kleinnconrad/prototyping.rc.speedrun/readme.md

# 1:10 onroad RC car for speeds over 100 km/h

This project covers the system architecture and configuration of an 1:10 scale on-road touring car with the design goal of a consistently repeatable top speed of over 100 km/h without risking the car to be damaged or destroyed. The focus is on maximizing drive power while ensuring reliability and cost efficiency.

The technical challenge primarily results from the chosen scale and the limited tire diameter of 64 millimeters. While vehicles from 1:8+ scale have strong physical advantages due to higher mass inertia, larger rolling circumferences, and a longer wheelbase, the 1:10 scale requires significantly higher rotor speeds. This leads to high mechanical stresses in the drivetrain. The low vehicle weight also requires precise aerodynamic and suspension tuning to ensure driving stability at high speeds.

The artefacts of this repository are:
* Architecture decision records (ADRs) in the `/architecture` directory
* System specification in the `specs/full_spec.yaml` file
* Vehicle setup configurations in the `/setup_sheets` directory
* CAD designs of the speedrun chassis (chassis plate, bulkheads, top brace, shock towers and their assembly) and 3D print files in the `/cad` directory: STEP, STL and DXF files, parameter files and drawings, described in the [CAD readme](cad/readme.md)

<table>
  <tbody>
    <tr>
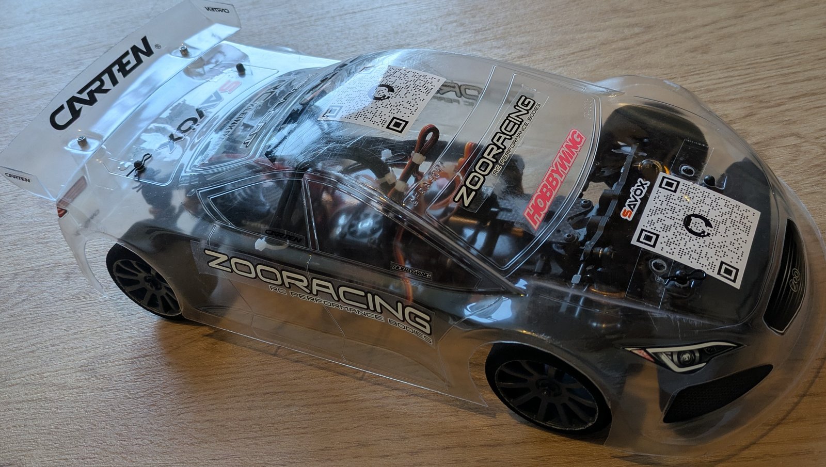
[picture p1: photos/rc_car.jpg]
RC car with clear body
      <td colspan="2"></td>
    </tr>
  </tbody>
  <tbody>
    <tr>
      <td width="37%">RC car chassis without body, front view</td>
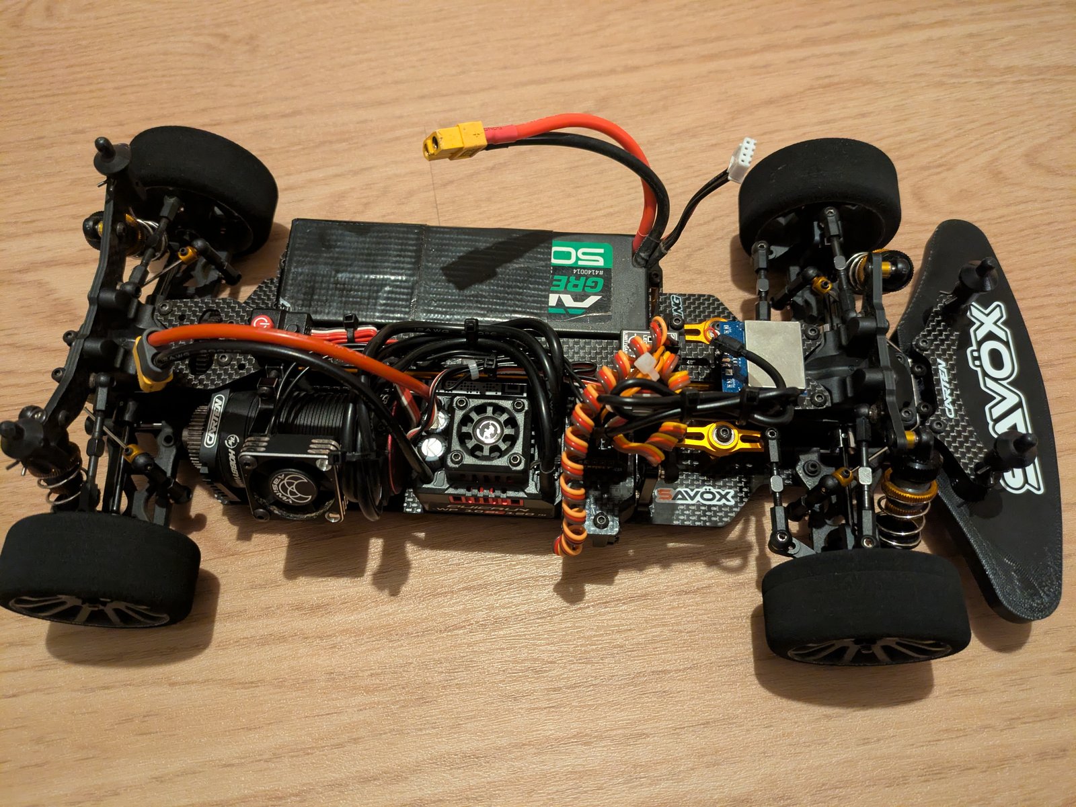
[picture p2: photos/rc_car_chassis_top_view_battery.jpg]
RC car chassis without body, top view
      <td width="63%"></td>
    </tr>
  </tbody>
</table>

## Table of contents
* [Latest setup drawing](#latest-setup-drawing)
* [Speedrun chassis design](#speedrun-chassis-design)
* [Repository structure](#repository-structure)
* [Artefacts (ADR, specs, setup sheets)](#artefacts-adr-specs-setup-sheets)
* [Calculation models for drivetrain design](#calculation-models-for-drivetrain-design)
* [Learnings & modifications](#learnings--modifications)
* [Repository automation](#repository-automation)
* [Follow-up project: Telemetry system](#follow-up-project-telemetry-system)
* [Copyright](#copyright)

## Latest setup drawing
The technical drawing shows the configuration of the latest setup sheet in a side view, a plan view and views of the front and rear axle. It also contains all setup parameters, values derived from them and the changes between the setup sheet versions. Values in orange are taken from the setup sheet, the chassis dimensions from the Carten T410R specification. Component positions are schematic.

The drawing is generated by `scripts/generate_setup_drawing.py` and is updated automatically when a new setup sheet is pushed to the main branch. The setup dashboard on GitHub Pages shows the same drawing in a dark variant.

Technical drawing of the latest Carten T410R setup

## Speedrun chassis design
The speedrun chassis is designed in this project for speeds over 100 km/h. It consists of a wide aluminium chassis plate that matches the body, new bulkheads (gear boxes) for CNC manufacturing from 7075, a new top brace and new front and rear shock towers. The parts share their interfaces with the stock parts of the Carten T410R: bearings, gears, suspension and screws are not changed.

**Motivation for the speedrun parts:**
* Aluminium: the parts are designed so that they can be made from aluminium. The aluminium parts increase the stability of the car.
* CNC machining: the chassis plate (6082) is CNC machined because of the precision required for its countersunk holes (6.2 mm, on the underside). The bulkheads (7075) are three-dimensional parts with bearing seats, gear cavities, tapped holes and several levels. They cannot be laser cut and are CNC milled (3 setups on a 3-axis machine).
* Laser cutting: the top brace (2 mm) and the shock towers (3 mm) are flat plates with plain holes, so that they can be laser cut from aluminium or another material of choice (for example carbon). The outline and the holes are taken from the DXF files. The edge and hole chamfers and the relief on the back face of the shock towers (clearance to the root radius of the wall of the upper bulkhead) are a second machining step.
* Simple design: a further goal is a simplified design of the bulkheads, the shock towers and the top brace with flat faces, straight edges and radii.
* Chassis plate: apart from the material, the speedrun chassis plate is designed to match the ZooRacing Hellcat body (190 mm). It also gives more space for further developments: a battery with 4S or 6S instead of 3S, a dual motor setup and the custom [telemetry system](#follow-up-project-telemetry-system).
* Stock parts: the other parts of the car are not modelled. For these parts, the stock parts of the manufacturer are used, since this is the technically and economically reasonable solution. Only the stock parts that are needed for the completeness of the build are modelled (`cad/stock_parts`): the pivot blocks of the wishbones, the centre driveshaft with its cup joints, the rear pinion shaft with the spur gear and the bearing, the motor mount with its cap, the diff outdrives and the wishbones with their hinge pins. They are not part of the speedrun design and are modelled for the completeness of the build.

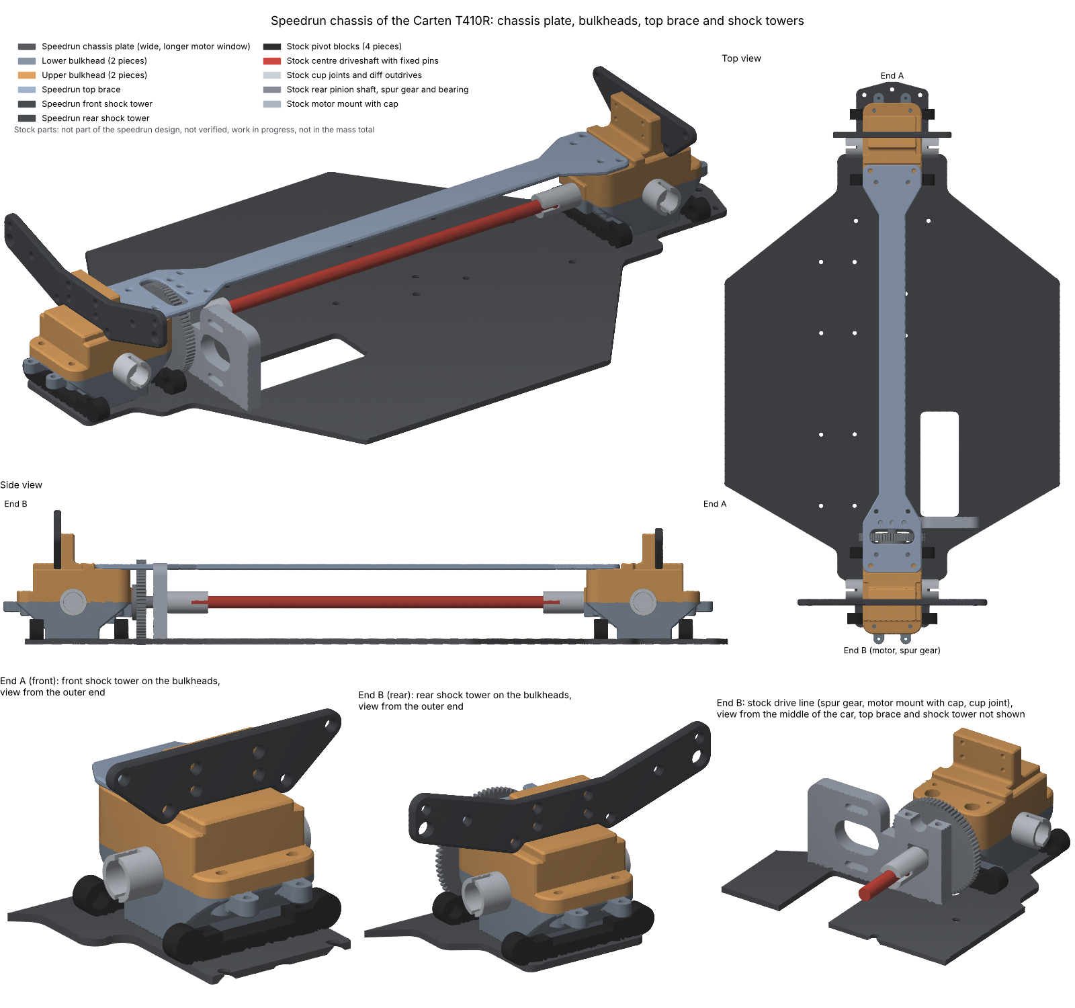
[picture p3: photos/cad_speedrun_chassis_assembly.png]
Speedrun chassis: chassis plate, bulkheads, top brace and shock towers


| Part | Quantity | Status | Mass |
|:---|---:|:---|---:|
| Speedrun chassis plate (wide) with longer motor window | 1 | $\color{green}\checkmark$ Verified | 217 g (aluminium 6082) |
| Lower bulkhead | 2 | $\color{green}\checkmark$ Verified | 2 x 34 g (7075) |
| Upper bulkhead | 2 | $\color{green}\checkmark$ Verified | 2 x 53 g (7075) |
| Speedrun top brace | 1 | $\color{green}\checkmark$ Verified | 14 g (carbon) |
| Speedrun front shock tower | 1 | $\color{green}\checkmark$ Verified | 4.4 g (carbon) |
| Speedrun rear shock tower | 1 | $\color{green}\checkmark$ Verified | 7.6 g (carbon) |
| **Total** | | | **417 g** |

Stock parts of the Carten T410R, modelled for the completeness of the build (not part of the speedrun design, not in the mass total):

| Stock part | Quantity | Status | Directory |
|:---|---:|:---|:---|
| Pivot blocks of the wishbones (long and short block) | 4 | $\color{red}\times$ Completely unqualified | `cad/stock_parts/pivot_block` |
| Centre driveshaft with fixed metal pins | 1 | $\color{gold}\blacktriangle$ Measures qualified, no 3D print verification | `cad/stock_parts/driveshaft` |
| Cup joints of the centre driveshaft (NBA255) | 2 | $\color{red}\times$ Completely unqualified | `cad/stock_parts/driveshaft` |
| Rear pinion shaft with pinion 17T, spur gear 72T, bearings and retaining pin (NBA205, NBA207, NBA252, NBA298, NBA255) | 1 | $\color{gold}\blacktriangle$ Measures qualified, no 3D print verification | `cad/stock_parts/rear_drive` |
| Front pinion shaft with pinion 17T, bearings and retaining pin (NBA205, NBA207, NBA298, NBA255) | 1 | $\color{gold}\blacktriangle$ Measures qualified, no 3D print verification | `cad/stock_parts/front_drive` |
| Motor mount with cap (NBA201) | 1 | $\color{gold}\blacktriangle$ Measures qualified, no 3D print verification | `cad/stock_parts/motor_mount` |
| Differential (End B) with ring gear 42T, inner gears and bearings NBA299 | 1 | $\color{gold}\blacktriangle$ Measures qualified, no 3D print verification | `cad/stock_parts/diff` |
| Spool (End A) with ring gear 42T and bearings NBA299 | 1 | $\color{gold}\blacktriangle$ Measures qualified, no 3D print verification | `cad/stock_parts/diff` |
| Diff outdrives | 4 | $\color{red}\times$ Completely unqualified | `cad/stock_parts/diff_outdrive` |
| Front wishbones (NHA402) | 2 | $\color{gold}\blacktriangle$ Measures qualified, no 3D print verification | `cad/stock_parts/wishbone` |
| Rear wishbones (NHA402) | 2 | $\color{gold}\blacktriangle$ Measures qualified, no 3D print verification | `cad/stock_parts/wishbone` |
| Inner hinge pins of the wishbones (NHA423 3x42) | 4 | $\color{red}\times$ Completely unqualified | `cad/stock_parts/wishbone` |

* Status: $\color{green}\checkmark$ verified (test print or on the car), $\color{gold}\blacktriangle$ measures qualified, no 3D print verification, $\color{red}\times$ completely unqualified. All parts of the speedrun design are verified. Of the stock parts, the motor mount, the centre driveshaft, the rear drive line and the wishbones are qualified by measurements (caliper and photos of the owner); the other stock parts are not qualified. The bulkheads have radii and edge chamfers on the outer side for CNC milling; the inside of the parts is the verified geometry (see [edges of the outer shape](cad/readme.md#design-of-the-lower-bulkhead)). The stock shock tower plates do not fit the speedrun upper bulkhead; the [speedrun shock towers](cad/readme.md#speedrun-shock-towers) are designed for it. All holes of the towers are at the positions of the stock towers; the shock tower wall of the upper bulkhead is narrowed so that the rod ends of the camber links have space beside it. The status of each part, the open points and all files are described in the [CAD readme](cad/readme.md#speedrun-chassis).
* The legend lists the colours of the speedrun parts and of the stock parts. The inset at the right of the 3D view shows the differential at End B in section with the pinion (the design of the differential: [CAD readme](cad/readme.md#differentials)). The bottom row shows close-ups of End A and End B from the outer end and of the stock drive line at End B (spur gear, motor mount with cap, cup joint) from the middle of the car, without the top brace and the shock tower.
* The assembly is available as a STEP file (`cad/assembly/speedrun_chassis_T410R.step`).

## Repository structure
* **`/architecture`**: Documentation of basic system designs
* **`/cad`**: CAD data and 3D print files
  * **`/assembly`**: Assembly of the speedrun chassis (STEP)
  * **`/bulkhead`**: Lower and upper bulkhead (STEP, STL, test print files, parameter files, measurement sheets)
  * **`/shock_tower`**: Front and rear shock tower for the speedrun upper bulkhead (STEP, STL, DXF, PDF templates, geometry data, parameter file)
  * **`/stock_parts`**: Models of stock parts of the Carten T410R, not part of the speedrun design, modelled for the completeness of the build
    * **`/pivot_block`**: Pivot blocks of the wishbones (STEP, STL, parameter file)
    * **`/driveshaft`**: Centre driveshaft with the fixed metal pins and the cup joints (STEP, STL, parameter file)
    * **`/rear_drive`**: Rear pinion shaft, pinion, spur gear 72T, bearing and retaining pin (STEP, STL)
    * **`/front_drive`**: Front pinion shaft (STEP, STL)
    * **`/motor_mount`**: Motor mount for 540 motors and its cap (STEP, STL)
    * **`/diff`**: Differential (case, ring gear 42T, inner gears, shims, bearing) and spool (STEP, STL)
    * **`/diff_outdrive`**: Diff outdrive (STEP, STL)
    * **`/wishbone`**: Front and rear wishbones and the inner hinge pin (STEP, STL, parameter file)
  * **`/chassis`**: Chassis plate, wide speedrun chassis plate, top brace and speedrun top brace with one subdirectory per part (STEP, STL, DXF, OpenSCAD, 1:1 templates, test print files)
* **`/docs`**: Static web dashboard for visualizing the latest setup configurations
* **`/photos`**: Central directory for all image files
* **`/project`**: General project information
  * **`/costs`**: Cost tracking
  * **`/follow_up_projects`**: Documentation of related follow-up projects
* **`/scripts`**: Automation scripts
  * **`/cad`**: CAD scripts (geometry data, STEP, STL and DXF generation, bulkheads, assembly, checks, drawings, print templates)
  * **`/calc`**: Calculation scripts
  * **`/plots`**: Plot scripts
* **`/setup_sheets`**: Vehicle setup configurations
* **`/specs`**: Specifications of the vehicle components
  * **`/electronics`**: Selection and specification of electronic components such as motors, electronic speed controllers, and batteries
  * **`/mechanics`**: Chassis design and specification of physical components
* **`/testing`**: Test results and performance measurement data
  * **`/error_list`**: Error logs and their resolutions
  * **`/tests`**: Logs and data of test drives

## Artefacts (ADR, specs, setup sheets)
The documentation of architecture decisions (ADRs), the specifications of all mechanical and electronic components, and the vehicle setup configurations are consistently maintained as structured YAML files (`.yml` or `.yaml`). The formal hierarchical structure of these artefacts is standardized as follows:

```mermaid
classDiagram
    class adr {
        +id: String
        +title: String
        +status: String
        +date: Date
        +context: Text
        +decision: String
        +rationale: Text
        +consequences: List
    }
    class adr_alternative {
        +option_id: Integer
        +name: String
        +type: String
        +evaluation: Text
    }
    adr *-- adr_alternative : considered_alternatives
    
    class spec {
        +properties: Object
        +integration_notes: Object
    }
    class spec_meta {
        +brand: String
        +model: String
        +type: String
    }
    spec *-- spec_meta : meta

    class setup {
    }
    class setup_meta {
        +date: Date
        +description: String
        +version: String
        +top_speed_kmh: Float
    }
    class setup_properties {
        +suspension_and_geometry: Object
        +drivetrain: Object
        +electronics_and_control: Object
    }
    setup *-- setup_meta : meta
    setup *-- setup_properties : properties
```

## Calculation models for drivetrain design
To avoid thermal or mechanical overload of the electronic components, custom-developed calculation models are used:
* **Gearing calculator (`scripts/calc/gearing_calc.py`)**: Simulates the mechanical wheel load for the motor based on tire diameter and target speed, depending on available motor pinions. Setups are categorized into load zones for the defined drive system.
* **Limit calculator (`scripts/calc/max_speed.py`)**: Calculates the achievable top speed considering specific motor data, battery voltage, and defined thermal tolerance limits based on physical hardware specifications.

## Learnings & modifications
This section documents the findings from previous tests & speedruns in 1:10 scale as well as the resulting modifications to the vehicle. Each area can be expanded.

| Area | Learnings | Modifications |
|:---|---:|---:|
| Driving operation & environment | 4 | 0 |
| Suspension & geometry | 2 | 5 |
| Drivetrain | 3 | 3 |
| Electronics & control | 5 | 0 |
| Chassis & assembly | 5 | 2 |
| **Total** | **19** | **10** |

<details>
<summary><b>Driving operation & environment</b></summary>

| Type | Topic | Finding |
|:---|:---|:---|
|  | Track selection | A suitable track is crucial for success. Clean asphalt is absolutely necessary. The track should preferably not be bordered by walls or curbs. A minimum width of 8 meters is required. |
|  | Weather | The weather is also important. Ensure there is no wind and conditions are dry. |
|  | Safety | If the conditions are not right and you don't have a good feeling, no speedrun should be undertaken. |
|  | Driving practice | You must learn to drive. It is necessary to familiarize yourself with the vehicle and the acceleration curve. It is important to steer the vehicle smoothly when it is far away. |

</details>

<details>
<summary><b>Suspension & geometry</b></summary>

| Type | Topic | Finding |
|:---|:---|:---|
|  | Dampers & springs | Very viscous shock oil was used and spring preload maximized. Stiff suspension is absolutely necessary to prevent loss of control due to diving. |
|  | Suspension geometry | Rear toe-in of 2.5 degrees and 0 degrees camber. Front 0 degrees toe-in and 0 degrees camber. No experiments should be made here. |
|  | Sway bars | The sway bars were removed. They are unnecessary for speedruns and pose a potential source of error. |
|  | Droop screws | The droop screws were removed. Since the track is not manually cleaned, further lowering is not constructive. The screws are unnecessary for the regular 1:10 speedrun. |
|  | Weight distribution | Care must be taken to ensure an even left/right weight distribution. Furthermore, the front must not be too light. |
|  | Caster (front) | The caster on the front axle must be set correctly. Caster is important for stability when driving in a straight line. |
|  | Caster (front) | The front caster was increased from the stock setting to approximately 10 degrees by shimming the front pivot block accordingly. |

</details>

<details>
<summary><b>Drivetrain</b></summary>

| Type | Topic | Finding |
|:---|:---|:---|
|  | Motorization | Sufficient motorization is less of a problem than often assumed. You shouldn't invest too much here. |
|  | Motor & gearing | Use of a 3660 motor with a tall gear ratio instead of the usual 3650 motor. The motorization must be adapted to the available track. |
|  | Differential (front) | A front spool was installed. During straight-line running at maximum speed, diff-out must be absolutely avoided; speed compensation is not desired. |
|  | Differential (rear) | Making the rear differential stiffer is not necessary. The front spool is sufficient. |
|  | Thermal management | Problems with ESC and motor temperature have not occurred yet. The problem is apparently overrated. |
|  | Motor cooling | The motor cooling was removed. The motor does not heat up significantly during speedruns and drives the final drive ratio of 3.91 without problems. A fan is mounted for visual reasons only and is not required for cooling. |

</details>

<details>
<summary><b>Electronics & control</b></summary>

| Type | Topic | Finding |
|:---|:---|:---|
|  | Control components | **Do not skimp on the remote control and servo**. Lack of precision makes steering corrections a game of chance. You must invest in a remote control with hall sensors and a decent digital servo. |
|  | Assistance systems | **Using a gyro really makes a difference** and is highly recommended. |
|  | Steering mechanics | The steering mechanism must move without resistance when disconnected from the servo. Mechanical resistance prevents the servo from returning precisely to the neutral position during slow steering inputs. In this state, the servo stops visibly but continues to draw current, indicated by audible noise, as it attempts to reach the neutral position. |
|  | `Steering Exponential Curve` (cubic polynomial) | The steering exponential curve requires precise configuration. A setting of approximately -30 is recommended. |
|  | `Throttle Exponential Curve` (cubic polynomial) | The throttle exponential curve requires precise configuration. A setting of approximately -40 is recommended. |

</details>

<details>
<summary><b>Chassis & assembly</b></summary>

| Type | Topic | Finding |
|:---|:---|:---|
|  | Material selection | Not all plastic parts should be replaced with aluminum. You must consider which parts are allowed to be destroyed in a crash. If easily replaceable plastic parts are replaced with aluminum, the impact energy finds more unfavorable paths. |
|  | Threadlocker | Loctite on metal connections is absolutely mandatory. |
|  | Body | The body should not be painted. A clear body allows a necessary view of the technology at all times. |
|  | Aerodynamics | A wedge shape of the vehicle is necessary for efficient aerodynamics. To achieve this, the front body posts must be shortened as much as possible. |
|  | C-hub assembly | The mounting screws of the C-hubs were loosened to eliminate mechanical resistance. Excessive tightening prevents the steering from moving freely, resulting in the previously described issue of an inaccurate servo neutral return. |
|  | Servo saver | The servo saver was removed and an aluminum servo horn was mounted directly. This increases the risk of damage to the servo in the event of a crash. The servo saver was identified as a source of failure (steering oscillation) during speedruns. |
|  | Tires | Belted tires avoid ballooning but do not provide sufficient stability and grip for speedruns. The use of foam rubber tires increases stability and grip. |

</details>

[badge-learning]: https://img.shields.io/badge/learning-0e8a16?style=flat-square
[badge-modification]: https://img.shields.io/badge/modification-b60205?style=flat-square

## Repository automation
Maintaining the specifications, architecture decisions and setup sheets formatted as YAML files triggers automated processes:
* **Aggregation of specifications**: Individual hardware specifications are merged into the central specification file `specs/full_spec.yaml`.
* **Decision log**: Architecture decisions are automatically compiled into an overview sorted by ID (`architecture/README.md`).
* **Setup dashboard**: The setup dashboard on GitHub Pages shows the dark variant of the setup drawing. The latest setup sheet is also published there as data file (`docs/latest_setup.json`).
* **Setup drawing**: The latest setup sheet is converted to the technical drawing `photos/latest_setup_drawing.svg`, which is shown in this readme, and to a dark variant `docs/latest_setup_drawing.svg` for the setup dashboard.

The bill of materials (`project/costs`) is maintained manually.

## Follow-up project: Telemetry system
This project is followed by an independent project concerned with the development of a telemetry data system based on an ESP32 microcontroller. The goal is the sensory recording and transmission of driving dynamics parameters of the RC vehicle.



## Copyright
* Copyright (c) 2026 Conrad Kleinn. All rights reserved.
* The designs, CAD files, source code, documentation, specifications and test results in this repository are not licensed for use by others. Using, copying, modifying or distributing them requires the written permission of the author.
* Third-party files in the `cad` directory are subject to the licenses of their authors (see the readme in that directory).
