kleinnconrad/prototyping.rc.speedrun/cad/readme.md

# CAD and 3D print files

## Table of contents
* [Overview](#overview)
* [Speedrun chassis](#speedrun-chassis)
  * [Parts of the speedrun chassis](#parts-of-the-speedrun-chassis)
  * [Assembly file](#assembly-file)
* [Chassis plate and top brace](#chassis-plate-and-top-brace)
  * [Parts, files and coordinate system](#parts-files-and-coordinate-system)
  * [Measurement basis and test print](#measurement-basis-and-test-print)
  * [Open points](#open-points)
* [Speedrun chassis plate (wide)](#speedrun-chassis-plate-wide)
  * [Print template](#print-template)
  * [Longer motor window for a 3660 motor](#longer-motor-window-for-a-3660-motor)
* [Speedrun top brace](#speedrun-top-brace)
  * [Design and fit of the speedrun top brace](#design-and-fit-of-the-speedrun-top-brace)
  * [Files and open points of the speedrun top brace](#files-and-open-points-of-the-speedrun-top-brace)
* [Lower bulkhead](#lower-bulkhead)
  * [Interfaces and files of the lower bulkhead](#interfaces-and-files-of-the-lower-bulkhead)
  * [Measurement basis and test print of the lower bulkhead](#measurement-basis-and-test-print-of-the-lower-bulkhead)
  * [Design of the lower bulkhead](#design-of-the-lower-bulkhead)
  * [Open points of the lower bulkhead](#open-points-of-the-lower-bulkhead)
* [Upper bulkhead (new design)](#upper-bulkhead-new-design)
  * [Interfaces and design of the upper bulkhead](#interfaces-and-design-of-the-upper-bulkhead)
  * [Files and measurement sheet of the upper bulkhead](#files-and-measurement-sheet-of-the-upper-bulkhead)
  * [Open points of the upper bulkhead](#open-points-of-the-upper-bulkhead)
* [Speedrun shock towers](#speedrun-shock-towers)
  * [Design and fit of the speedrun shock towers](#design-and-fit-of-the-speedrun-shock-towers)
  * [Files and open points of the speedrun shock towers](#files-and-open-points-of-the-speedrun-shock-towers)
* [Stock parts (not part of the speedrun design)](#stock-parts-not-part-of-the-speedrun-design)
  * [Pivot blocks](#pivot-blocks)
  * [Centre driveshaft and drive line](#centre-driveshaft-and-drive-line)
  * [Differentials](#differentials)
  * [Wishbones](#wishbones)
* [Scripts](#scripts)
  * [Regenerating the files](#regenerating-the-files)
  * [DXF generation](#dxf-generation)
* [3D printed parts](#3d-printed-parts)
* [Sources](#sources)

## Overview
This directory contains CAD data and 3D print files for the RC car **Carten T410R**:
* **`/chassis`**: CAD data of the chassis plate and the top brace, with one subdirectory per part:
  * **`/chassis_plate`**: Chassis plate (STEP, STL, DXF, OpenSCAD, PDF templates, geometry data, hole table)
  * **`/top_brace`**: Top brace (STEP, STL, DXF, OpenSCAD, PDF template, geometry data, hole table)
  * **`/test_print`**: STL files of the chassis plate and the top brace for a test print on a home 3D printer
  * **`/chassis_plate_speedrun_wide`**: Wide variant of the chassis plate for speedruns (STEP, STL, PDF template, geometry data)
  * **`/chassis_plate_speedrun_wide_motor10`**: Wide variant with a longer motor window for a 3660 motor (STEP, STL, DXF, PDF template, geometry data)
  * **`/top_brace_speedrun`**: New design of the top brace that matches the bulkheads of this project (STEP, STL, DXF, PDF templates, geometry data, hole table, test print STL files)
* **`/bulkhead`**: CAD data of the bulkheads (gear boxes): lower bulkhead, upper bulkhead (new design) and the assembly of both parts (STEP, STL, test print STL, parameter files, measurement sheets).
* **`/shock_tower`**: New design of the front and the rear shock tower that match the speedrun upper bulkhead (STEP, STL, DXF, PDF templates, geometry data, parameter file, hole table).
* **`/stock_parts`**: Models of stock parts of the Carten T410R. They are not part of the speedrun design and are modelled for the completeness of the build.
  * **`/pivot_block`**: Pivot blocks of the wishbones (STEP, STL, parameter file).
  * **`/driveshaft`**: Centre driveshaft with the fixed metal pins and the cup joints (STEP, STL, parameter file of all drive line parts).
  * **`/rear_drive`**: Rear pinion shaft with flange, pinion 17T, spur gear 72T, bearing 5x10x4 and retaining pin (STEP, STL).
  * **`/front_drive`**: Front pinion shaft (STEP, STL).
  * **`/motor_mount`**: Motor mount for 540 motors and its cap (STEP, STL).
  * **`/diff`**: Differential case, ring gear 42T and bearing NBA299 (STEP, STL).
  * **`/diff_outdrive`**: Diff outdrive (STEP, STL).
  * **`/wishbone`**: Front and rear wishbones and the inner hinge pin (STEP, STL, parameter file).
* **`/assembly`**: Assembly of the speedrun chassis: chassis plate, bulkheads, top brace and shock towers, completed with the stock parts: pivot blocks, centre driveshaft and drive line, motor mount, diff outdrives, wishbones with hinge pins (STEP).
* **STL files in this directory**: 3D printed parts for the car and a maintenance stand

Own files are not licensed for use by others, all rights are reserved (see the root readme). Third-party files are subject to the licenses of their authors (see [sources](#sources)). The preview images of all parts are stored in the `/photos` directory of the repository.

## Speedrun chassis
The speedrun chassis combines the parts that are designed in this project for speeds over 100 km/h. The parts share their interfaces: the bulkheads are mounted on the hole patterns of the chassis plate, the top brace on the contact faces of both upper bulkheads, the shock towers on the shock tower walls of the upper bulkheads (front tower at End A, rear tower at End B).

Speedrun chassis: chassis plate, bulkheads, top brace and shock towers

### Parts of the speedrun chassis
| Part | Quantity | Directory | Status | Material | Mass |
|:---|---:|:---|:---|:---|---:|
| [Speedrun chassis plate (wide) with longer motor window](#longer-motor-window-for-a-3660-motor) | 1 | `/chassis/chassis_plate_speedrun_wide_motor10` | $\color{green}\checkmark$ Verified | Aluminium 6082 or carbon | 217 g (6082), 128 g (carbon) |
| [Lower bulkhead](#lower-bulkhead) | 2 | `/bulkhead` | $\color{green}\checkmark$ Verified | 7075 | 2 x 34 g |
| [Upper bulkhead](#upper-bulkhead-new-design) | 2 | `/bulkhead` | $\color{green}\checkmark$ Verified | 7075 | 2 x 53 g |
| [Speedrun top brace](#speedrun-top-brace) | 1 | `/chassis/top_brace_speedrun` | $\color{green}\checkmark$ Verified | Carbon or 7075 | 14 g (carbon), 25 g (7075) |
| [Speedrun front shock tower](#speedrun-shock-towers) | 1 | `/shock_tower` | $\color{green}\checkmark$ Verified | Carbon or 7075 | 4.4 g (carbon), 7.7 g (7075) |
| [Speedrun rear shock tower](#speedrun-shock-towers) | 1 | `/shock_tower` | $\color{green}\checkmark$ Verified | Carbon or 7075 | 7.6 g (carbon), 13.4 g (7075) |
| **Total** | | | | Chassis plate 6082, bulkheads 7075, top brace and shock towers carbon | **417 g** |

Stock parts of the Carten T410R, modelled for the completeness of the build (not part of the speedrun design, not in the mass total):

| Stock part | Quantity | Directory | Status |
|:---|---:|:---|:---|
| [Pivot blocks of the wishbones](#pivot-blocks) (long and short block) | 4 | `/stock_parts/pivot_block` | $\color{red}\times$ Completely unqualified |
| [Centre driveshaft with fixed metal pins](#centre-driveshaft-and-drive-line) | 1 | `/stock_parts/driveshaft` | $\color{gold}\blacktriangle$ Measures qualified, no 3D print verification |
| [Cup joints of the centre driveshaft (NBA255)](#centre-driveshaft-and-drive-line) | 2 | `/stock_parts/driveshaft` | $\color{red}\times$ Completely unqualified |
| [Rear pinion shaft with pinion 17T, spur gear 72T, bearings and retaining pin (NBA205, NBA207, NBA252, NBA298, NBA255)](#centre-driveshaft-and-drive-line) | 1 | `/stock_parts/rear_drive` | $\color{gold}\blacktriangle$ Measures qualified, no 3D print verification |
| [Front pinion shaft with pinion 17T, bearings and retaining pin (NBA205, NBA207, NBA298, NBA255)](#centre-driveshaft-and-drive-line) | 1 | `/stock_parts/front_drive` | $\color{gold}\blacktriangle$ Measures qualified, no 3D print verification |
| [Motor mount with cap (NBA201)](#centre-driveshaft-and-drive-line) | 1 | `/stock_parts/motor_mount` | $\color{gold}\blacktriangle$ Measures qualified, no 3D print verification |
| [Differential (End B) with ring gear 42T, inner gears and bearings NBA299](#differentials) | 1 | `/stock_parts/diff` | $\color{gold}\blacktriangle$ Measures qualified, no 3D print verification |
| [Spool (End A) with ring gear 42T and bearings NBA299](#differentials) | 1 | `/stock_parts/diff` | $\color{gold}\blacktriangle$ Measures qualified, no 3D print verification |
| [Diff outdrives](#centre-driveshaft-and-drive-line) | 4 | `/stock_parts/diff_outdrive` | $\color{red}\times$ Completely unqualified |
| [Front wishbones (NHA402)](#wishbones) | 2 | `/stock_parts/wishbone` | $\color{gold}\blacktriangle$ Measures qualified, no 3D print verification |
| [Rear wishbones (NHA402)](#wishbones) | 2 | `/stock_parts/wishbone` | $\color{gold}\blacktriangle$ Measures qualified, no 3D print verification |
| [Inner hinge pins of the wishbones (NHA423 3x42)](#wishbones) | 4 | `/stock_parts/wishbone` | $\color{red}\times$ Completely unqualified |

Status: $\color{green}\checkmark$ verified (test print or on the car), $\color{gold}\blacktriangle$ measures qualified, no 3D print verification, $\color{red}\times$ completely unqualified.

* The masses are calculated from the volumes of the solid models (6082: 2.70 g/cm³, 7075: 2.81 g/cm³, carbon: 1.6 g/cm³). Screws, bearings and the other parts of the car are not included.
* The bulkheads are the same parts at both ends. At End A, they are rotated by 180 degrees, so that both pinions point to the middle of the car.
* The end of the top brace with the obround is at End B (motor window, spur gear). End A is assumed to be the front (see [open points of the lower bulkhead](#open-points-of-the-lower-bulkhead)).

### Assembly file
* `assembly/speedrun_chassis_T410R.step`: assembly of the 8 parts of the speedrun chassis and 50 stock parts (pivot blocks, wishbones with hinge pins, centre driveshaft with cup joints, rear and front drive line with pinions, bearings and retaining pins, spur gear, motor mount with cap, the differential with its inner parts and the spool with the ring gears and bearings, 4 diff outdrives) in the coordinate system of the chassis plate (STEP AP214, one solid per part; the 3 shims behind each side gear are one solid).
* The stock parts are not part of the speedrun design and are not in the mass total (see [stock parts](#stock-parts-not-part-of-the-speedrun-design)).
* The interference check of all pairs of parts gives 0 mm³, except 0.82 mm³ between the lower bulkhead at End B and the long pivot block (see [pivot blocks](#pivot-blocks)) and 2.16 mm³ between the lower bulkhead at End A and each front wishbone (inner lugs 0.14 mm into the side face, see [wishbones](#wishbones)).
* The assembly file and the image are generated with the script `generate_speedrun_assembly.py` (see [scripts](#scripts)) from the files of the parts.
* The image shows an overall view with an inset of the differential at End B in section (with the pinion), a side view, a top view and three close-ups:
  * both ends with the bulkheads, the shock tower and the end of the top brace, seen from the outer end;
  * the stock drive line at End B (spur gear, motor mount with cap, cup joint), seen from the middle of the car, without the top brace and the shock tower.

## Chassis plate and top brace
* **Author:** [@kleinnconrad](https://github.com/kleinnconrad)
* **Description:** CAD models of the chassis plate and the top brace of the Carten T410R. The geometry is derived from photos of the original parts and scaled to caliper measurements (see [measurement basis](#measurement-basis-and-test-print)).
* **Status:** $\color{green}\checkmark$ Verified with a test print. The printed chassis plate and top brace fit the car, the hole positions and the overall lengths are correct (see [test print](#measurement-basis-and-test-print)).

Top view of the chassis plate and the top brace with hole labels

### Parts, files and coordinate system
| Part | Size (width × length × thickness) | Holes | Cutouts | Volume |
|:---|:---|:---|:---|---:|
| Chassis plate | 100.0 × 325.6 × 2.0 mm | 36 through holes Ø3.2 mm (H01 to H36), countersunk Ø6.2 mm × 90° on the bottom face | Window approx. 23.5 × 53.3 mm, slot approx. 22.3 × 6.7 mm | 49.4 cm³ |
| Top brace | 38.0 × 243.3 × 2.0 mm | 15 through holes Ø3.2 mm (B01 to B15), not countersunk | Hexagon, short slot approx. 3.2 × 17.5 mm, long slot approx. 3.2 × 88.2 mm, obround approx. 27.0 × 9.3 mm | 7.8 cm³ |

* The width of the main section of the chassis plate is 99.98 mm. The bar of the top brace is 15.09 mm wide.
* The hole diameter of 3.2 mm is the clearance hole for M3 screws.
* Sizes and volumes are taken from the STL files. The cutout sizes are approximate values from the geometry data.

**Files**

The files of the chassis plate are stored in the directory `/chassis/chassis_plate`, the files of the top brace in `/chassis/top_brace` and the test print files in `/chassis/test_print`. The STEP, STL, DXF, OpenSCAD and PDF files and the hole tables are generated from the geometry data (`*_geometry.json`). The DXF files can be regenerated with a script (see [DXF generation](#dxf-generation)). The PDF templates and the drawing `photos/cad_chassis_drawing.png` are generated with the script `generate_chassis_templates.py` (see [scripts](#scripts)).

| File | Format | Use |
|:---|:---|:---|
| `chassis_plate_T410R.step`, `top_brace_T410R.step` | STEP (AP214) | Solid models for CAD programs |
| `chassis_plate_T410R.stl`, `top_brace_T410R.stl` | STL (binary) | Complete parts as triangle meshes |
| `testprint_chassis_plate_halfA.stl`, `testprint_chassis_plate_halfB.stl` | STL (binary) | Chassis plate in two halves for the test print |
| `testprint_top_brace_halfA.stl`, `testprint_top_brace_halfB.stl` | STL (binary) | Top brace in two halves for the test print |
| `chassis_plate_T410R.dxf`, `top_brace_T410R.dxf` | DXF | 2D drawings for CNC manufacturing with the layers `OUTLINE`, `CUTOUT`, `HOLE_THROUGH` and `CSK_BOTTOM_INFO` (countersinks, chassis plate only) |
| `chassis_plate_T410R.scad`, `top_brace_T410R.scad` | OpenSCAD | Parametric models. The parameters `thickness`, `hole_d`, `csk_d` and `csk_angle` are defined at the top of the file. |
| `chassis_plate_T410R_1to1_A3.pdf` | PDF (A3, 1 page) | 1:1 template of the chassis plate |
| `chassis_plate_T410R_1to1_A4x2.pdf` | PDF (A4, 2 pages) | 1:1 template of the chassis plate on two A4 sheets (portrait) with a 20 mm overlap zone |
| `top_brace_T410R_1to1_A4.pdf` | PDF (A4, 1 page) | 1:1 template of the top brace |
| `chassis_plate_T410R_1to1_A3_print97.pdf`, `chassis_plate_T410R_1to1_A4x2_print97.pdf`, `top_brace_T410R_1to1_A4_print97.pdf` | PDF | The same templates pre-scaled to 103.09 % for a PDF viewer that prints at 97 % |
| `chassis_plate_hole_table.csv`, `top_brace_hole_table.csv` | CSV | Hole coordinates (x, y), through hole diameter and countersink diameter |
| `chassis_plate_geometry.json`, `top_brace_geometry.json` | JSON | Geometry data: outline, cutouts, holes, thickness and countersink parameters |

The PDF templates without suffix must be printed at 100 % scale. The templates with the suffix `_print97` are pre-scaled to 103.09 % (100/97) and must be printed at 97 %: printed at 97 %, the drawing is 1:1. The 100 mm bars on each page are used to check the scale. For a PDF viewer with another fixed print scale, the script `generate_chassis_templates.py` generates matching templates (options `--print-scale` and `--suffix`).

**Coordinate system**

* Units are millimeters. All coordinates refer to the top view.
* x = 0 is the center line of the part.
* y = 0 is the end edge: on the chassis plate the end with the 2 × 2 hole pattern (holes H01 to H04), on the top brace the end with the hexagon cutout. The OpenSCAD files refer to this edge as the rear end edge.
* z = 0 is the bottom face. The countersinks of the chassis plate are located on the bottom face.

### Measurement basis and test print
The outlines were taken from photos of the original parts and scaled to caliper measurements:
* **Chassis plate:** x scaled by 1.00522 (width of the main section 99.98 mm), y scaled by 1.00609 (distance between the holes H11 and H23 145.82 mm)
* **Top brace:** uniformly scaled by 1.006 (bar width 15.09 mm)
* **Holes:** through holes Ø3.2 mm (measured on the original part: 3.18 mm)
* **Shape:** The window and the slot of the chassis plate are part of the model. Two marks on the surface of the original parts are not holes and are therefore not modelled.

**Test print**

The test print checks the hole positions and the overall length with a home 3D printer before the parts are manufactured. Both parts are split into two halves that are connected with dovetails. The files are stored in the directory `/chassis/test_print`.

**Result:** The test print of the chassis plate and the top brace fits the car. The holes at both ends of both parts align with the mounting points. This confirms the hole positions and the overall lengths of 325.6 mm (chassis plate) and 243.3 mm (top brace).

Test print halves of the chassis plate and the top brace

| File | Size (width × length × thickness) | Split |
|:---|:---|:---|
| `testprint_chassis_plate_halfA.stl` | 100.0 × 168.7 × 2.0 mm | Split at half length (y = 162.8 mm), three dovetails, 0.2 mm joint gap |
| `testprint_chassis_plate_halfB.stl` | 100.0 × 162.7 × 2.0 mm | See half A |
| `testprint_top_brace_halfA.stl` | 34.9 × 97.4 × 2.0 mm | Split at y = 92.5 mm between the short and the long slot, so that the long slot is not cut. One dovetail, 0.2 mm joint gap. |
| `testprint_top_brace_halfB.stl` | 38.0 × 150.7 × 2.0 mm | See half A |

* The halves of the chassis plate are oriented with the top side on the print bed, so that the countersinks face upwards.
* The largest half requires a print area of 100.0 × 168.7 mm.

Recommended procedure:
* Print with 100 % infill.
* Disable the XY hole compensation of the slicer for a true check of the hole positions.
* Printed holes with Ø3.2 mm are usually undersized. Ream them with a 3.2 mm drill before screws are inserted.
* Glue the halves together on a flat surface, preferably on the 1:1 template.
* Check the fit on the car: if the holes at both ends of the parts align with the mounting points, the overall length is correct.

### Open points
There are no open points for the chassis plate and the top brace. The following points were clarified:
* **Overall length:** With the caliper scaling, the chassis plate is 325.6 mm and the top brace 243.3 mm long, while measurements with a ruler resulted in 324 mm and 242 mm. The test print confirms the lengths from the caliper scaling, so the ruler readings were too short.
* **Thickness of the chassis plate:** The chassis specification listed 2.25 mm for the bottom plate. A measurement of the chassis plate of the car with a precise caliper resulted in 2.03 mm, so the value of the specification was wrong. It is corrected in `specs/mechanics/carten_t410r/spec_cartent410r.yaml`. The model uses 2.0 mm. For manufacturing, the thickness is determined by the carbon sheet that is used. The thickness of the model can be changed with the parameter `thickness` in the OpenSCAD file.

## Speedrun chassis plate (wide)
* **Author:** [@kleinnconrad](https://github.com/kleinnconrad)
* **Description:** Variant of the chassis plate for speedruns with a widened middle section. The hole pattern, the countersinks, the window, the slot and both narrow ends are identical to the chassis plate.
* **Files:** `chassis_plate_T410R_speedrun_wide.step` (STEP AP214, one solid), `chassis_plate_T410R_speedrun_wide.stl` (binary STL), `chassis_plate_T410R_speedrun_wide_1to1_A4x2_print97.pdf` (1:1 template, see [print template](#print-template)) and `chassis_plate_speedrun_wide_geometry.json` (geometry data) in the directory `/chassis/chassis_plate_speedrun_wide`. This variant has no DXF, OpenSCAD or test print files. The STEP and STL files are the source data of this variant. The geometry data is derived from the STEP file (see [scripts](#scripts)).

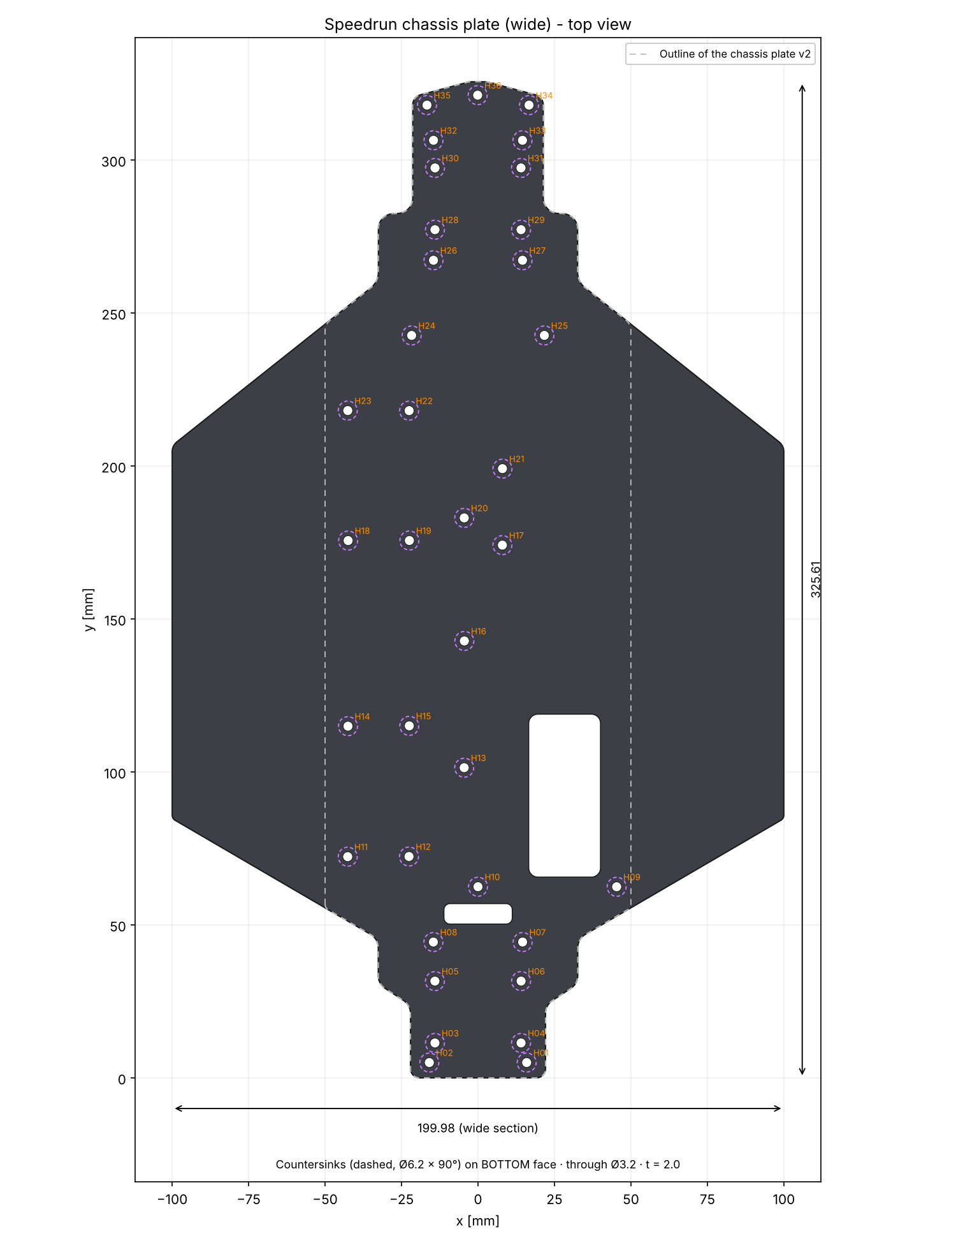
[picture p4: photos/cad_chassis_speedrun_wide_drawing.png]
Top view of the speedrun chassis plate (wide) with hole labels and the outline of the chassis plate


| Property | Chassis plate | Speedrun chassis plate (wide) |
|:---|:---|:---|
| Size (width × length × thickness) | 99.98 × 325.6 × 2.0 mm | 199.98 × 325.6 × 2.0 mm |
| Holes | 36 through holes Ø3.2 mm, countersunk Ø6.2 mm × 90° on the bottom face | Identical |
| Cutouts | Window and slot | Identical |
| Volume | 49.4 cm³ | 80.7 cm³ |

The outline differs from the chassis plate only between y = 55.3 mm and y = 246.5 mm (coordinate system as for the chassis plate, see [coordinate system](#parts-files-and-coordinate-system)):

| Section | Position (y) | Width |
|:---|:---|:---|
| End with the 2 × 2 hole pattern | 0 to 55.3 mm | Identical to the chassis plate |
| Transition, 30.3° to the cross direction | 55.3 to 85.5 mm | Increases from 100 to 200 mm |
| Wide section | 85.5 to 205.0 mm | 199.98 mm |
| Transition, 38.4° to the cross direction | 205.0 to 246.5 mm | Decreases from 200 to 100 mm |
| Opposite end | 246.5 to 325.6 mm | Identical to the chassis plate |

* The values are taken from the STL file.
* The wide section is 10 mm wider than the width over the tires (190 mm, `spec_cartent410r.yaml`) and the body width (190 mm, `spec_body.yaml`). It protrudes by 5 mm per side. The speedrun chassis plate with the longer motor window is verified (see [longer motor window for a 3660 motor](#longer-motor-window-for-a-3660-motor)).
* The thickness of 2.0 mm is the same as for the chassis plate. The chassis plate of the car measures 2.03 mm (see [open points](#open-points)).
* The hole pattern and both narrow ends are identical to the chassis plate and are therefore confirmed by its [test print](#measurement-basis-and-test-print). The widened section is not part of the test print.

### Print template
Both speedrun chassis plates have a 1:1 template on two A4 pages in landscape format. The templates are used to check the hole positions against the actual part.

| File | Directory | Window (solid line) | Green dashed line |
|:---|:---|:---|:---|
| `chassis_plate_T410R_speedrun_wide_1to1_A4x2_print97.pdf` | `/chassis/chassis_plate_speedrun_wide` | Window 23.47 × 53.27 mm | Longer motor window (see [longer motor window for a 3660 motor](#longer-motor-window-for-a-3660-motor)) |
| `chassis_plate_T410R_speedrun_wide_motor10_1to1_A4x2_print97.pdf` | `/chassis/chassis_plate_speedrun_wide_motor10` | Longer motor window 23.47 × 63.27 mm | End of the previous window |

* **Scale:** The drawing is pre-scaled to 103.09 % (100/97) for a PDF viewer that prints at 97 %. Printed at 97 %, the drawing is 1:1. Printed at 100 % ("actual size"), it is 3.1 % too large. This differs from the templates of the chassis plate, which are printed at 100 %.
* **Scale check:** Each page has a 100 mm bar in x and a 100 mm bar in y. Both bars must measure 100 mm before the template is used. After joining the pages, the distance between the centres of the holes H11 and H23 is 145.82 mm.
* **Joining:** Page 2 is laid over page 1 so that the two blue dashed lines of the 20 mm overlap zone coincide. The holes H16 to H20 are shown on both pages.
* **Orientation:** The template shows the top view (side without countersinks). The part is placed with the countersinks facing down.
* **Content:** Outline, window and slot (black), through holes Ø3.2 mm with centre cross (red), countersinks Ø6.2 mm on the bottom face (dashed), outline of the chassis plate (grey, dashed) and the other motor window (green, dashed, see table).
* The positions on both PDF files were checked on raster images with 600 dpi. All 36 holes deviate by less than 0.06 mm from the geometry data. The window ends of the template with the longer motor window deviate by less than 0.05 mm.
* The templates are generated with `scripts/cad/generate_print_template.py` (option `--plate wide` or `--plate motor10`). For a PDF viewer with another print scale, the option `--print-scale` generates a matching template (see [scripts](#scripts)).

### Longer motor window for a 3660 motor
* **Author:** [@kleinnconrad](https://github.com/kleinnconrad)
* **Description:** Variant of the speedrun chassis plate (wide) with a motor window that is 10 mm longer. The window is lengthened to fit a 3660 motor. The motor of the car (Hobbywing 3660SL G2) has a diameter of 36 mm and a length of 60 mm (`specs/electronics/brushless_combo/spec_brushless_combo.yaml`) and is 10 mm longer than a 3650 motor.
* **Status:** $\color{green}\checkmark$ Verified. The hole pattern is also confirmed by the [test print](#measurement-basis-and-test-print) of the chassis plate.

Top view of the wide chassis plate with the longer motor window and hole labels

| Property | Speedrun chassis plate (wide) | Longer motor window |
|:---|:---|:---|
| Motor window (width × length) | 23.47 × 53.27 mm | 23.47 × 63.27 mm |
| Position of the window (x) | 16.59 to 40.06 mm | Identical |
| Position of the window (y) | 65.63 to 118.90 mm | 65.63 to 128.90 mm |
| Corner radius of the window | 3.0 mm | Identical |
| Volume | 80.7 cm³ | 80.2 cm³ |

* The window is extended only toward the end with the holes H34 to H36 (+y). The end edge at y = 65.63 mm is not moved.
* The outline, the slot, the 36 holes with the countersinks and the thickness are identical to the speedrun chassis plate (wide).
* The extension reduces the distance between the window and the countersink of hole H16 (Ø6.2 mm, bottom face) from 30.0 mm to 23.3 mm. The distances to the countersinks of the holes H07, H09, H10 and H13, which are closer to the window than H16, do not change.
* The [print template](#print-template) of the speedrun chassis plate (wide) shows the longer window as a green dashed line. The print template of this variant shows the longer window as a solid line and the end of the previous window as a green dashed line.

| File | Format | Use |
|:---|:---|:---|
| `chassis_plate_T410R_speedrun_wide_motor10.step` | STEP (AP214) | Solid model for CAD programs (one solid) |
| `chassis_plate_T410R_speedrun_wide_motor10.stl` | STL (binary) | Complete part as triangle mesh |
| `chassis_plate_T410R_speedrun_wide_motor10.dxf` | DXF | 2D drawing for CNC manufacturing with the same layers as `chassis_plate_T410R.dxf` |
| `chassis_plate_speedrun_wide_motor10_geometry.json` | JSON | Geometry data: outline, cutouts, holes, thickness and countersink parameters |
| `chassis_plate_T410R_speedrun_wide_motor10_1to1_A4x2_print97.pdf` | PDF (A4, 2 pages) | 1:1 template for a PDF viewer that prints at 97 % (see [print template](#print-template)) |

* All files are stored in the directory `/chassis/chassis_plate_speedrun_wide_motor10`. The preview image above (`photos/cad_chassis_speedrun_wide_motor10_preview.png`) shows the previous window as a red dashed line. The STEP, STL and DXF files are generated from the geometry data. All files and the preview image can be regenerated with scripts (see [scripts](#scripts)).
* The geometry data is the geometry data of the speedrun chassis plate (wide) (`chassis_plate_speedrun_wide_geometry.json`) with the longer window. That file combines the outline of `chassis_plate_T410R_speedrun_wide.step` with the holes, cutouts and countersink parameters of `chassis_plate_geometry.json` and reproduces `chassis_plate_T410R_speedrun_wide.step` exactly.

## Speedrun top brace
* **Author:** [@kleinnconrad](https://github.com/kleinnconrad)
* **Description:** New design of the top brace for the bulkheads of this project, in the same style as the bulkheads: straight lines and radii only. The original top brace (see [chassis plate and top brace](#chassis-plate-and-top-brace)) is kept unchanged.
* **Status:** $\color{green}\checkmark$ Verified. The holes are taken from the original top brace, which is confirmed by its test print. The fit to the new bulkheads is also checked in the CAD model (see [fit to the bulkheads](#design-and-fit-of-the-speedrun-top-brace)). After the verification, the obsolete window at the end with B01 to B04 was closed. The holes, the outline and the fit to the bulkheads are not changed by this.

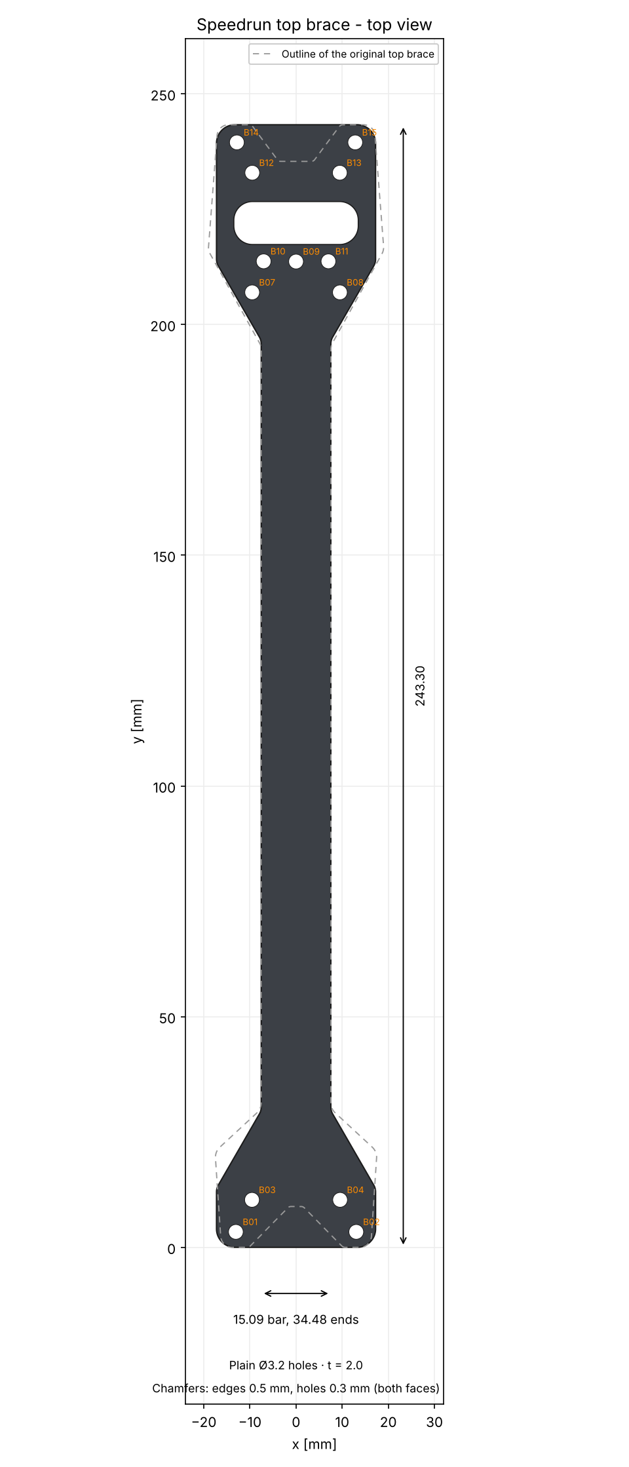
[picture p5: photos/cad_top_brace_speedrun_drawing.png]
Top view of the speedrun top brace with the outline of the original top brace


The assembly with the chassis plate and the bulkheads is shown in the section [speedrun chassis](#speedrun-chassis).

### Design and fit of the speedrun top brace
| Feature | Original top brace | Speedrun top brace |
|:---|:---|:---|
| Holes | 15 holes Ø3.2 mm (B01 to B15) | 13 holes, positions unchanged. B05 and B06 in the middle part are closed. |
| Ends | 32.7 to 38.0 mm wide, with a notch in the middle of each end | 34.48 mm wide (same as the bulkheads, flush with their sides), flat end edges, corner radius 4 mm |
| Middle part | Bar 15.09 mm wide with a short slot (3.2 x 17.5 mm) and a long slot (3.2 x 88.2 mm) | Solid bar 15.09 mm wide |
| Transitions | Approx. 42 degrees (end with B01 to B04) and 29 degrees (end with B07 to B15) to the y axis | 30 degrees on both ends, fillets 3 mm |
| Cutout at the end with B01 to B04 | Hexagon | None: the cutout is obsolete and closed |
| Cutout at the end with B07 to B15 | Obround 27.0 x 9.3 mm | Unchanged |
| Edges | Sharp edges | Edge chamfers 0.5 mm on both faces (outline and obround), chamfers 0.3 mm on the holes, as the bulkheads and the shock towers |
| Size | 38.0 x 243.3 x 2.0 mm | 34.48 x 243.3 x 2.0 mm |
| Volume | 7.84 cm³ | 8.78 cm³ |
| Mass | 12.5 g in carbon (1.6 g/cm³) | 14.0 g in carbon, 24.7 g in 7075 (2.81 g/cm³) |

* The notches at the ends of the original top brace most likely clear the raised rib on top of the stock upper bulkhead. The upper bulkhead of this project has a flat contact face there. The speedrun top brace therefore fits only the bulkheads of this project. With the stock bulkheads, the original top brace is used.
* The new outline lies within the outline of the original top brace, except at the ends: the closed notches and the wider ends (222 mm² in total) lie on the contact faces of the bulkheads. Outside the contact faces, the new outline does not exceed the original outline (0 mm², checked by the script).
* The obround is kept unchanged, because it lies in the area of the spur gear.
* The closed holes and slots make the middle part stiffer. The manual (step 25) shows a part NHA410 with a screw M3x6 in the middle part of the top brace. It has no mounting hole on the speedrun top brace.

**Fit to the bulkheads**

The script `generate_top_brace_speedrun.py` places the top brace on the upper bulkheads at both ends of the chassis plate (centres of H03 to H06 and H28 to H31) and checks the fit:

| Check | Result |
|:---|:---|
| Top brace screws B01, B02, B14, B15 to the tapped holes of the upper bulkheads, along the car | 0.00 mm, after the correction of the upper bulkhead (see below) |
| Top brace screws across | B01/B02: +-0.25 mm, B14/B15: +-0.03 mm (see [open points](#files-and-open-points-of-the-speedrun-top-brace)) |
| Access holes B03/B04 and B12/B13 above the screws M3x10 of the bulkheads | Offset 0.5 mm or less, the hex key reaches the screws |
| Ends of the top brace on the contact faces of the upper bulkheads | 15.2 mm (end with B01 to B04) and 15.7 mm (end with B07 to B15) over the full width, 0.5 mm clearance to the step of the gear block |
| Interference with both upper bulkheads | 0 mm³ |

* Correction of the upper bulkhead: the distance of the top brace screws B01 and B14 (236.13 mm) and the distance of the bulkhead centres on the chassis plate (265.83 mm) require the top brace screws 14.85 mm from the bulkhead centre. The upper bulkhead had 14.36 mm (estimate from photos). The upper bulkhead now has 14.85 mm. Both the top brace and the chassis plate are confirmed by their test print.
* The end with B07 to B15 (obround) is placed at End B of the chassis plate (motor window, spur gear), the end with B01 to B04 at End A.

### Files and open points of the speedrun top brace
All files are stored in the directory `/chassis/top_brace_speedrun`. They are generated with the script `generate_top_brace_speedrun.py` (see [scripts](#scripts)).

| File | Format | Use |
|:---|:---|:---|
| `top_brace_T410R_speedrun.step` | STEP (AP214) | Solid model with the edge chamfers and the hole chamfers (one solid) |
| `top_brace_T410R_speedrun.stl` | STL (binary) | Triangle mesh of the solid model |
| `top_brace_T410R_speedrun.dxf` | DXF | 2D drawing for CNC manufacturing with the layers `OUTLINE`, `CUTOUT` and `HOLE_THROUGH` (without the chamfers; edge chamfers 0.5 mm and hole chamfers 0.3 mm on both faces are given in the order or taken from the STEP file) |
| `top_brace_T410R_speedrun_1to1_A4.pdf` | PDF (A4, 1 page) | 1:1 template, print at 100 % |
| `top_brace_T410R_speedrun_1to1_A4_print97.pdf` | PDF (A4, 1 page) | 1:1 template pre-scaled to 103.09 %, print at 97 % |
| `testprint_top_brace_speedrun_halfA.stl`, `testprint_top_brace_speedrun_halfB.stl` | STL (binary) | Test print in two halves (34.5 x 126.7 mm and 34.5 x 121.7 mm), split at y = 121.65 mm with one dovetail, 0.1 mm gap per side |
| `top_brace_speedrun_geometry.json` | JSON | Geometry data: outline, cutouts, holes, thickness |
| `top_brace_speedrun_hole_table.csv` | CSV | Hole coordinates (x, y) and diameter |

* The coordinate system is the same as for the original top brace: x = 0 centre line, y = 0 end edge with B01 to B04.
* The design values (bar width, corner radii, angle of the transitions, chamfers) are defined at the top of the script.

**Open points of the speedrun top brace**

* **Spacing B01 to B02:** 26.10 mm in the geometry data of the original top brace, 25.65 mm between B14 and B15 and 25.6 mm between the top brace screws of the stock upper bulkhead (U7). Both bulkheads are the same part, so both ends of the top brace should have the same spacing. With a hole of 3.2 mm, a screw M3 has approx. 0.1 mm radial clearance, so an offset of 0.25 mm per side can block the screws. The verification of the speedrun top brace shows that the screws fit. A measurement of the spacing B01 to B02 on the carbon top brace can still confirm the value of the geometry data.
* Function of the part NHA410 (manual step 25) in the middle part of the original top brace.

## Lower bulkhead
* **Author:** [@kleinnconrad](https://github.com/kleinnconrad)
* **Description:** CAD model of the lower half of the gear box (bulkhead) of the Carten T410R. The stock part is the plastic part NBA249 ("Gear box"), which is used at the front and at the rear. The model is the basis for a CNC part made of 7075-T6. The interfaces to the chassis plate, the bearings, the gears, the upper bulkhead and the sway bar follow the stock part. The shape is designed to match the [upper bulkhead](#upper-bulkhead-new-design) (see [design of the lower bulkhead](#design-of-the-lower-bulkhead)).
* **Status:** $\color{green}\checkmark$ Verified (test prints: see [test print of the lower bulkhead](#measurement-basis-and-test-print-of-the-lower-bulkhead)). The interfaces are based on caliper measurements of the stock part. Some positions are taken from photos (accuracy approx. +-0.5 mm) or derived from the caliper values (see [measurement basis of the lower bulkhead](#measurement-basis-and-test-print-of-the-lower-bulkhead)).

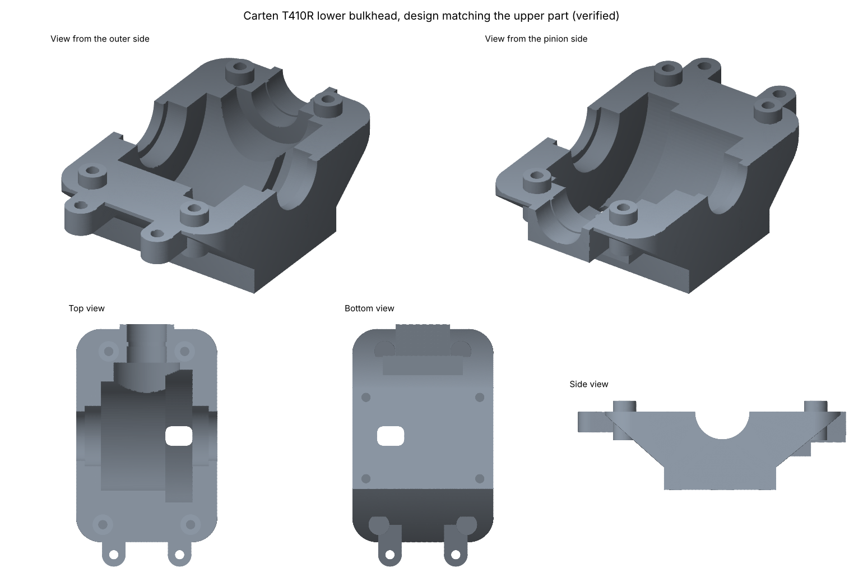
[picture p6: photos/cad_bulkhead_lower_preview.png]
Views of the lower bulkhead


### Interfaces and files of the lower bulkhead
| Interface | Stock parts | Model |
|:---|:---|:---|
| Chassis plate | 4 countersunk screws M3x8 from below through the 2 mm chassis plate | 4 M3 holes (tap drill 2.5 mm, 8 mm deep), spacing 28.0 x 20.0 mm |
| Upper bulkhead | 2 button head screws M3x10 on the pinion side, 2 button head screws M3x8 on the outer side | 4 bosses 4.86 mm, 2.42 mm above the parting face, M3 holes (tap drill 2.5 mm, 7 mm deep). Spacing across 18.7 mm (pinion side) and 21.6 mm (outer side), spacing along 42.6 mm |
| Diff | 2 bearings 10x15x4 (NBA299) | Per side: outer lip 1.89 mm thick (opening 12.28 mm) and seat 15 x 4 mm, open toward the gear cavity. Inner faces of the lips 30.7 mm apart |
| Pinion shaft | 2 bearings 5x10x4 (NBA298) | Seat 10 mm, 9.25 mm long: 2 seats of 4 mm (outer seat 4.35 mm) with a rib of 0.9 mm between the bearings, 0.3 mm high (opening 9.4 mm). The rib is the only axial stop: no shoulder at the inner end, open at the housing end face |
| Ring gear (42T, 31.93 mm) and diff case | Gear diff NBA230 | Cavity with a radius of 13.5 mm for the diff case (test print), deepening with a radius of 16.4 mm for the ring gear on the ring gear side, with a through opening in the floor (test print) |
| Pinion gear (17T, 14.1 mm) | Pinion NBA207 | Pocket with a radius of 8.25 mm (test print) in a rectangular block, wall 1.5 mm |
| Sway bar | 2 M3 screws | 2 tabs, 4.35 mm thick, with M3 holes (tap drill 2.5 mm), spacing 16.2 mm |

* The diff axis and the pinion axis lie in the parting face, 17.2 mm above the bottom face. The upper bulkhead holds the bearings from above.
* The ring gear and the pinion have a module of 0.75 (calculated from the outer diameters 31.93 mm and 14.1 mm). The pitch circle of the pinion is 15.75 mm from the diff axis.
* The chassis plate holes are H03 to H06 for the rear bulkhead (End B) and H28 to H31 for the front bulkhead (End A). The bulkhead is rotated by 180 degrees between the ends, so that the pinion points to the centre shaft at both ends.
* The source of the screw sizes is the manual (steps 9, 11 and 12) and the owner of the car. The source of the bearing sizes is the manual (steps 1 and 5).

**Files of the lower bulkhead**

All files are stored in the directory `/bulkhead`. The STEP and STL files and the measurement sheet are generated from the parameter file (see [scripts](#scripts)).

| File | Format | Use |
|:---|:---|:---|
| `bulkhead_lower_T410R.step` | STEP (AP214) | Solid model with nominal dimensions for CNC manufacturing (one solid) |
| `bulkhead_lower_T410R.stl` | STL (binary) | Triangle mesh of the solid model |
| `testprint_bulkhead_lower.stl` | STL (binary) | Test print variant (see [test print of the lower bulkhead](#measurement-basis-and-test-print-of-the-lower-bulkhead)) |
| `bulkhead_lower_parameters.json` | JSON | All dimensions of the model, each with its source and a note |
| `bulkhead_lower_measurement_sheet.pdf` | PDF (A4, 4 pages) | Caliper measurement sheet with the caliper values and the open values (see [caliper measurement sheet](#measurement-basis-and-test-print-of-the-lower-bulkhead)) |

| Property | Value |
|:---|:---|
| Size (x by y by z) | 34.48 x 59.4 x 19.62 mm (with the sway bar tabs and the pinion housing) |
| Volume | 12.2 cm³ |
| Mass | 34 g in 7075 (2.81 g/cm³), 15 g in PLA (1.24 g/cm³) |

**Coordinate system of the lower bulkhead**

* Units are millimeters.
* The origin is the centre of the 4 bottom holes on the bottom face.
* x runs along the diff axis (across the car). y runs along the pinion axis, +y points to the pinion and the centre shaft. z = 0 is the bottom face, which sits on the chassis plate, +z points up.
* The diff axis is at y = 0.5 mm (photo).
* In the coordinate system of the chassis plate, the origin of the rear bulkhead is at x = 0, y = 21.53 mm (centre of H03 to H06) and the origin of the front bulkhead at x = 0, y = 287.36 mm (centre of H28 to H31).

### Measurement basis and test print of the lower bulkhead
Each parameter in `bulkhead_lower_parameters.json` has a source code:

| Source code | Meaning | Parameters |
|:---|:---|:---|
| `caliper` | Caliper measurement of the stock part (number of the measurement sheet in the note) | Hole spacings, heights, widths, lips, seat lengths, boss and tab sizes |
| `derived` | Calculated from caliper values and part sizes | Positions along y, deepening, floor thickness, pocket radii |
| `manual` | T410R instruction manual (not stored in this repository, see [sources](#sources)) | Bearing sizes |
| `user` | Information from the owner of the car | Screw sizes, function of the sway bar holes, deepening for the ring gear, diff bearing seat limited only by the outer lip |
| `photo` | Estimate from photos with rulers at the height of the part | Position of the diff axis, length of the contact block, ring gear position and side |
| `design` | Free design choice | Tap drill diameters, hole depths, openings that were not measured |

* The caliper values 7, 8 and 9 (top boss holes) agree with the top view photo within 0.3 mm. The ratio of the bottom hole spacings (28.0 / 20.0) agrees with the bottom view photo within 0.3 %.
* The stock part measures 15.6 mm (diff) and 10.5 mm (pinion) across the half bores at the parting face. The model uses the bearing diameters 15.0 mm and 10.0 mm for the bearing fit.
* The positions along y are calculated from the caliper values 16, 17 and 19 with the seat edge (15.6 mm) as the reference. With this reference, the inner pinion bearing is 18.15 mm from the diff axis. The photo with the diff installed shows approx. 18.3 mm.
* The photo with the diff installed shows the ring gear between 5.0 and 9.4 mm from the diff centre. The back face of the ring gear is approx. 1.9 mm from the inner face of the bearing.
* The lip thickness is 1.89 mm (no. 13, measured twice as no. 15). With the inner faces of the lips 30.7 mm apart (no. 14), the width over the outer faces is 34.48 mm. The caliper value no. 10 is 34.2 mm. The model keeps no. 13 and no. 14, because they set the position of the bearings.

**Caliper measurement sheet**

The measurement sheet `bulkhead_lower_measurement_sheet.pdf` documents the caliper values and lists the open dimensions:
* **Pages 1 to 3:** top view, bottom view, two sections, side view and end view with numbered dimensions.
* **Page 4:** table of 41 dimensions with the measuring method, the value of the model and the caliper value. Rows without a caliper value are open.
* **Priority A:** interfaces (holes, bearing seats, bosses, tabs, clearance for the gears). **Priority B:** shape.
* Hole spacings are measured with the inside jaws from far edge to far edge minus the hole diameter. Heights are measured with the depth rod with the part on a flat surface.
* The new values 38 to 41 cover the rib between the pinion bearings, the position of the diff axis relative to the bottom holes (39 and 40) and the height of the sway bar tabs.
* No. 15 now describes the length of the diff bearing seat (4.0 mm from the lip inward). The seat has no inner shoulder.

**Test print of the lower bulkhead**

* `testprint_bulkhead_lower.stl` differs from the solid model in two points: the bearing seats are 0.2 mm larger in diameter (15.2 mm and 10.2 mm), and all M3 holes have a diameter of 2.7 mm for self-tapping screws. The test print file contains the radii and edge chamfers of the solid model.
* Print orientation: bottom face on the print bed. The boss columns below the chamfers and the sway bar tabs need supports.
* The floor below the ring gear deepening has an opening of 6.85 x 5 mm. Around the opening, the floor is 0.8 mm thick and increases toward the ends of the deepening.
* Checks: the 4 bottom holes on the chassis plate, the diff and the pinion shaft with their bearings in the seats, the mesh of the gears, the fit of the stock upper bulkhead and the clearance to the suspension arms and pivot blocks.

Result of the first test print (diff with ring gear and pinion shaft installed):

| Observation | Change |
|:---|:---|
| The diff case touches the wall of the cavity on the outer side (opposite the pinion). | Radius of the diff case cavity 12.5 mm -> 13.5 mm, in the lower and the upper part. |
| The ring gear does not rotate freely in its deepening. The stock part has an extra deepening of approx. 5 mm length with approx. 0.7 mm more space below the ring gear. | Through opening in the floor below the deepening, 6.85 x 5 mm (x by y, centred below the diff axis), corner radius 1.5 mm. The chassis plate closes it. The lowest tooth of the ring gear is 1.23 mm above the chassis plate (before: 0.43 mm above the floor). The radius of the deepening (16.4 mm) is not increased: a larger radius would break through the side faces of the narrow lower section. |
| The pinion needs more space to rotate. | Radius of the pinion pocket 7.75 mm -> 8.25 mm (clearance to the 14.1 mm pinion 1.2 mm), in the lower and the upper part. Below the pocket of the lower part, the wall is 1.5 mm (before: 0.35 mm at the pinion seat). |

Result of the second test print:

| Observation | Change |
|:---|:---|
| The rib between the two pinion bearings is too high and too thick. The stock part has a rib of only a fraction of a millimetre, just enough to keep the bearings apart. | Rib height 0.75 mm -> 0.3 mm (opening 8.5 mm -> 9.4 mm), rib width 1.25 mm -> 0.9 mm, in the lower and the upper part. The face toward the pinion is not moved, so the gear mesh does not change. |
| The part is functional. The shape is to match the upper part. | New shape of the lower part (see [design of the lower bulkhead](#design-of-the-lower-bulkhead)). The interfaces are not changed. |

### Design of the lower bulkhead
The lower part has the same design as the upper part: the footprint of the upper part (34.48 mm wide, corner radius 6 mm, outer end at y = -25.5 mm), with flat faces, radii and edge chamfers (see [edges of the outer shape](#design-of-the-lower-bulkhead)). The two parts end flush at the outer end and on the sides.

| Section | Shape | Function |
|:---|:---|:---|
| -12.4 to 12.4 mm (y) | Rectangular block, flat underside, vertical end faces 5.0 mm high | Contact face on the chassis plate with the 4 bottom holes |
| Outer side and pinion side | One straight chamfer per side, from the end faces of the block (5.0 mm) to 0.5 mm below the parting face at the ends | Space below the chamfers for the pivot blocks of the wishbones |
| Below the pinion pocket and the pinion seats | Stepped rectangular block: 19.5 mm wide below the pocket (to 1.5 mm beyond the end of the pocket), 13.2 mm wide below the seats and beyond the end of the footprint | Wall around the pinion pocket and the pinion seats |
| Below the screws to the upper part | 4 round bosses 4.86 mm, from 11.1 mm above the bottom face | Threads M3 for the screws M3x8 and M3x10 |
| Outer end | 2 tabs 4.35 mm thick with M3 holes, beyond the end of the footprint | Sway bar mounts |

* Space for the pivot blocks: the chamfers lie above the side profile of the previous shape (at the pivot block holes H07/H08, 13.6 mm instead of 11.2 mm above the bottom face). A comparison of the solids gives the material of the new shape outside the previous shape:
  * below the pinion: 82 mm³ in the corners beside the previous round shell (|x| up to 9.75 mm). The lowest point is unchanged at 7.45 mm above the bottom face.
  * corners of the footprint on the pinion side: 13 mm³ (corner radius 6 mm instead of 7 mm), more than 11 mm above the bottom face.
  * outer side: 2 mm³.
* The clearance to the pivot blocks is confirmed by the verification of the lower bulkhead.
* The interfaces (holes, bearing seats, cavities, floor opening, bosses, tabs) are not changed by the new shape.
* Correction after the first model of the new shape: the wide block below the pinion pocket ended at the end of the pocket. Below the pinion seat, the narrow block and the chamfer start only 10.15 mm above the bottom face, the pocket reaches down to 8.95 mm. The end face of the pocket therefore had a window of approx. 8.6 x 1.2 mm to the outside. The wide block now ends 1.5 mm behind the pocket.

**Design notes**

* The body is solid apart from the gear cavity. Pockets to reduce the mass are possible after the test print.
* Each diff bearing seat is limited only by the outer lip. The half bore of 15 mm runs 4.0 mm inward from the lip and then opens into the gear cavity. On the inner side, the diff holds the bearings. The diff with both bearings measures 30.0 mm, the lips are 30.7 mm apart: the diff has 0.7 mm axial play, as on the stock part.
* The gear cavity has two depths. Between the bearing seats, a cylinder with a radius of 13.5 mm holds the diff case (floor 3.7 mm thick). The test print with a radius of 12.5 mm showed that the diff case touches the wall on the outer side. On the ring gear side, a deepening with a radius of 16.4 mm from x = 4.5 mm to the inner end of the bearing seat (x = 11.35 mm) holds the ring gear (radial clearance 0.43 mm). Below the ring gear, the floor has a through opening of 6.85 x 5 mm (extra deepening of the stock part, approx. 5 mm long). The chassis plate closes the gear box from below. The wall between the deepening and the bottom holes is 1.4 mm thick.
* The ring gear is on the +x side. Seen from the pinion housing, the deepening is on the left. The bulkhead is the same part at the front and at the rear and is rotated by 180 degrees. Both pinions point to the centre shaft, so the ring gear is on the same side of the bulkhead at both ends.
* The STEP files contain no threads. All M3 threads are modelled as holes with the tap drill diameter of 2.5 mm (ISO metric thread M3 x 0.5). For CNC manufacturing, the threads are specified in the comment field of the order:

| Part | Holes | Thread | Drill depth | Thread depth | Screws |
|:---|:---|:---|---:|---:|:---|
| Lower bulkhead | 4 holes in the bottom face | M3 | 8.0 mm | 6.5 mm | M3x8 countersunk from below through the chassis plate |
| Lower bulkhead | 4 holes in the bosses below the upper part | M3 | 7.0 mm | 6.0 mm | M3x8 and M3x10 button head through the upper bulkhead |
| Lower bulkhead | 2 holes in the sway bar tabs | M3 | Through (4.35 mm) | Through | Sway bar holders |
| Upper bulkhead | 2 holes for the top brace | M3 | 7.0 mm | 6.0 mm | M3x8 through the top brace |
| Upper bulkhead | 4 holes in the shock tower wall | M3 | Through (6.0 mm) | Through | M3x8 button head through the shock tower |

* All other holes of the speedrun parts are clearance holes Ø3.2 mm without a thread: chassis plate (countersunk from below), top brace, shock towers, and the holes of the upper bulkhead for the screws into the lower bulkhead.
* Stock parts: the motor mount has M3 threads (tap drill 2.5 mm, 7.0 mm deep) for the screws from below through the holes H09 and H10 and for the 2 screws M3x18 of the cap; the flange of the rear pinion shaft has 4 M3 threads for the screws of the spur gear; the pivot blocks have M3 threads for the countersunk screws from below; the wishbones have M3 threads for the ball studs and M4 threads for the droop screws.

**Edges of the outer shape**

Both bulkheads are made for CNC milling from 7075 on a 3-axis machine. The inside of the parts is not changed (rule in `CLAUDE.md`): gear cavity, floor opening, bearing seats, lips, rib, pinion pocket, all holes, counterbores, the recesses and the bosses are the verified geometry of the test prints with the diff and the pinion. The parting faces are not changed either. Only the edges of the outer shape have radii and edge chamfers. The parameters are stored in `bulkhead_lower_parameters.json` (`inside_corner_r`, `outside_corner_r`, `edge_chamfer`, used for both parts) and `bulkhead_upper_parameters.json` (`wall_root_r`). The narrowed shock tower wall with the side steps of the upper part is also a change of the outer shape (see [design of the upper bulkhead](#interfaces-and-design-of-the-upper-bulkhead)).

| Edge treatment | Size | Where | Reason |
|:---|:---|:---|:---|
| Radius in the vertical inside corners | 1.0 mm | Lower part: sway bar bridges, block under the pinion, pinion bosses (10 corners). Upper part: block over the outer pinion bearing (2 corners), ends of the side steps behind the wall (2 corners) | An end mill cannot cut a sharp inside corner parallel to its axis and cannot enter a gap narrower than its diameter (end mill 2 mm) |
| Radius of the vertical outside edges | 1.0 mm | Corners of the levels and blocks seen from above | No extra machining time: the end mill follows the contour |
| Root radius of the shock tower wall | 2.0 mm | Upper part, both sides of the wall, around the corners of the wall | Strength of the wall at its root |
| Edge chamfer | 0.5 mm | The other hard outside edges (angle between the faces up to approx. 120 degrees) | Edge break with a lower cost than a radius |

**Radii in the inside corners:**
* At the pinion bosses of the lower part, the radius also closes the gap between the narrow block and the boss columns. This gap was 0.32 mm wide, so no end mill could enter it.
* The block over the outer pinion bearing projects 1.2 mm beyond the end of the footprint. This limits the radius. Between the radius and the end of the block, a flat of 0.2 mm remains.
* The script closes the horizontal section at the end of each inside edge with the radius (offset by +1.0 mm and back by -1.0 mm) and extends the added faces to the parting face. Above the inclined faces of the lower part, they lie inside the body. At the corners of the footprint, the lower end of the radius follows the inclined face.

**Edge chamfers:**
* Each edge chamfer is cut with a tool along the edge: a triangle with legs of 0.5 mm on both faces. The edges at the parting faces and the bosses are not changed.
* Edges that meet tangentially, for example a straight edge and the arc of a corner radius, are cut together. The edge chamfer runs through the junction without a step.
* Where a face beside the edge becomes narrower than 1.0 mm, the edge chamfer stops 0.1 mm before that point. This occurs where an edge runs into the recess of a vertical corner radius (deck, side steps and flange of the upper part at the corners of the gear blocks), into the corner radius of the shock tower wall (sides of the root radius) or into a narrowing face of the lower part (lower ends of the boss columns, inclined faces at the footprint corners). The end of such an edge chamfer is a small triangular face.
* Where an edge chamfer is not possible at all, the edge is left as it is: a face beside the middle of the edge is narrower than 1.0 mm (for example the end faces of 0.5 mm below the parting face of the lower part), or the cut leaves thin slivers.
* Upper part: 37 edges with full edge chamfers (269 mm), 12 edges with stopped edge chamfers (94 mm), 2 short arcs of 1.2 mm left as they are.
* Lower part: 18 edges with full edge chamfers (178 mm), 18 edges with stopped edge chamfers (154 mm), 12 short edges left as they are (25 mm: edges of the small inside radii and of the narrow block under the pinion).
* The generators list all edges that are left as they are.

**Shock tower wall:** the root radius changes the interface to the shock tower. In front of the contact face, the zone above 19.8 mm is kept free (block 17.8 mm plus the root radius). Beside the narrowed wall, the zones above the side steps are kept free for the camber link lobes of the towers and the rod ends of the camber links. The stock shock tower plate reaches down to approx. 17.8 mm and does not fit. The [speedrun shock towers](#speedrun-shock-towers) are designed for the upper bulkhead.

**Unchanged inside:** the generators build the outer shape with the edge treatment first and then cut all functional voids: gear cavity, floor opening, bearing seats, lip openings, pinion pocket, rib, holes, counterbores, recesses and the keep-out zones of the upper part (top brace, shock tower, rod ends beside the wall). A comparison with the model without edge treatment, which has the verified inside, gives:

| Check | Lower part | Upper part |
|:---|:---|:---|
| Smallest distance of the changed material to the cavities, bearing seats, holes and recesses | 0.60 mm | 0.60 mm |
| Added material in the keep-out zones (top brace, shock tower, rod ends) | – | 0 mm³ |
| Removed material (edge chamfers, outside radii) | 43.3 mm³ | 61.9 mm³ |
| Added material (inside radii, root radius) | 8.3 mm³ in 10 pieces | 49.4 mm³ in 6 pieces |
| Thin slits and walls | None (narrow faces: 6 at the inside radii, 8 at the ends of stopped edge chamfers) | None (narrow faces: 16 at the ends of stopped edge chamfers, 4 at the ends of the root radius beside the narrowed wall) |

* Space for the pivot blocks: each radius lies between two existing faces and does not reach lower than the material beside it. Below the inclined faces on the outer side, the radii lie between the sway bar bridges and the outer bosses, from 12.85 mm above the bottom face (lower face of the bridges) and up to x = 11.6 mm (the bosses reach 13.2 mm). On the pinion side, they lie between the narrow block and the pinion bosses, from 10.6 mm above the bottom face (lower face of the narrow block) and up to x = 8.1 mm (the bosses reach 11.8 mm). The edge chamfers and the outside radii only remove material.
* The interference of the lower and the upper part, and of all parts of the speedrun chassis, is 0 mm³. The top brace fits the upper bulkheads unchanged.

### Open points of the lower bulkhead
* **Chassis plate:** the bottom holes of the stock bulkhead are 28.0 x 20.0 mm apart. The chassis plate and the speedrun chassis plates have 28.17 x 20.22 mm (H03 to H06) and 28.13 x 20.19 mm (H28 to H31). Countersunk screws center themselves in the countersinks, so the difference of approx. 0.1 mm per hole is not compensated by clearance. The hole spacings of the carbon chassis plate are to be measured before the aluminium plate is ordered.
* Open caliper values of the measurement sheet (nos. 21, 26, 30 to 36, 38 to 41).
* The value 22 (5 mm) is interpreted as the height of the end faces of the contact block, and the value 25 (4.35 mm) as the thickness of the sway bar tabs with the top face in the parting face.
* Width over the outer faces of the diff bearing walls: 34.48 mm in the model, 34.2 mm measured (no. 10).
* The outer end face of the stock part has small holes. Their function is unknown, so they are not modelled.
* Upper bulkhead: see [upper bulkhead (new design)](#upper-bulkhead-new-design).
* Front and rear: End A of the chassis plate is assumed to be the front (bumper holes H34 to H36), End B the rear (motor window).
* Pivot block at End B, outer: the model of the long stock pivot block overlaps the outer chamfer of the lower bulkhead by 0.38 mm (see [open points of the pivot blocks](#pivot-blocks)).

## Upper bulkhead (new design)
* **Author:** [@kleinnconrad](https://github.com/kleinnconrad)
* **Description:** CAD model of a new upper half of the gear box (bulkhead) of the Carten T410R for CNC manufacturing from 7075-T6. The shape is a new design. The interfaces follow the stock part: the lower bulkhead, the diff and pinion bearings, the shock tower and the top brace.
* **Status:** $\color{green}\checkmark$ Verified with a test print. The interfaces to the lower part and the bearings are taken from the parameter file of the lower bulkhead. The shock tower hole pattern and its height, the spacing of the top brace screws and the height of the top brace face are caliper values (U1 to U4, U7, U9, U10). The position of the shock tower contact face is an estimate from photos (U5, U6), and the position of the top brace screws along y is derived from the top brace and the chassis plate (U8). The test print confirms the part (see [measurement sheet of the stock upper bulkhead](#files-and-measurement-sheet-of-the-upper-bulkhead)). The root radius of the shock tower wall was added after the test print: the stock shock tower plate does not fit, the [speedrun shock towers](#speedrun-shock-towers) are designed for the upper bulkhead. Also after the test print, the shock tower wall was narrowed to 28.0 mm with side steps beside it (request of the owner): the camber link holes of the towers are at the stock position, and the rod ends of the camber links sit beside the wall. The inside of the part and the 4 tapped holes of the shock tower are not changed.

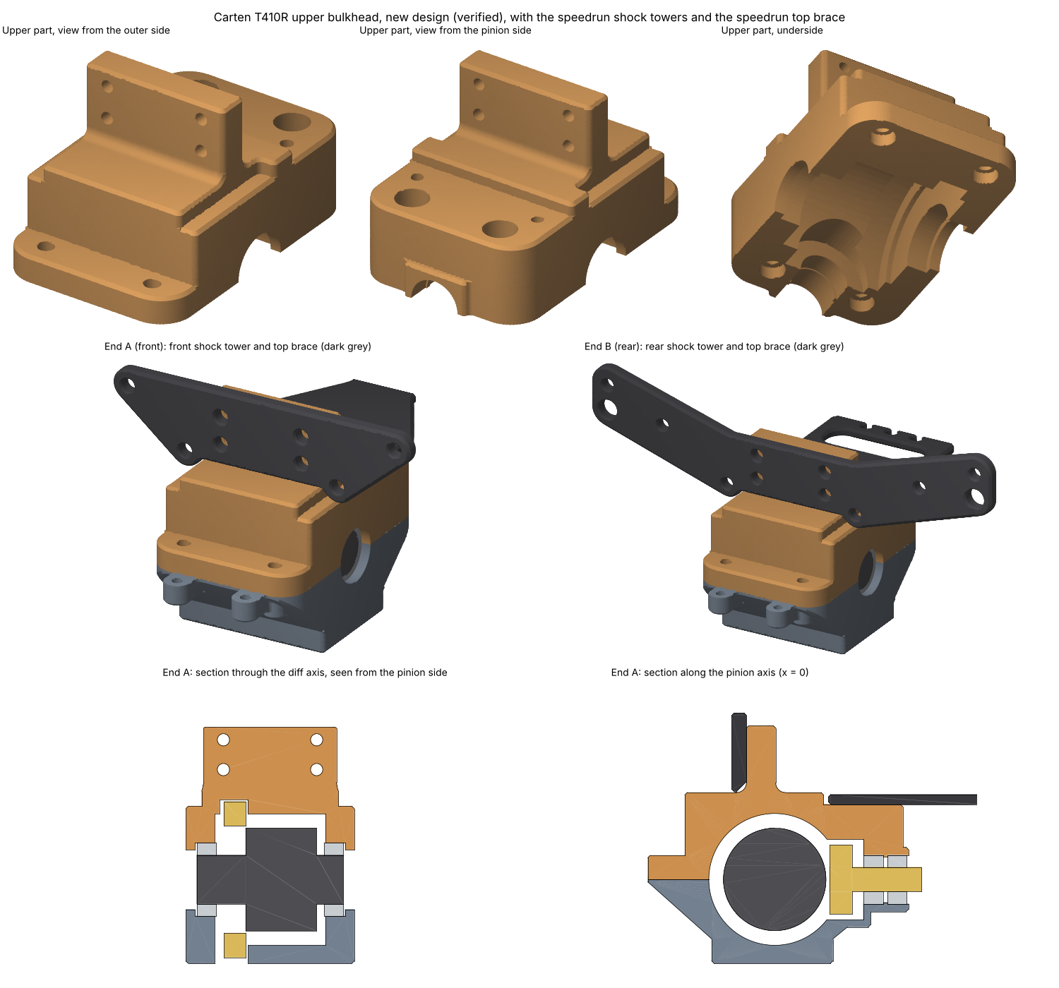
[picture p7: photos/cad_bulkhead_upper_preview.png]
Views and sections of the upper bulkhead


The preview shows the upper part, the assemblies at End A (front) and End B (rear) with the lower part, the [speedrun shock towers](#speedrun-shock-towers) and the end of the [speedrun top brace](#speedrun-top-brace) (dark grey), and two sections of the assembly at End A. The bearings (light grey), the gears (yellow) and the diff case (dark grey) are simplified bodies that show the positions only.

### Interfaces and design of the upper bulkhead
| Interface | Stock parts | Model | Source |
|:---|:---|:---|:---|
| Lower bulkhead | Parting face, 4 bosses of the lower part (4.86 mm, 2.42 mm high) | Flat underside, 4 recesses 5.06 x 2.52 mm for the bosses (locating the two halves) | Lower part |
| Screws to the lower part | 2 button head screws M3x8 on the outer side, 2 button head screws M3x10 on the pinion side | Clearance holes 3.2 mm. Head seats 4.92 mm (outer side, on the flange) and 6.92 mm (pinion side, counterbore 6.5 mm) above the parting face: 5.5 mm thread engagement in the lower part | User, lower part |
| Diff bearings (10x15x4) | Clamped between the two halves | Upper half bores 15 x 4 mm, limited only by the outer lips (opening 12.28 mm, 1.89 mm thick) | Lower part |
| Pinion bearings (5x10x4) | Clamped between the two halves | Upper half bores 10 mm with the rib (0.9 mm wide, 0.3 mm high) between the bearings as the only axial stop, open toward the pinion pocket and at the housing end face | Lower part, user |
| Gears | Ring gear 42T (31.93 mm), pinion 17T (14.1 mm) | Same cavities as the lower part: diff case radius 13.5 mm, ring gear radius 16.4 mm on the ring gear side (from x = 4.5 mm to 10.4 mm, 1 mm beyond the back face of the ring gear), pinion pocket radius 8.25 mm | Lower part, photo |
| Shock tower | 3 mm carbon, 4 button head screws M3x8 (manual steps 19 and 20). Stock holes 2.9 mm, through the 5.8 mm ears | Flat contact face facing the outer side at y = -5.3 mm, 4 tapped holes M3 (through the 6 mm wall) at x = +-9.55 mm and 22.5 / 28.6 mm above the parting face. Root radius 2.0 mm on both sides of the wall. In front of the face, no material above 19.8 mm: the stock plate does not fit, the [speedrun shock towers](#speedrun-shock-towers) fit. Wall 28.0 mm wide (x = +-14.0 mm) with side steps 15.0 mm above the parting face beside it: space for the rod ends of the camber links (x = +-18.05 mm, 19.1 mm) | Caliper (holes), photo (contact face), owner (camber links) |
| Top brace (NHA432) | 2 button head screws M3x8 per bulkhead (manual step 25) into 2 raised bosses | Flat contact face 15.4 mm above the parting face, from y = 10.5 mm to the pinion end, 2 tapped holes M3 at x = +-12.8 mm, y = 14.85 mm | Caliper (height, spacing), top brace and chassis plate (y, see [fit to the bulkheads](#design-and-fit-of-the-speedrun-top-brace)) |
| Sway bar holders | M3x6 from above onto the tabs of the lower part (manual step 23) | The upper part ends at y = -25.5 mm, 3.2 mm before the sway bar holes | Photo |

* The pinion side screws (M3x10) sit below the top brace. The top brace has access holes above them (B03/B04 and B12/B13, spacing 19.1 mm, 6.94 mm and 6.58 mm from the top brace screws).
* The upper part is the same at the front and at the rear, like the lower part. The front and the rear shock tower use the same 4 holes.

**Design of the upper bulkhead**

The upper part is a prismatic block: the footprint of the lower part (34.48 mm wide, corner radius 6 mm) is extruded to 4 flat levels along y. The shock tower wall and the gear block are narrowed to 28.0 mm, with side steps beside them. All outer faces are flat. The edges have radii and edge chamfers, the root of the shock tower wall has a radius of 2.0 mm (see [edges of the outer shape](#design-of-the-lower-bulkhead)). The only other curved faces are the bores and the cavities, which follow the lower part.

| Section (y) | Level above the parting face | Function |
|:---|:---|:---|
| -25.5 to -17.9 mm | 4.92 mm | Flange: seat of the heads of the outer screws |
| -17.9 to -5.3 mm | 17.8 mm | Block over the diff and the ring gear (2 mm in front of the ring gear cavity), 28.0 mm wide |
| -5.3 to 0.7 mm | 31.5 mm | Shock tower wall, 28.0 mm wide (x = +-14.0 mm), 6 mm thick, flat contact face, root radius 2.0 mm on both sides |
| 0.7 to 10.5 mm | 17.8 mm | Block over the diff and the ring gear, 28.0 mm wide up to 5.0 mm |
| 10.5 to 26.7 mm | 15.4 mm | Flat contact face of the top brace over the pinion, counterbores of the pinion side screws |
| 26.7 to 27.9 mm | Rectangular block, 13.2 mm wide, 6.6 mm high | Cover of the outer pinion bearing beyond the footprint (same section as the lower part) |

* Side steps: beside the wall and the gear block (|x| > 14.0 mm), from the front face of the gear block to y = 5.0 mm, the part is 15.0 mm high. This gives space for the rod ends of the camber links behind the shock towers (zone with a radius of 4.0 mm around the ball stud at x = +-18.05 mm, 19.1 mm, 9 mm long; estimate) and for the camber link lobes of the towers (lowest point 15.6 mm). The removed material is 3.05 mm away from the cavities, seats and holes; above the diff bearing seats, 7.5 mm of material remain.
* The tapped holes of the shock tower (x = +-9.55 mm) are 4.45 mm from the side faces of the narrowed wall (centre to face).
* The interference check of the assembly of the lower and the upper part gives 0 mm³.
* The ring gear cavity of the upper part ends at x = 10.4 mm (lower part: 11.35 mm). Up to 11.35 mm, the wall to the tapped hole of the top brace screw was only 0.2 mm. It is now 1.15 mm.
* Size 34.48 x 53.4 x 31.5 mm, volume 18.8 cm³, mass 53 g in 7075 (2.81 g/cm³), 23 g in PLA.
* The wall is 6 mm thick: the screws M3x8 through the 3 mm shock tower have 5 mm thread engagement. The material above the thread of the upper holes is 1.4 mm (wall top at the height of the stock ears, U10).
* The block over the ring gear is 17.8 mm high. In front of the wall, the zone above 19.8 mm (block plus root radius) is kept free for the shock tower. The cover over the ring gear cavity is 1.4 mm directly behind the wall and 2.5 mm at the contact face.
* The mass is higher than with shells that follow the gears. Straight pockets in the flat faces can reduce it, if required.
* Manufacturing: 3 setups on a 3-axis machine (underside with the bores and cavities, top with the levels and the vertical holes, outer side with the 4 shock tower holes). The STEP file contains no threads: the tapped holes are modelled with the tap drill diameter of 2.5 mm. Radii and edge chamfers: see [edges of the outer shape](#design-of-the-lower-bulkhead).

### Files and measurement sheet of the upper bulkhead
All files are stored in the directory `/bulkhead`. The files are generated from the parameter files of the upper and the lower part (see [scripts](#scripts)).

| File | Format | Use |
|:---|:---|:---|
| `bulkhead_upper_T410R.step` | STEP (AP214) | Solid model with nominal dimensions (one solid) |
| `bulkhead_upper_T410R.stl` | STL (binary) | Triangle mesh of the solid model |
| `testprint_bulkhead_upper.stl` | STL (binary) | Test print variant: bearing seats 0.2 mm larger, tapped holes 2.7 mm for self-tapping screws. Print with the parting face on the print bed. |
| `bulkhead_assembly_T410R.step` | STEP (AP214) | Assembly of the lower and the upper part |
| `bulkhead_upper_parameters.json` | JSON | Dimensions of the upper part, each with its source and a note. The shared dimensions are read from `bulkhead_lower_parameters.json`. |
| `bulkhead_upper_measurement_sheet.pdf` | PDF (A4, 2 pages) | Measurement sheet of the stock upper part (see below) |

**Measurement sheet of the stock upper bulkhead**

The measurement sheet `bulkhead_upper_measurement_sheet.pdf` shows the interfaces of the stock upper part on 3 photos (end view, side view, top view) with the numbers U1 to U14. Page 2 lists the values of the model and the caliper values (U1 to U4, U7, U9, U10 measured):
* **U1 to U6, U11, U13:** shock tower: hole pattern, height of the holes, position of the contact face, lowest edge of the shock tower plates.
* **U7 to U9:** top brace: hole spacing, position along y, height of the contact face.
* **U10, U12:** height of the ears, outer end of the stock part.
* **U14:** use of the 2 screws M3x18 with the block NBA201 at the rear end of the top brace (manual step 25).
* A scan of both shock towers on the flatbed scanner (U13) is the most accurate source for the hole pattern.
* The photos are stored as `photos/bulkhead_upper_stock_end_view.jpg`, `photos/bulkhead_upper_stock_side_view.jpg` and `photos/bulkhead_upper_stock_top_view.jpg`.

### Open points of the upper bulkhead
* Caliper values of the stock upper part that are not measured: U5, U6 (position of the shock tower contact face), U8 (position of the top brace screws along y), U11 (lowest edge of the shock towers), U12 to U14. The test print confirms the part, so these values are not required for manufacturing.
* Shock tower: the stock shock tower plate does not fit. The [speedrun shock towers](#speedrun-shock-towers) (front and rear) are designed for the upper bulkhead.
* Mass: 53 g in 7075. Straight pockets in the flat faces can reduce the mass.

## Speedrun shock towers
* **Author:** [@kleinnconrad](https://github.com/kleinnconrad)
* **Description:** New front and rear shock towers for the speedrun upper bulkhead. Flat carbon plates of 3 mm (as the stock shock towers) on the contact face of the shock tower wall, each fixed with 4 button head screws M3x8 in the tapped holes of the wall. The dampers are mounted on the front face (outer end), the rod ends of the camber links on the back face (wall side), as on the car. The rear tower also carries the body post mounts.
* **Status:** $\color{green}\checkmark$ Verified by the owner (front and rear shock tower). The damper, camber link (wheel mount) and body post positions are based on measurements of the stock shock towers by the owner. After the verification, the camber link holes were moved back to the stock position (the owner found them about 3 mm too far outward), and the shock tower wall of the upper bulkhead was narrowed for the rod ends (see [design of the speedrun shock towers](#design-and-fit-of-the-speedrun-shock-towers)). The space for the rod ends is an estimate from photos.

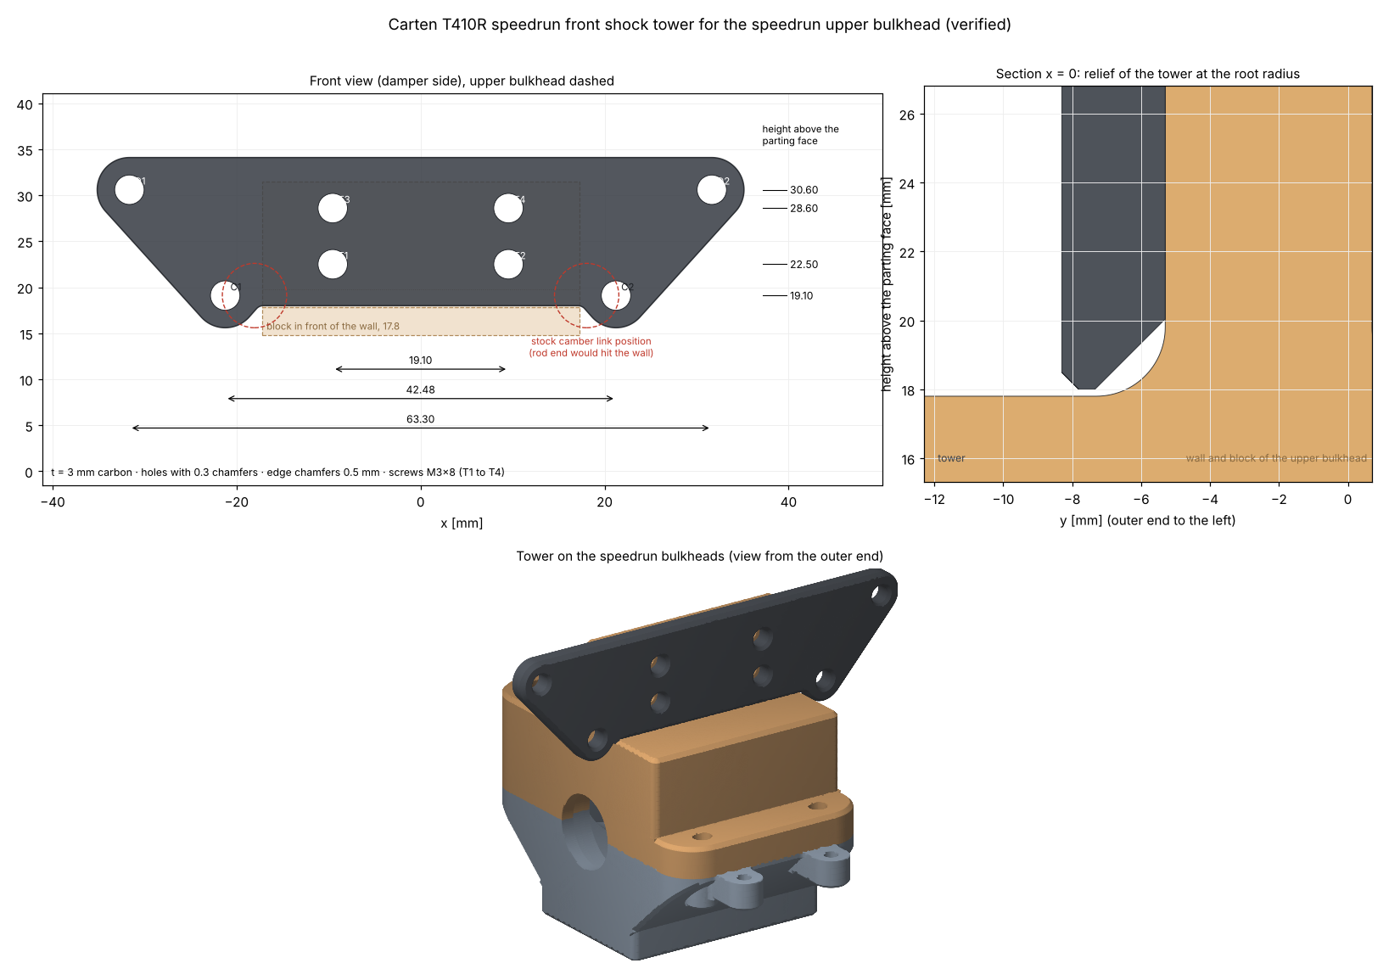
[picture p8: photos/cad_shock_tower_front_drawing.png]
Speedrun front shock tower on the speedrun bulkheads


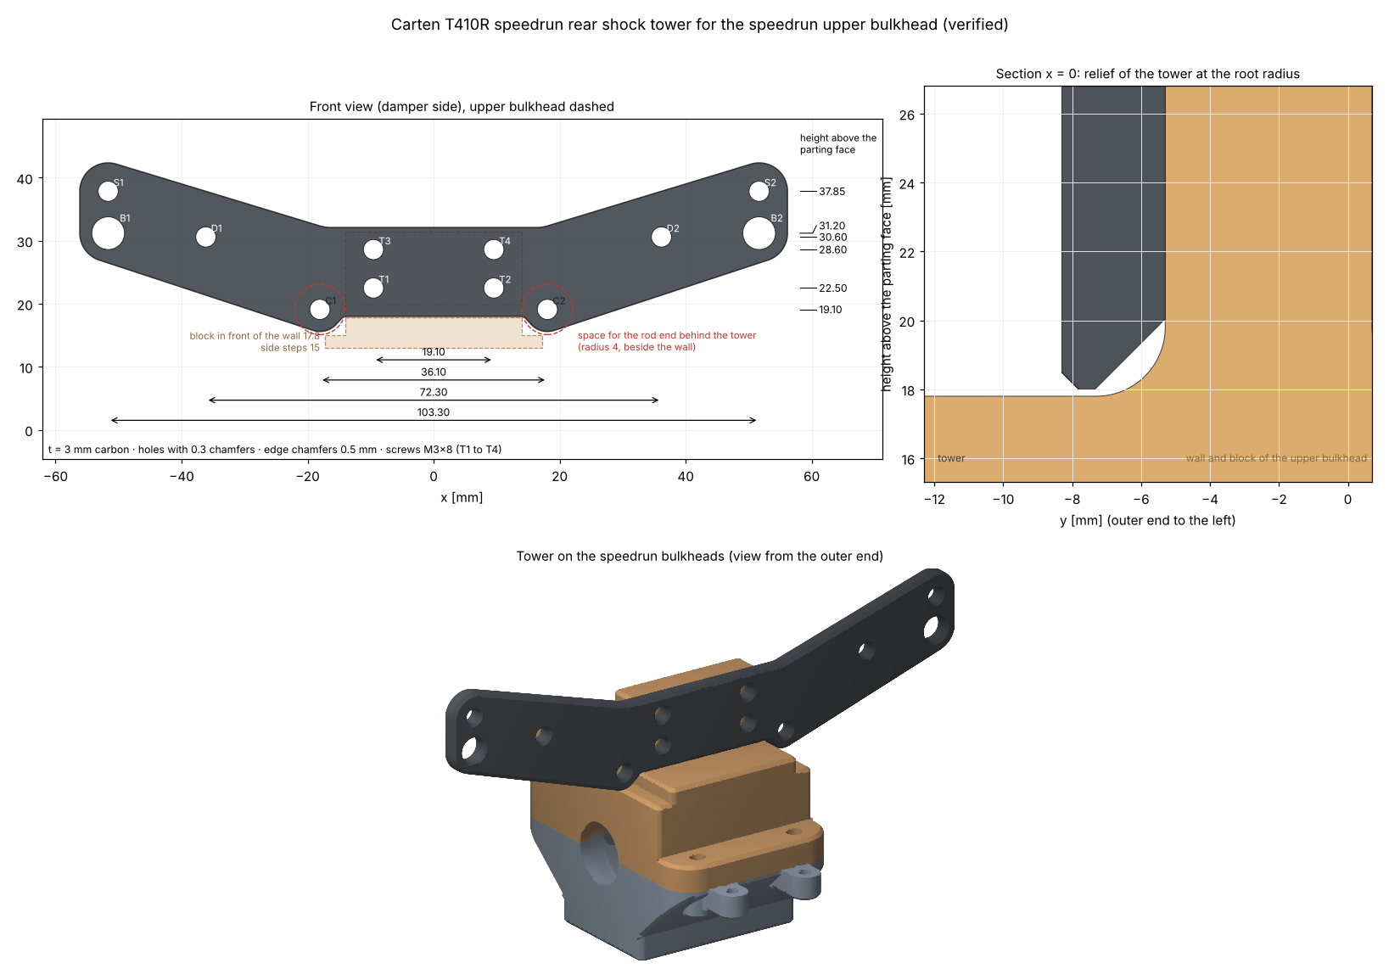
[picture p9: photos/cad_shock_tower_rear_drawing.png]
Speedrun rear shock tower on the speedrun bulkheads


### Design and fit of the speedrun shock towers
Positions in the plane of the tower: x across the car, height above the parting face of the bulkheads. The measurements of the owner refer to the edges of the holes of the stock towers; the model assumes holes of 3.2 mm in the stock towers (parameter `stock_hole_d`).

| Element | Front shock tower | Rear shock tower | Basis |
|:---|:---|:---|:---|
| Mounting holes T1 to T4 | x = ±9.55 mm, 22.5 mm and 28.6 mm, Ø3.2 mm | Same | Tapped holes of the upper bulkhead (U1 to U3) |
| Camber link holes C1, C2 (wheel mounts) | x = ±18.05 mm, 19.1 mm, Ø3.2 mm | Same | Stock towers: 8.5 mm outward and 5 mm down from the top of the lower mounting hole (owner) |
| Damper holes D1, D2 | x = ±31.65 mm, 30.6 mm, Ø3.2 mm | x = ±36.15 mm, 30.6 mm, Ø3.2 mm | Stock towers, from the outer end of the upper mounting hole to the centre of the damper hole: front 20.5 mm outward and 2 mm up, rear 25 mm outward and 2 mm up (owner) |
| Body post bores B1, B2 | – | x = ±51.65 mm, 31.2 mm, Ø5.2 mm | Stock rear tower: bottom of the bore 40.5 mm outward from the outer end of the upper mounting hole (owner) |
| Body post screw bores S1, S2 | – | x = ±51.65 mm, 37.85 mm, Ø3.2 mm | Stock rear tower: bottom of the bore 2.45 mm above the top of the 5.2 mm bore (owner) |
| Thickness | 3.0 mm carbon | 3.0 mm carbon | Owner. The upper bulkhead is designed for it: screws M3x8, 5 mm thread engagement |
| Outline | Straight top edge 34.1 mm high, round ends R3.5 around the damper holes, straight edges down to the camber link lobes | Straight top edge 32.1 mm high over the width of the bulkhead, corners R6, rising straight edges to round ends R4.5 around the body post bores, straight edges down to the camber link lobes; the damper holes lie in the wings | Design |
| Common outline | Round lobes R3.5 around the camber link holes beside the narrowed block, straight bottom edge 0.2 mm above the block in front of the wall, inside corners R1 | Same | Design |
| Size, mass | 70.3 x 18.5 x 3 mm, 4.4 g (carbon), 7.7 g (7075) | 112.3 x 26.8 x 3 mm, 7.6 g (carbon), 13.4 g (7075) | |

* Edges of both towers: chamfer 0.5 mm on both faces (as the edge chamfers of the bulkheads), chamfers of 0.3 mm on the holes. No sharp corners: all outside corners are radii.
* Relief on the back face: along the bottom edge, the edge chamfer increases to 45 degrees with legs of 2.05 mm and runs out to the edge chamfer over 1.5 mm beside the wall. It clears the root radius of the wall (2.0 mm) by 0.18 mm.
* Camber link holes: at the stock position (x = ±18.05 mm). The rod ends sit behind the tower beside the shock tower wall of the upper bulkhead. For this, the wall and the gear block of the upper bulkhead are narrowed to 28.0 mm (x = ±14.0 mm), with side steps 15.0 mm above the parting face beside them (see [design of the upper bulkhead](#interfaces-and-design-of-the-upper-bulkhead)). A zone with a radius of 4.0 mm around the ball stud (rod end with clearance, estimate) is 0.05 mm clear of the side faces of the wall: 18.05 - 4.0 - 0.05 = 14.0 mm.
* The bottom edge lies 0.2 mm above the block in front of the wall (17.8 mm). The camber link lobes reach down to 15.6 mm beside the narrowed block, 0.6 mm above the side steps. The edge distance below the lower mounting holes is 2.9 mm, around the other holes at least 1.9 mm.

**Fit to the upper bulkhead**

Results of the checks of `generate_shock_towers.py` (same for both towers):

| Check | Result |
|:---|:---|
| Mounting holes on the tapped holes of the upper bulkhead | Offset 0.00 mm |
| Interference with the upper and the lower bulkhead | 0 mm³ |
| Contact area on the wall | 247 mm² |
| Gap below the tower (block and root radius) | 0.20 mm |
| Zone of the rod ends behind the tower (radius 4.0 mm, 9 mm long) | Free, 0 mm³ overlap with the bulkheads |
| Edge distance of the holes | Mounting holes 2.9 mm, camber link holes 1.9 mm, damper holes 1.9 mm (front) and 5.3 mm (rear), body post bores 1.9 mm and 2.9 mm |
| Thin slits and walls | None |

* Both towers are part of the assembly of the speedrun chassis: the front tower at End A (assumed front), the rear tower at End B. The interference check gives 0 mm³ for both towers.

### Files and open points of the speedrun shock towers
All files are stored in the directory `/shock_tower`. They are generated with `generate_shock_towers.py` (see [scripts](#scripts)). The file names start with `shock_tower_front` or `shock_tower_rear`.

| File | Format | Use |
|:---|:---|:---|
| `shock_tower_front_T410R_speedrun.step`, `shock_tower_rear_T410R_speedrun.step` | STEP (AP214) | Solid models with the edge chamfers and the relief, for CNC manufacturing. Plate coordinates: x across the car, y height above the parting face, z = 0 back face |
| `shock_tower_front_T410R_speedrun.stl`, `shock_tower_rear_T410R_speedrun.stl` | STL (binary) | Triangle meshes, also for test prints |
| `shock_tower_front_T410R_speedrun.dxf`, `shock_tower_rear_T410R_speedrun.dxf` | DXF | 2D drawings with the layers `OUTLINE` and `HOLE_THROUGH` (outline without the chamfers) |
| `..._1to1_A4.pdf`, `..._1to1_A4_print97.pdf` | PDF (A4) | 1:1 templates of each tower (100 % and 97 %) to compare the holes with the stock towers and the bulkhead |
| `shock_tower_front_geometry.json`, `shock_tower_rear_geometry.json` | JSON | Geometry data: outline and holes (holes with another diameter than 3.2 mm carry their own diameter) |
| `shock_tower_front_parameters.json`, `shock_tower_rear_parameters.json` | JSON | All dimensions, each with its source and a note |
| `shock_tower_front_hole_table.csv`, `shock_tower_rear_hole_table.csv` | CSV | Hole tables with diameter and use |

* CNC order of the carbon plates: outline and holes from the DXF files. The edge chamfers and the relief on the back face are in the STEP files (relief: 45 degrees, 2.05 mm, along the bottom edge on the back face).

**Open points of the speedrun shock towers**

Both shock towers are verified by the owner. The following points are not required for manufacturing. They are relevant for later changes of the design.
* Rod ends of the camber links: size and position behind the towers are not measured (the zone with a radius of 4.0 mm is an estimate). It sets the width of the shock tower wall of the upper bulkhead (parameters `rod_end_clearance_r` of the towers and `wall_half_width` of the upper bulkhead).
* Holes of the stock towers: the conversion of the measurements assumes holes of 3.2 mm.

## Stock parts (not part of the speedrun design)
Models of stock parts of the Carten T410R, modelled for the completeness of the build: the assembly of the speedrun chassis contains them, so that the space around the speedrun parts can be checked. They are not part of the speedrun design and are not manufactured in this project. Status: $\color{green}\checkmark$ verified (test print or on the car), $\color{gold}\blacktriangle$ measures qualified, no 3D print verification, $\color{red}\times$ completely unqualified.

### Pivot blocks
* **Author:** [@kleinnconrad](https://github.com/kleinnconrad)
* **Description:** Models of the stock pivot blocks of the Carten T410R. The pivot blocks hold the hinge pins of the wishbones and are screwed to the chassis plate from below (countersunk screws M3).
* **Status:** $\color{red}\times$ Completely unqualified. Not part of the speedrun design (stock part). The dimensions are measurements of the owner, the distances of the mounting holes are taken from the hole pattern of the speedrun chassis plate, the lengths of the shoulders are estimates from photos.

Pivot blocks: sections and top views

**Dimensions of the pivot blocks**

| Dimension | Long block | Short block | Source |
|:---|:---|:---|:---|
| Quantity and position | 1: End B, outer (H01/H02) | 3: End B, inner (H07/H08), End A, inner (H26/H27), End A, outer (H32/H33) | Owner, chassis plate |
| Total length | 53.4 mm | 50.2 mm | Owner (long block), derived (short block: 41.4 + 2 x 4.4) |
| Distance of the hinge pin bores | 44.6 mm | 41.4 mm | Owner |
| Distance of the mounting holes | 31.82 mm | 29.12 mm | Chassis plate (short block: mean of 3 hole pairs; photo of the underside approx. 29.2 mm) |
| Width | 5.94 mm | 5.94 mm | Owner |
| Height at the lobes, at the shoulders, of the bar | 9.0 / 6.4 / 3.8 mm | Same | Owner |
| Length of the shoulders (from the end of the block) | 15.0 mm | 14.0 mm | Photo |
| Hinge pin bores | 6.0 mm, 4.7 mm deep (blind holes, wall of 1.24 mm at the bottom), open toward the bulkhead, axis 4.6 mm above the bottom face, lobes R4.4 | Same | Owner (depth, side of the opening), derived from the measurements of the owner (diameter, axis, lobes) |
| Mounting holes | 2.5 mm (tap drill M3), through | Same | Assumption |

* The radius of the lobes follows from the long block: (53.4 - 44.6) / 2 = 4.4 mm. The axis of the bores lies at 9.0 - 4.4 = 4.6 mm above the bottom face.
* Not modelled: the inserts in the bores and the small tabs on top of the shoulders.

**Position and fit on the speedrun chassis**

Results of the checks of `generate_pivot_blocks.py`:

| Position | Block | Holes of the chassis plate | Offset of the mounting holes | Lower bulkhead | Upper bulkhead |
|:---|:---|:---|:---|:---|:---|
| End B, outer | Long | H01/H02 | 0.00 mm | Overlap 0.82 mm³ (0.38 mm deep) | 9.18 mm clearance |
| End B, inner | Short | H07/H08 | 0.03 mm | 2.13 mm clearance | 8.67 mm clearance |
| End A, inner | Short | H26/H27 | 0.01 mm | 1.22 mm clearance | 8.67 mm clearance |
| End A, outer | Short | H32/H33 | 0.02 mm | 0.90 mm clearance | 8.67 mm clearance |

* Orientation: the blind bores open toward the bulkhead. The blocks at End B, inner and End A, outer are turned by 180 degrees compared with the other two.
* The long block at End B lies closer to the bulkhead (16.5 mm from the centre of the bulkhead) than the short block at End A, outer (19.1 mm). Its shoulders (6.4 mm) reach 0.38 mm into the outer chamfer of the lower bulkhead, which starts at 6.0 mm above the chassis plate at the side of the block that faces the bulkhead (|x| from 11.7 to 17.0 mm).
* The test prints of the lower bulkhead were made with the previous shape. The outer chamfers came with the new shape after the second test print, so this point is not checked on the car.

**Files of the pivot blocks**

All files are stored in the directory `/stock_parts/pivot_block`. They are generated with `generate_pivot_blocks.py` (see [scripts](#scripts)).

| File | Format | Use |
|:---|:---|:---|
| `pivot_block_long_T410R.step`, `pivot_block_short_T410R.step` | STEP (AP214) | Solid models in block coordinates: x along the block, y along the hinge pins, z = 0 bottom face |
| `pivot_block_long_T410R.stl`, `pivot_block_short_T410R.stl` | STL (binary) | Triangle meshes |
| `pivot_block_parameters.json` | JSON | All dimensions, each with its source and a note |

**Open points of the pivot blocks**

* Overlap at End B, outer: check on the car whether the long pivot block touches the outer chamfer of the lower bulkhead, or measure the height of the shoulders at the side of the block that faces the bulkhead. If they touch, the outer chamfer of the lower bulkhead can be raised at this place (outer shape; the inside of the bulkhead is not changed).
* Mounting holes: depth (through or blind) not measured.

### Centre driveshaft and drive line
* **Author:** [@kleinnconrad](https://github.com/kleinnconrad)
* **Description:** Model of the centre driveshaft of the Carten T410R (NHA413) between the cup joints of the two pinion shafts. The shaft has a ball end at each end with a metal pin (2.0 x 7.6 mm), which is fixed on the shaft. The cup joints are pushed onto the pinion shafts and secured with a retaining pin NBA255 2.0 x 7.6 mm through a cross hole; an O-ring in a groove of the cup joint holds the pin. The pins run in the slots of the cup joints, so the shaft turns with the cup joints. In the centred position, each pin has 0.5 mm to the closed end of its slot, so the shaft can move a little back and forth. At End A, the cup joint sits on the front pinion shaft beside the bulkhead. At End B (motor), the rear pinion shaft NBA205 runs from the pinion in the bulkhead through a flange with the spur gear and the bearing NBA298 in the motor mount NBA201 (manual steps 5, 10 and 12); the cup joint sits on its end beyond the motor mount. All these parts are modelled as CAD files (see [files](#centre-driveshaft-and-drive-line)).
* **Status:** $\color{gold}\blacktriangle$ Measures qualified, no 3D print verification: centre driveshaft, motor mount with cap rear and front drive line (pinion shafts, pinions, spur gear, bearings, retaining pins; some dimensions from photos of the owner). $\color{red}\times$ Completely unqualified: cup joints and diff outdrives. Not part of the speedrun design (stock parts). The cup joints, the thickness of the motor mount and the spur gear (72T 48DP) are given by the owner, the positions of the motor mount and the spur gear are derived from the chassis plate, the outline of the motor mount and its cap follow the manual (steps 10 and 25). The thicknesses of the spur gear and the flange and the gaps are typical values (see [open points of the centre driveshaft](#centre-driveshaft-and-drive-line)).

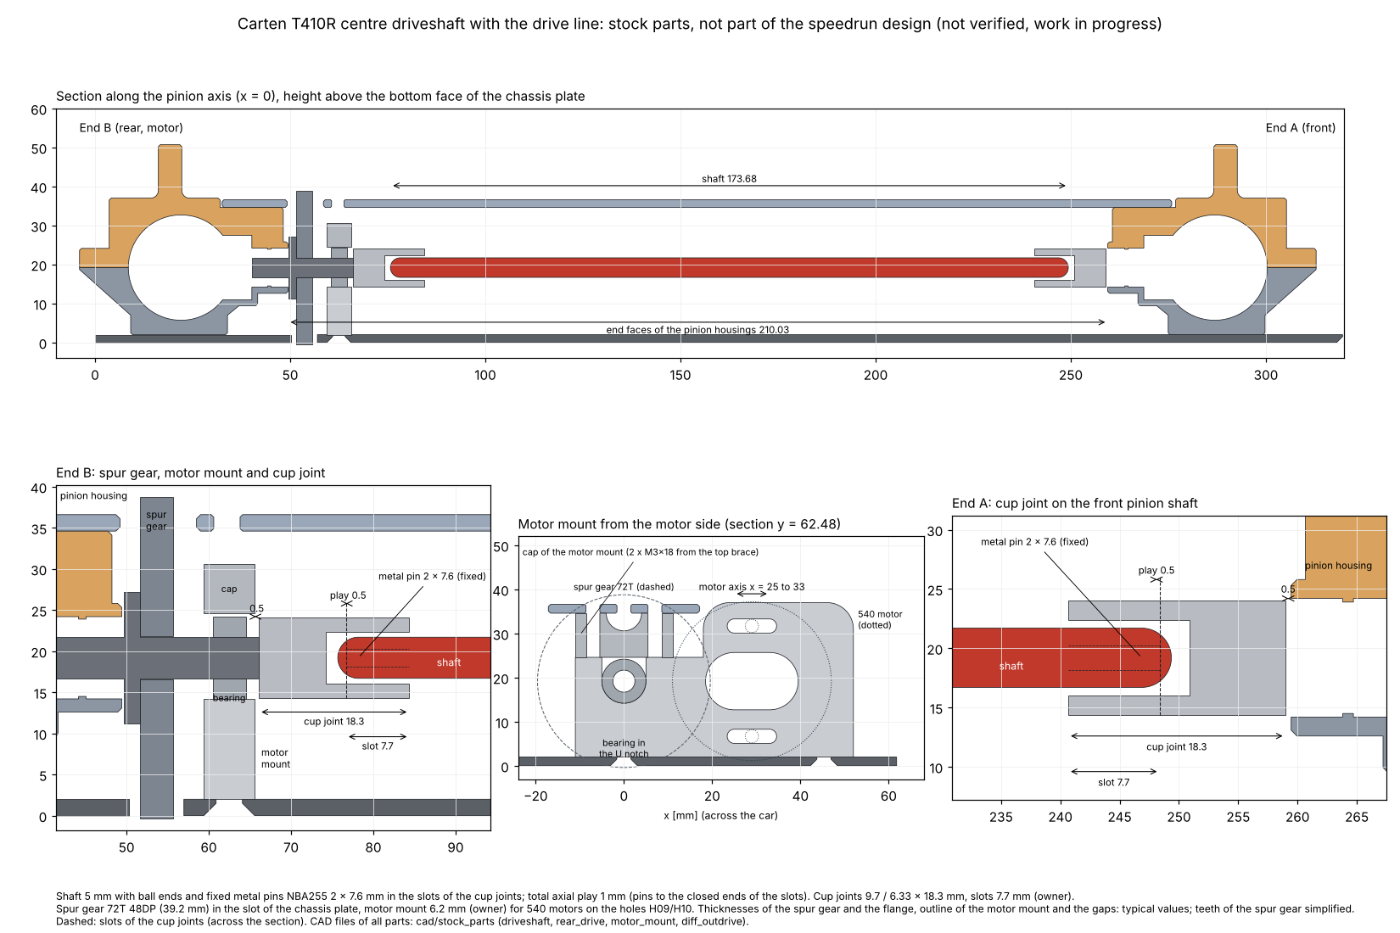
[picture p10: photos/cad_driveshaft_drawing.png]
Centre driveshaft with the drive line and the motor mount


**Dimensions of the centre driveshaft**

Positions y along the car on the chassis plate (End B at y = 0).

| Dimension | Value | Source |
|:---|:---|:---|
| Pinion axis | x = 0, 19.2 mm above the bottom face of the chassis plate (2.0 + 17.2) | Lower bulkhead (`axis_z`), chassis plate |
| End faces of the pinion housings | y = 49.43 mm (End B) and 259.46 mm (End A) | Lower bulkhead (pinion seat 18.65 + 9.25 = 27.9 mm), positions of the bulkheads |
| Cup joints NBA255 | 9.7 mm outer and 6.33 mm inner diameter, 18.3 mm long, 2 slots 7.7 mm long from the open end (2.1 mm wide); bore 10.2 mm deep. Back end: bore 5.0 mm for the pinion shaft (7.5 mm deep), groove 4.6 to 6.8 mm from the back face (7.4 mm diameter) for the O-ring 5.8 x 9.6 x 1.9 mm, cross hole 2.0 mm in the groove for the retaining pin | Owner (dimensions, mounting, photos with a ruler), manual step 5 (pin, O-ring), estimates (bore depths) |
| Cup joint End A | From y = 258.96 to 240.66 mm (0.5 mm from the end face of the pinion housing) | Typical value (gap) |
| Rear pinion shaft NBA205 | Sections from the pinion: press fit shape for the pinion (5.0 mm with two flats, 4.2 mm across the flats) with an axial M3 thread (tap drill 2.5 mm, 6.0 mm deep) for the pinion screw M3x6; 5.0 mm for the 2 bearings NBA298 of the bulkhead (y = 40.18 to 49.08 mm, rib 0.9 mm); flange 21.7 x 2.5 mm (mounting plate of the spur gear, y = 49.63 to 52.13 mm) with 4 M3 threads on a radius of 8.8 mm; spigot 9.3 mm through the spur gear, 2.2 mm beyond it; shoulder 6.7 mm against the inner ring of the bearing in the motor mount; 5.0 mm for this bearing; press fit shape for the cup joint with a cross hole 2.0 mm for the retaining pin NBA255 2.0 x 7.6 mm (separate part; end of the shaft at y = 72.98 mm, 7.0 mm in the cup joint) | Manual (step 5), owner (press fit shapes, screws, photos), bulkhead (seat), estimates (flats, lengths) |
| Spur gear | Standard 72T 48DP, 39.16 mm outer diameter, teeth with a simplified trapezoidal profile (not involute), 4.0 mm thick, y = 52.13 to 56.13 mm, in the slot of the chassis plate below the pinion axis (y = 50.28 to 56.97 mm); centre bore 9.4 mm on the spigot of the shaft; 4 holes 3.2 mm on a radius of 8.8 mm for the screws M3 into the flange; lightening holes 4 x 3.2 mm on a radius of 8.8 mm and 8 x 3.5 mm on a radius of 12.5 mm | Owner (72T 48DP, photos), chassis plate (position), typical value (thickness) |
| Motor mount NBA201 for 540 motors | Plate 6.0 mm thick, y = 59.48 to 65.48 mm, on the holes H09 and H10 (y = 62.48 mm); the motor window starts at y = 65.63 mm. Low part (x = -11 to 18 mm, 24.4 mm high) with a U-shaped notch 10.6 mm wide, open to the top, for the bearing NBA298 5 x 10 x 4 mm at the pinion axis; on the side toward End A a lip 1.0 mm wide (opening 8.0 mm) against which the bearing lies. Tall part (x = 18 to 52 mm, 37 mm high, top corners R6) beside the end of the top brace, with three long holes along x: motor shaft (13 mm wide, at the height of the pinion axis), motor screws M3 (3.2 mm wide, 12.5 mm above and below; 540 motors: screws 25 mm apart). Motor axis x = 25 to 33 mm: centre distance 27.0 to 31.0 mm for the 72T 48DP spur gear and motor pinions of 30 to 45 teeth, plus 2 mm | Owner (thickness, notch, lip, measurement sheet), chassis plate (position), derived (height of the low part: top brace minus cap), manual step 10 (shape), typical values (outline, opening of the lip) |
| Cap of the motor mount (second part of NBA201) | Block 22 x 6.0 x 10.2 mm on the low part of the motor mount, from 24.4 mm up to the top brace (34.6 mm), 0.2 mm above the bearing; semicircular notch R4 along y in its top face below the hole B09 of the top brace; 2 through holes 3.2 mm below the holes B10 and B11 of the top brace (x = +-7.02 mm, y = 62.15 mm). 2 screws M3x18 from the top brace through the cap into the motor mount fix the motor mount to the top brace; set screw M3x3 in the cap (manual step 25) | Owner (height), manual (steps 25, parts list), top brace (holes), typical values (width, notch) |
| Pinion NBA207 | 17 teeth, 14.1 mm outer diameter at the large end, 4.1 mm long, large end against the inner bearing of the bulkhead (y = 36.08 to 40.18 mm, in the pinion pocket of the bulkhead); simplified straight bevel gear: the teeth converge to the apex of the pitch cone (pitch cone angle 22 degrees); bore with the press fit shape of the shaft, countersink for the screw M3x6 | Owner (teeth, side photo with the bearing as scale: length, large end at the bearing), bulkhead (no. 29: outer diameter), gear ratio 42/17 (cone angle), estimate (tooth profile) |
| Front pinion shaft NBA205 (End A) | Same sections as the rear pinion shaft without flange, spur gear and motor mount: press fit shape for the pinion with the axial M3 thread, 5.0 mm through the 2 bearings of the bulkhead (y = 268.71 to 259.81 mm), press fit shape for the cup joint with the cross hole of the retaining pin; 19.15 mm long, end 7.0 mm in the cup joint (y = 251.96 mm). Pinion NBA207, bearings and retaining pin as at End B, turned by 180 degrees with the bulkhead | Manual (step 5), owner (photos), bulkhead (seat) |
| Differentials | See [differentials](#differentials) | |
| Bearings NBA298 in the bulkhead | 2 x 5 x 10 x 4 mm in the pinion seat, y = 40.18 to 44.18 mm and 45.08 to 49.08 mm (rib 0.9 mm between them) | Manual (step 5), bulkhead (seat) |
| Cup joint End B | From y = 65.98 to 84.28 mm (0.5 mm beyond the motor mount, on the end of the rear pinion shaft) | Typical value (gap) |
| Shaft | Rod 6.0 mm, ball ends 5.0 mm (radial clearance 0.665 mm in the cup joints), neck of 5.0 mm up to 4.0 mm from the centres of the balls | Owner (rod), ruler photo (ball ends) |
| Metal pins | 2.0 x 7.6 mm, fixed on the shaft at the centres of the ball ends, part of the model of the shaft | Owner (fixed pins), size as NBA255 |
| Pins in the centred position | y = 78.47 mm and 246.47 mm, 168.00 mm apart (ruler: 167.9 mm); 0.89 mm to the closed ends of the slots (y = 76.58 and 248.36 mm) | Derived |
| Length of the shaft | 173.00 mm over the ball ends | Owner (ruler) |
| Axial play | 1.78 mm in total, 0.89 mm at each pin to the closed end of its slot: follows from the measured length of the shaft and the positions of the cup joints | Derived |
| Diff outdrives | Hexagon shaft 5.6 mm across the flats (press fit of the side gear, through the hexagon bore of the ring gear or of the case hub and the lip opening of the bulkhead, 12.28 mm), cup 12.0 mm outer diameter, 10.0 mm long, 0.3 mm beyond the side faces of the bulkheads on the diff axes, bore 9.6 x 8.0 mm (wall 1.2 mm), 2 slots 2.1 x 7.0 mm for the holding pin of the dogbones | Owner (hexagon press fit), typical values (cup) |

**Checks of the centre driveshaft**

Results of `generate_driveshaft.py`:

| Check | Result |
|:---|:---|
| Shaft in the cup joints | 0 mm³ overlap; pins 0.05 mm per side in the slots, pin ends 1.05 mm inside the cup joints |
| Ends of the shaft | 1.89 mm to the bottoms of the bores |
| Shaft, cup joints, rear drive line, motor mount and diff outdrives with the bulkheads, the chassis plate and the top brace | 0 mm³ overlap; the spur gear runs through the slot of the chassis plate and below the obround of the top brace, the tall part of the motor mount lies 0.76 mm beside the end of the top brace, the cap of the motor mount touches the top brace |

* Not modelled: the motor, the screws of the pinions, the shims between the bearings, the O-rings NBA255 5.8 x 9.6 x 1.9 mm in the grooves of the cup joints (see `specs/mechanics/carten_t410r/drivetrain/spec_driveshaft_and_joints.yaml`).

**Open points of the centre driveshaft**

* Not measured: thickness of the spur gear (4.0 mm), dimensions of the rear pinion shaft from the photos (flange 21.7 x 2.5 mm, spigot 9.3 mm, shoulder 6.7 mm, flats 4.2 mm across) and of the pinion (length 4.1 mm from the side photo), the gaps between the motor mount or the pinion housing and the cup joints (0.5 mm), depths of the bores of the cup joints, opening of the lip of the bearing seat (8.0 mm), outline of the tall part of the motor mount (height, long holes) and of the cap (width, notch).
* Motor mount: the measured height of the low part (MM3: 23.2 mm) does not fit the stack: with the cap (10.2 mm) below the top brace (34.6 mm above the bottom face of the chassis plate), the low part is 22.4 mm high in the model. The depth of the U notch (MM2: 10.3 mm) fits within 0.2 mm. Open: MM3, MM5 (does the cap touch the bearing), MM8 (set screw M3x3 of the cap).
* Length of the shaft: checked with a ruler (173.0 mm over the ball ends); the model uses this length.
* Spur gear: the specifications (`spec_spur_gear.yaml`, `spec_gearing.yaml`) and the setup sheet list a 68T spur gear; the model uses the standard 72T 48DP spur gear of the owner.

**Files of the centre driveshaft and the drive line**

All files are stored in the directory `/stock_parts` and are generated with `generate_driveshaft.py` from `driveshaft/driveshaft_parameters.json` (see [scripts](#scripts)). Each file has STEP (AP214) and STL (binary) format and its own part coordinates.

| File | Part coordinates and use |
|:---|:---|
| `driveshaft/driveshaft_T410R` | Centre driveshaft with the fixed metal pins, along y from 0 to 173.00 mm, axis at x = 0, z = 0, pins along x |
| `driveshaft/cup_joint_T410R` | Cup joint (2 pieces): along y, back face at y = 0, open end at y = 18.3 mm, slots and cross hole of the retaining pin along x |
| `rear_drive/rear_pinion_shaft_T410R` | Rear pinion shaft with flange: along y, y = 0 end face of the pinion housing of the bulkhead, from y = -11.65 mm (inside the bulkhead) to 23.55 mm, with the cross hole of the retaining pin |
| `front_drive/front_pinion_shaft_T410R` | Front pinion shaft (End A), in the same coordinates as the rear pinion shaft: y = 0 end face of the pinion housing, y > 0 toward the cup joint; pinion, bearings and retaining pin as the files in `rear_drive` |
| `rear_drive/retaining_pin_2x7.6_NBA255` | Retaining pin of the cup joint (2.0 x 7.6 mm), in the coordinates of the rear pinion shaft |
| `rear_drive/pinion_17T_NBA207` | Pinion NBA207 17T, in the coordinates of the rear pinion shaft |
| `rear_drive/spur_gear_72T_T410R` | Spur gear 72T 48DP: along y from y = 0 (face on the flange) to 4.0 mm, axis at x = 0, z = 0 |
| `rear_drive/bearing_5x10x4` | Bearing NBA298 in the motor mount: along y from y = 0 to 4.0 mm |
| `motor_mount/motor_mount_T410R` | Motor mount: x = 0 pinion axis, y = 0 middle of the plate, z = 0 bottom face (on the chassis plate) |
| `motor_mount/motor_mount_cap_T410R` | Cap of the motor mount, in the coordinates of the motor mount |
| `diff_outdrive/diff_outdrive_T410R` | Diff outdrive (4 pieces): along +x, back face at x = 0, open end at x = 10.0 mm, slots along z |
| `driveshaft/driveshaft_parameters.json` | All dimensions of these parts, each with its source and a note (JSON) |

### Differentials
* **Description:** Models of the differential at End B (rear) with the ring gear 42T, the inner gears, the shims, the bearings NBA299 and the outdrives, and of the spool at End A (front, owner: a spool is installed) with the same ring gear, bearings and outdrives. Stock parts: not part of the speedrun design, modelled for the completeness of the build.
* **Status:** $\color{gold}\blacktriangle$ Measures qualified, no 3D print verification. Main dimensions and the design of the inner parts from the owner (measurements, photos, description), the position from the verified bulkhead.

Differential: complete with the pinion, section, open case, exploded view; spool

| Part | Model | Source |
|:---|:---|:---|
| Position | Diff axis 0.5 mm from the bulkhead centre toward the pinion, 17.2 mm above the bottom face of the bulkhead; ring gear on the +x side of the bulkhead; centre of the inner gears in the plane of the pinion axis (x = 0) | Bulkhead |
| Case (plastic) | 26.0 mm diameter over 10.5 mm from the teeth of the ring gear, then a taper to 14.0 mm at x = -10.3 mm, hub 12.0 mm and journal 10.0 mm for the bearing; inner space 19.0 mm diameter with flat walls at the spider gears (16.4 mm apart), bores and mounting slots for the cross pin, 4 tap holes M2 (1.6 mm, 5.0 mm deep) on a radius of 10.7 mm; hexagon bore 5.6 mm through the hub; 0.5 mm in the case cavity of the bulkhead (radius 13.5 mm), 1.05 mm below the pinion | Owner (26.0 x 10.5 mm, photos), bulkhead, estimates (taper, wall) |
| Ring gear 42T | 31.8 mm, 3.8 mm from the back face (plate side) to the tips of the teeth: teeth toward the case and the pinion (tips at x = 4.9 mm, toothed band from radius 13.2 to 15.9 mm), back face at x = 8.7 mm; central opening 15.9 mm for the side gear with the shoulder for its shims at x = 6.8 mm; hub 12.0 mm and journal 10.0 mm for the bearing; hexagon bore 5.6 mm through the hub for the shaft of the outdrive; 4 clearance holes 2.2 mm for the screws M2 into the case. Mesh with the pinion 17T: tooth gap of the ring gear at the pinion, no overlap (smallest clearance 0.02 mm) | Owner (42T, 31.8 mm, 3.8 mm, photos, hexagon bore, screws), bulkhead (recess, no. 27) |
| Side gears 14T (2 pieces) | Module 1.0, pitch cone angle 57.3 degrees, 15.1 mm outer diameter, back face 6.5 mm from the centre; hexagon bore 5.6 mm on the press fit of the outdrive; 3 shims 0.1 x 6.6 x 12.0 mm behind each side gear | Owner (14T, press fit, 3 shims), photo (diameter), estimates (shim sizes) |
| Spider gears 9T (2 pieces) | Module 1.0, pitch cone angle 32.7 degrees, 10.6 mm outer diameter, on the cross pin, back face 7.9 mm from the centre; 1 shim 0.3 x 4.1 x 9.2 mm behind each spider gear against the flat wall of the case | Owner (2 spider gears, 9T, 1 shim each, photos) |
| Cross pin | 4.0 x 23.3 mm, through the spider gears and the case wall | Photo of the owner |
| Bearings NBA299 | 10 x 15 x 4 mm on the journals of the ring gear and the case hub, x = +-11.0 to +-15.0 mm (30.0 mm over both bearings, 0.35 mm to each lip of the bulkhead) | Manual, bulkhead (no. 28) |
| Spool (End A) | Instead of the case and the inner gears: solid body 15.0 mm, flange 25.0 x 2.0 mm with 4 tap holes M2 for the ring gear, spigot 15.8 mm in the opening of the ring gear, hub 12.0 mm and journal 10.0 mm for the bearing, hexagon bores 5.6 mm for the shafts of both outdrives (up to x = +-2.85 mm). Same ring gear, bearings and outdrives as the differential; shape of the body assumed (inside the envelope of the differential) | Owner (spool), assumption (body) |
| Outdrives | Hexagon shaft 5.6 mm from the front face of the side gear (x = 2.9 mm) through the hub to the cup (see [centre driveshaft and drive line](#centre-driveshaft-and-drive-line)) | Owner (press fit) |

* Checks of `generate_driveshaft.py`: all parts of the differential and the outdrives are valid solids without overlap with each other (19 parts per differential), with the bulkheads, the chassis plate and the top brace. The gear teeth are simplified (straight flanks, tooth profile scaled toward the apex of the pitch cone); the inner gears are turned so that their teeth lie in the tooth gaps.
* Not modelled: ribs of the case, the 4 screws M2, the O-rings and the oil.
* Not measured: module of the inner gears (from the photo), shim thicknesses, wall thickness and inner space of the case, taper of the case.

**Files of the differentials**

All files are stored in the directory `/stock_parts/diff` and are generated with `generate_driveshaft.py` (see [scripts](#scripts)). Diff coordinates: x along the diff axis, x = 0 centre of the inner gears (plane of the pinion axis), ring gear side toward +x; each file has STEP (AP214) and STL (binary) format.

| File | Part coordinates and use |
|:---|:---|
| `diff_case_T410R` | Diff case, cross pin along z |
| `ring_gear_42T_T410R` | Ring gear 42T with hub, in the coordinates of the diff case |
| `side_gear_14T_T410R` | Side gear 14T: along z, apex of the pitch cone at z = 0, back face at z = 6.5 mm |
| `spider_gear_9T_T410R` | Spider gear 9T: along z, apex of the pitch cone at z = 0, back face at z = 7.9 mm |
| `cross_pin_T410R` | Cross pin, along z, centred at the origin |
| `shim_side_gear`, `shim_spider_gear` | Shims (side gear: along x from x = 0; spider gear: along z from z = 7.9 mm) |
| `spool_T410R` | Spool (End A), in the coordinates of the diff case |
| `bearing_10x15x4_NBA299` | Bearing NBA299 of the differential: along x from x = 0 to 4.0 mm |

### Wishbones
* **Description:** Models of the lower wishbones (suspension arms NHA402) of the Carten T410R with the inner hinge pins NHA423 3 x 42 mm. The manual (step 7 and parts list "Arms (F/R)") and the photos of the owner show two different arms: 2 front arms and 2 rear arms. Each arm is used on the left and on the right side of its axle (the same part, turned by 180 degrees).
* **Status:** $\color{gold}\blacktriangle$ Measures qualified, no 3D print verification (front and rear wishbone); inner hinge pins: $\color{red}\times$ Completely unqualified. The main dimensions are caliper measurements of the owner (measurement sheet). The positions of the shock plate and of the holes of the ball studs are estimates from the photos (see the measurement table below).

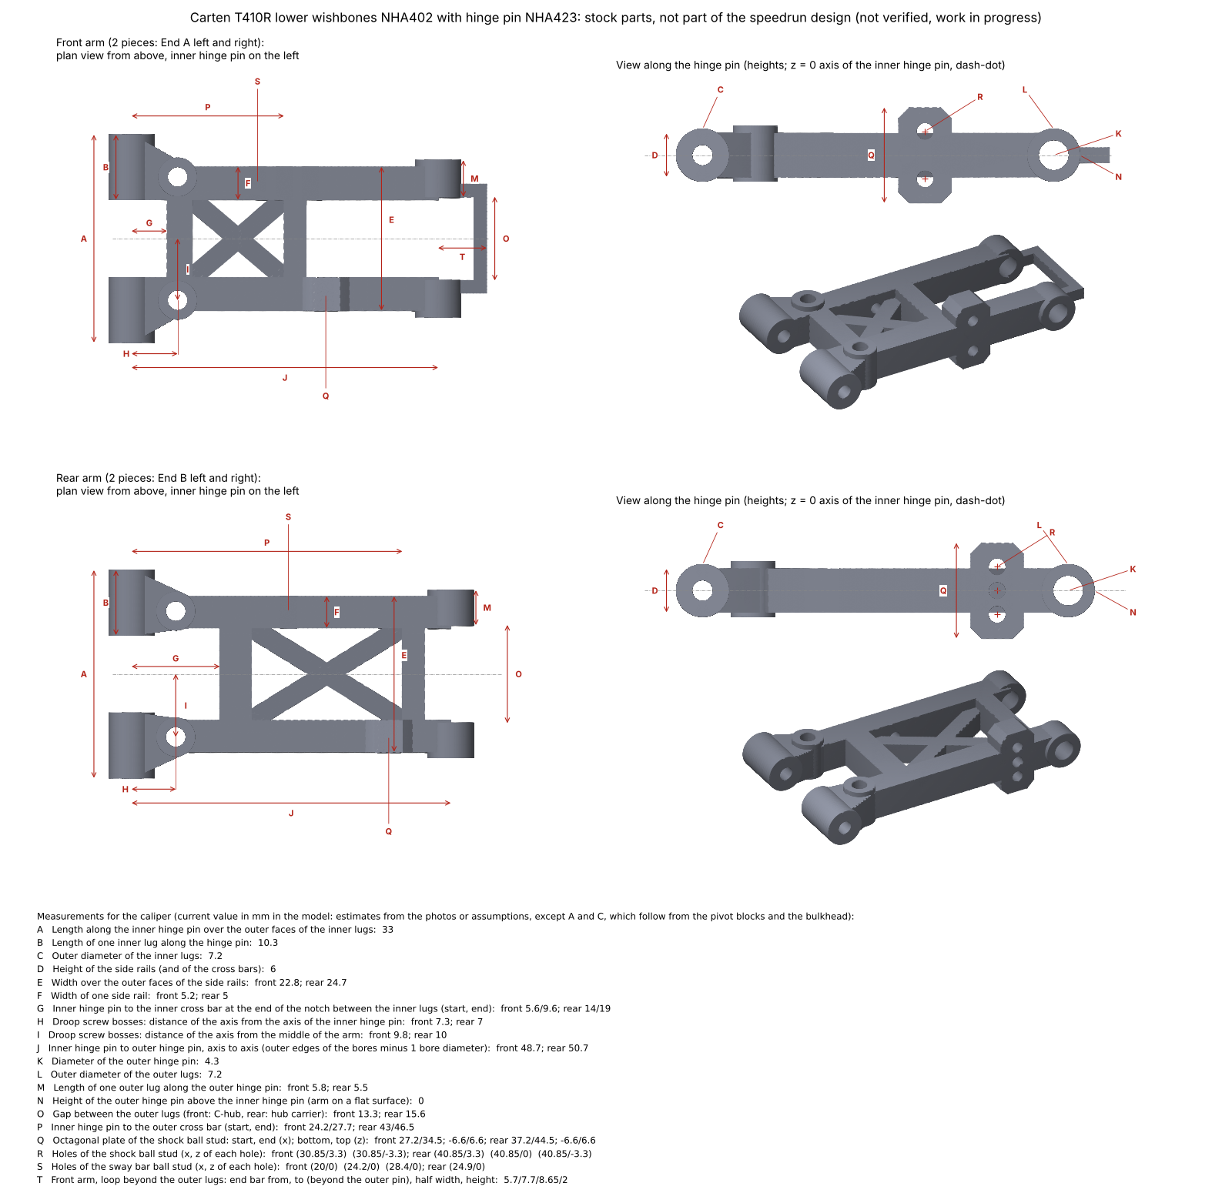
[picture p11: photos/cad_wishbones_drawing.png]
Wishbones: plan views, views along the hinge pin and the letters of the measurements


**Design of the wishbones**

* Frame without a floor: two long inner lugs on the inner hinge pin between the pivot blocks, with an open notch between them up to the inner cross bar; a shoulder from each inner lug to its side rail; two parallel side rails; an open window with X-shaped ribs between the inner cross bar and the outer cross bar; two outer lugs at the ends of the side rails for the outer hinge pin.
* Front arm: side rails 22.8 mm wide over the outer faces, open loop between the outer cross bar and the outer lugs (C-hub NHA403), a thin closed loop beyond the outer lugs.
* Rear arm: side rails 24.7 mm wide over the outer faces, 2 mm longer than the front arm, open U between the outer cross bar and the outer lugs (hub carrier NHA404).
* Above each shoulder a boss with a thread M4 for the droop screw NHA430 M4 x 10 mm (one of the two is used, depending on the side of the car).
* On side rail A an octagonal plate that reaches above and below the rail, with holes M3 for the ball stud of the shock (set screw M3 x 8 mm with ball NBA210): front 2 holes, rear 3 holes. On side rail B holes M3 for the ball stud of the sway bar drop link: front 3 holes, rear 1 hole. The holes go through, so that the ball stud can be set from the side that faces the shock tower.
* Not modelled: radii, draft angles, the pivot balls NBA211 at the ends of the hinge pins, the ball studs, the droop screws and the outer hinge pins.

**Position and checks of the wishbones**

* The inner hinge pins run through the axes of the bores of the pivot blocks, 4.6 mm above the top face of the chassis plate (6.6 mm above its bottom face). Each arm is centred between the faces of its two pivot blocks.
* End A (front arms): both pivot blocks are short blocks; the hinge pins are parallel to the axis of the car at x = ±20.7 mm.
* End B (rear arms): the outer pivot block is the long block (bores at x = ±22.3 mm), the inner block is a short block (±20.7 mm). The hinge pins are turned by 2.33 degrees to the axis of the car; the outer ends of the arms point toward the middle of the car (toe-in of the rear wheels, `spec_cartent410r.yaml`: 2.5 degrees with the rear toe blocks).
* The model is horizontal: inner and outer hinge pin at the same height. The ride height and the travel of the suspension are not modelled.

Results of `generate_wishbones.py`:

| Check | Result |
|:---|:---|
| Solids | Front arm 60.0 x 33.0 x 13.2 mm, rear arm 57.9 x 33.0 x 13.2 mm: one valid solid each |
| Arms and lower bulkhead | End A: 2.16 mm³ overlap per arm: the inner lugs (7.2 mm) reach 0.14 mm into the side face of the lower bulkhead (x = 17.24 mm, hinge pin at x = 20.7 mm); see open point below. End B: 0 mm³, 0.30 mm clearance |
| Inner lugs and pivot blocks | 0 mm³ overlap; 0.14 mm on each side at End A, 0.10 mm at End B (the arm is turned by 2.33 degrees to the faces of the blocks) |
| Arms and chassis plate | 0 mm³ overlap; the octagonal plates reach below the top face of the chassis plate, but lie beside its outline |
| Hinge pins in the bores of the pivot blocks | Play of the ends to the bottoms of the bores: 0.34 mm at End A, 0.45 mm at End B (pin 42 mm) |
| Assembly | See [assembly file](#assembly-file) |

**Measurements for the wishbones**

The letters are shown in the drawing and in the measurement sheet `stock_parts/stock_parts_measurement_sheet.pdf` (A4, 4 pages: drawings of both arms with dimension lines, a table with empty fields for the measured values, and the bearing seat of the motor mount). x: distance from the axis of the inner hinge pin toward the wheel; y: distance from the middle of the arm; z: height above the axis of the inner hinge pin. Current values in the model:

| Letter | Measurement | Front arm | Rear arm | Source |
|:---|:---|---:|---:|:---|
| A | Length along the inner hinge pin over the outer faces of the inner lugs | 33.0 | 33.0 | Caliper |
| B | Length of one inner lug along the hinge pin | 10.3 | 10.3 | Caliper |
| C | Outer diameter of the inner lugs | 7.2 | 7.2 | Caliper |
| D | Height of the side rails and of the cross bars | 6.0 | 6.0 | Caliper |
| E | Width over the outer faces of the side rails | 22.8 | 24.7 | Caliper |
| F | Width of one side rail | 5.2 | 5.0 | Caliper |
| G | Inner hinge pin to the inner cross bar at the end of the notch (start) | 5.6 | 14.0 | Caliper |
| H | Droop screw bosses: distance of the axis from the axis of the inner hinge pin | 7.3 | 7.0 | Caliper |
| I | Droop screw bosses: distance of the axis from the middle of the arm | 9.8 | 10.0 | Caliper |
| J | Inner hinge pin to outer hinge pin, axis to axis (outer edges minus 4.3 mm) | 48.7 | 50.7 | Caliper |
| K | Bore of the outer lugs | 4.3 | 4.3 | Caliper |
| L | Outer diameter of the outer lugs | 7.2 | 7.2 | Caliper |
| M | Length of one outer lug along the outer hinge pin | 5.8 | 5.5 | Caliper |
| N | Height of the outer hinge pin above the inner hinge pin | 0 | 0 | Assumption |
| O | Gap between the outer lugs | 13.3 | 15.6 | Caliper |
| P | Inner hinge pin to the outer cross bar (start) | 24.2 | 43.0 | Caliper |
| Q | Octagonal plate of the shock ball stud: height, width (position from the photos) | 13.2, 7.3 | 13.2, 7.3 | Caliper, photo |
| R | Holes of the shock ball stud (x, z) | (30.85, 3.3), (30.85, -3.3) | (40.85, 3.3), (40.85, 0), (40.85, -3.3) | Photo |
| S | Holes of the sway bar ball stud (x, z) | (20.0, 0), (24.2, 0), (28.4, 0) | (24.9, 0) | Photo |
| T | Outer pin axis to the outer edge of the loop beyond the outer lugs | 7.7 | - | Caliper |

* J: the caliper value over the outer edges of the two bores minus 4.3 mm (both bores taken as 4.3 mm). If the bore of the inner lugs is 3.0 mm (hinge pin 3 x 42 mm), J is 0.65 mm longer.
* Open point: with the measured inner lugs (7.2 mm), the front arms reach 0.14 mm into the side faces of the lower bulkhead at End A. To be checked on the car. If they touch, the side faces of the lower bulkhead can be narrowed at the inner lugs (outer shape; the inside of the bulkhead is not changed).
* The shock plate is assumed symmetric to the axis of the inner hinge pin (13.2 mm high).

**Files of the wishbones**

All files are stored in the directory `/stock_parts/wishbone`. They are generated with `generate_wishbones.py` from `wishbone_parameters.json` (see [scripts](#scripts)). Part coordinates: x from the axis of the inner hinge pin toward the wheel, y along the hinge pin (y = 0 middle of the arm), z = 0 axis of the inner hinge pin.

| File | Format | Content |
|:---|:---|:---|
| `wishbone_front_T410R.step`, `wishbone_rear_T410R.step` | STEP (AP214) | Solid models of the front arm and the rear arm |
| `wishbone_front_T410R.stl`, `wishbone_rear_T410R.stl` | STL (binary) | Triangle meshes |
| `hinge_pin_3x42_NHA423.step`, `hinge_pin_3x42_NHA423.stl` | STEP, STL | Inner hinge pin, along y, centred at y = 0 |
| `wishbone_parameters.json` | JSON | All dimensions, each with its source, the letter of the measurement and a note |

## Scripts
The directory `scripts/cad` contains the Python scripts that generate the files of the chassis plates and the bulkheads. The scripts are run from the root directory of the repository. Without arguments, the scripts of the chassis plates read and write the files of the speedrun chassis plates (except `generate_chassis_templates.py`, which writes the templates of the chassis plate and the top brace), and the scripts of the bulkhead read and write the files of the lower bulkhead and the upper bulkhead. The option `--help` lists the arguments of each script. The required packages are installed with `pip install cadquery ezdxf matplotlib reportlab`.

| Script | Input | Output | Package |
|:---|:---|:---|:---|
| `geometry_from_step.py` | STEP file of the speedrun chassis plate (wide), geometry data of the chassis plate | Geometry data of the speedrun chassis plate (wide). The option `--check` compares the rebuilt solid with the STEP file. | cadquery |
| `lengthen_motor_window.py` | Geometry data of the speedrun chassis plate (wide) | Geometry data with the motor window 10 mm longer toward End A (option `--length`) | None |
| `generate_solid.py` | Geometry data | STEP and STL file. Helper module: plates with edge chamfers and hole chamfers (speedrun top brace, speedrun shock towers) | cadquery |
| `generate_dxf.py` | Geometry data | DXF file (see [DXF generation](#dxf-generation)) | ezdxf |
| `check_motor_window.py` | STEP files and geometry data of both speedrun chassis plates | Check results: solid, volume, section through the window, holes, distances to the countersinks | cadquery |
| `generate_drawing.py` | Geometry data of the speedrun chassis plate (wide) and the chassis plate | Drawing `photos/cad_chassis_speedrun_wide_drawing.png` | matplotlib |
| `generate_window_preview.py` | Geometry data of both speedrun chassis plates | Preview image `photos/cad_chassis_speedrun_wide_motor10_preview.png` | matplotlib |
| `generate_print_template.py` | Geometry data of both speedrun chassis plates and the chassis plate | Print templates of both speedrun chassis plates (option `--plate wide` or `--plate motor10`). The option `--print-scale` sets the scale of the PDF viewer. | reportlab |
| `generate_chassis_templates.py` | Geometry data of the chassis plate and the top brace | Print templates `chassis_plate_T410R_1to1_A3.pdf`, `chassis_plate_T410R_1to1_A4x2.pdf`, `top_brace_T410R_1to1_A4.pdf` and the drawing `photos/cad_chassis_drawing.png`. The options `--print-scale` and `--suffix` generate pre-scaled templates (for example `_print97`). | matplotlib, reportlab |
| `generate_top_brace_speedrun.py` | Geometry data of the original top brace, parameter files of the bulkheads | All files of the speedrun top brace, drawing `photos/cad_top_brace_speedrun_drawing.png`, checks of the outline and of the fit to the bulkheads | cadquery, ezdxf, matplotlib, reportlab |
| `generate_shock_towers.py` | Parameter files of the bulkheads and of the shock towers (option `--tower front`, `rear` or `all`) | All files of the speedrun front and rear shock tower, drawings `photos/cad_shock_tower_front_drawing.png` and `photos/cad_shock_tower_rear_drawing.png`, checks of the fit to the bulkheads | cadquery, ezdxf, matplotlib, reportlab |
| `generate_pivot_blocks.py` | Parameter file of the pivot blocks, geometry data of the speedrun chassis plate, parameter files of the bulkheads | STEP and STL files of the stock pivot blocks (reference), drawing `photos/cad_pivot_blocks_drawing.png`, checks of the mounting holes and of the clearance to the bulkheads | cadquery, matplotlib |
| `generate_driveshaft.py` | Parameter file of the driveshaft, parameter files of the bulkheads, STEP file of the speedrun chassis plate | STEP and STL files of the stock centre driveshaft, cup joint, rear pinion shaft, spur gear, bearing, motor mount with cap and diff outdrive, drawings `photos/cad_driveshaft_drawing.png` and `photos/cad_differential_drawing.png`, checks of the play and of the fit | cadquery, matplotlib |
| `generate_wishbones.py` | Parameter file of the wishbones, parameter files of the pivot blocks and the bulkheads, geometry data and STEP file of the speedrun chassis plate | STEP and STL files of the stock front and rear wishbones and of the inner hinge pin, drawing `photos/cad_wishbones_drawing.png` with the letters of the measurements, checks of the clearance to the pivot blocks, the bulkheads and the chassis plate and of the play of the hinge pins | cadquery, matplotlib |
| `generate_measurement_sheets.py` | Parameter files of the wishbones and of the driveshaft | Measurement sheet `stock_parts/stock_parts_measurement_sheet.pdf` of the stock parts that are not measured yet (wishbones, bearing seat of the motor mount) | cadquery, matplotlib |
| `generate_speedrun_assembly.py` | STEP file of the speedrun chassis plate with the longer motor window, parameter files of the bulkheads, of the shock towers, of the pivot blocks, of the driveshaft and of the wishbones, geometry data of the speedrun top brace | Assembly `assembly/speedrun_chassis_T410R.step`, image `photos/cad_speedrun_chassis_assembly.png`, volumes and masses, interference check of all parts | cadquery, matplotlib |
| `generate_bulkhead_lower.py` | Parameter file of the lower bulkhead | STEP and STL file, test print STL file, geometry checks | cadquery |
| `generate_bulkhead_drawings.py` | STEP, STL and parameter file of the lower bulkhead | Preview image `photos/cad_bulkhead_lower_preview.png` and measurement sheet (PDF) | cadquery, matplotlib |
| `generate_bulkhead_upper.py` | Parameter files of the upper and the lower bulkhead | STEP and STL file of the upper part, test print STL file, assembly STEP file, interference check, geometry checks | cadquery |
| `generate_bulkhead_upper_drawings.py` | Parameter files, photos of the stock upper part | Preview image `photos/cad_bulkhead_upper_preview.png` and measurement sheet of the stock upper part (PDF) | cadquery, matplotlib |
| `mesh_views.py` | None | Helper module: shaded views of STL files and assemblies, used by the drawing scripts of the bulkheads | matplotlib |

### Regenerating the files
The following commands regenerate the files of the speedrun chassis plates in this order:

```bash
python scripts/cad/geometry_from_step.py --check
python scripts/cad/lengthen_motor_window.py
python scripts/cad/generate_solid.py cad/chassis/chassis_plate_speedrun_wide_motor10/chassis_plate_speedrun_wide_motor10_geometry.json cad/chassis/chassis_plate_speedrun_wide_motor10/chassis_plate_T410R_speedrun_wide_motor10
python scripts/cad/generate_dxf.py cad/chassis/chassis_plate_speedrun_wide_motor10/chassis_plate_speedrun_wide_motor10_geometry.json cad/chassis/chassis_plate_speedrun_wide_motor10/chassis_plate_T410R_speedrun_wide_motor10.dxf
python scripts/cad/check_motor_window.py
python scripts/cad/generate_drawing.py
python scripts/cad/generate_window_preview.py
python scripts/cad/generate_print_template.py --plate wide
python scripts/cad/generate_print_template.py --plate motor10
```

The following command regenerates the print templates of the chassis plate and the top brace and the drawing `photos/cad_chassis_drawing.png` from their geometry data:

```bash
python scripts/cad/generate_chassis_templates.py
python scripts/cad/generate_chassis_templates.py --print-scale 0.97 --suffix _print97
```

* The regenerated geometry data, STL files and images are identical to the files in the repository. The STEP, DXF and PDF files differ only in header data such as the creation date and internal IDs.
* The STEP and STL files of the speedrun chassis plate (wide) are the source data and are not regenerated.

Both generators of the bulkheads check the solid after each run:
* **Enclosure check:** the intended openings (parting face, lip openings, end of the pinion seat, floor opening below the ring gear) are closed with plugs. The gear cavity must then be a closed void. If it is not, the part has an unwanted opening to the outside.
* **Thin slits and walls:** faces without a common edge that are closer than 0.25 mm (exact distance between the faces). Each pair is reported as a slit (void between the faces), a wall (material between the faces) or a narrow face (the faces are separated by other faces, not by a gap, for example the flat of 0.2 mm between a radius and the end of a block). In a slit or a wall, the point between the two faces is about half the distance away from the surface. Current result: lower part 14 narrow faces (6 at the inside radii, 8 at the ends of stopped edge chamfers), upper part 20 narrow faces (16 at the ends of stopped edge chamfers, 4 at the ends of the root radius beside the narrowed wall); no slits and no walls.
* **Inside corners:** number of vertical inside corners without a radius that are longer than 1 mm (shorter ones occur at the ends of stopped edge chamfers). Current result: 0 in both parts.
* **Edge chamfers:** number and length of the edges with edge chamfers, with stopped edge chamfers and of the edges left as they are, with a list of the edges left as they are.
* **Functional check:** comparison with the model without edge treatment, which has the verified inside of the part (see [edges of the outer shape](#design-of-the-lower-bulkhead)). No added or removed material may touch the cavities, bearing seats, holes or recesses, no material may be added in the keep-out zones, and no radius may reach lower or higher than the material beside it.
* **Interference** of the lower and the upper part (upper generator).

The following commands regenerate the files of the bulkheads from the parameter files (lower part first) and the files of the speedrun top brace and the assembly of the speedrun chassis:

```bash
python scripts/cad/generate_bulkhead_lower.py
python scripts/cad/generate_bulkhead_drawings.py
python scripts/cad/generate_bulkhead_upper.py
python scripts/cad/generate_bulkhead_upper_drawings.py
python scripts/cad/generate_top_brace_speedrun.py
python scripts/cad/generate_shock_towers.py
python scripts/cad/generate_pivot_blocks.py
python scripts/cad/generate_driveshaft.py
python scripts/cad/generate_wishbones.py
python scripts/cad/generate_measurement_sheets.py
python scripts/cad/generate_speedrun_assembly.py
```

### DXF generation
The script `scripts/cad/generate_dxf.py` generates a DXF file for CNC manufacturing from the geometry data (`*_geometry.json`). The geometry data and the DXF file of each part are stored in the same directory:

```bash
python scripts/cad/generate_dxf.py cad/chassis/chassis_plate/chassis_plate_geometry.json cad/chassis/chassis_plate/chassis_plate_T410R.dxf
python scripts/cad/generate_dxf.py cad/chassis/top_brace/top_brace_geometry.json cad/chassis/top_brace/top_brace_T410R.dxf
python scripts/cad/generate_dxf.py cad/chassis/chassis_plate_speedrun_wide_motor10/chassis_plate_speedrun_wide_motor10_geometry.json cad/chassis/chassis_plate_speedrun_wide_motor10/chassis_plate_T410R_speedrun_wide_motor10.dxf
```

* The DXF file contains the layers `OUTLINE` (outer contour), `CUTOUT` (window and slots), `HOLE_THROUGH` (through holes Ø3.2 mm), `CSK_BOTTOM_INFO` (countersink diameter Ø6.2 mm on the bottom face, for information only) and `NOTES` (empty). The top brace has no countersinks, so its layer `CSK_BOTTOM_INFO` is empty.
* For the three parts, the generated geometry is identical to the existing DXF files. Only the creation date and internal IDs of the files differ.
* The speedrun chassis plate (wide) without the longer motor window has no DXF file. It can be generated from `chassis_plate_speedrun_wide_geometry.json` with the same script.

## 3D printed parts
| File | Part | Author | Status |
|:---|:---|:---|:---|
| `fan_mount.stl` | Mount for the 40 mm motor fan from Hobbywing (60 x 50 x 18 mm, 40 mm air opening) | [@kleinnconrad](https://github.com/kleinnconrad) (own design) | Not in use: the motor cooling was removed, since the motor does not heat up significantly during speedruns (ADR-007) |
| `lipo_mock.stl` | Placeholder in the size of a 3S hardcase LiPo battery, for planning installations, electronics and cable management | [@kleinnconrad](https://github.com/kleinnconrad) (own design) | Planning aid |
| `stojan_3dprint_25.stl` | Maintenance stand for RC cars (scale 1:10) for repairs and setup work | [@Upgrade25](https://www.printables.com/@Upgrade25) | In use |
| `T410R_DIFFUSOR_V2_2.stl` | Rear diffuser for the Carten T410R (120 x 70 x 18 mm) | [3DMaxi](https://cults3d.com/en/users/3DMaxi/3d-models) | Printed and mounted on the car; private use only (see [sources](#sources)) |

---

## Sources

The instruction manual of the Carten T410R is not stored in this repository (copyright of the manufacturer). It is available from the manufacturer and from distributors:

* **Manufacturer:** [Carten](https://www.carten-rc.com)
* **Download page of a distributor:** [Blaze-RC downloads](http://blazerc.com/download) ("CARTEN T410 Instruction Manual-FINAL", also covers the T410R)

The RC maintenance stand (`stojan_3dprint_25.stl`) is not mine. The original files and all credits go to the original designer on printables:

* **Original model:** [RC car maintenance stand 1:10 on printables](https://www.printables.com/model/1200600-rc-car-maintenance-stand-110/files)
* **Designer profile:** [Upgrade25](https://www.printables.com/@Upgrade25)

The rear diffuser (`T410R_DIFFUSOR_V2_2.stl`) is not mine. The original file and all credits go to the original designer on Cults3D:

* **Designer profile:** [3DMaxi on Cults3D](https://cults3d.com/en/users/3DMaxi/3d-models)
* **License:** The license of the author covers private use only. The copyright notice of this repository does not apply to this file.
