kleinnconrad/prototyping.rc.speedrun/specs/mechanics/cad/readme.md

# 3D printed parts

## Table of contents
* [Included files](#included-files)
  * [1. Motor fan mount (`fan_mount.stl`)](#1-motor-fan-mount-fan_mountstl)
  * [2. LiPo battery dummy (`lipo_mock.stl`)](#2-lipo-battery-dummy-lipo_mockstl)
  * [3. RC car maintenance stand (`stojan_3dprint_25.stl`)](#3-rc-car-maintenance-stand-stojan_3dprint_25stl)
  * [4. Rear diffuser (`T410R_DIFFUSOR_V2_2.stl`)](#4-rear-diffuser-t410r_diffusor_v2_2stl)
* [Sources](#sources)

This folder contains 3D printed parts (STL files) for the RC car **Carten T410R** as well as a maintenance stand.

## Included files

### 1. Motor fan mount (`fan_mount.stl`)
* **Author:** [@kleinnconrad](https://github.com/kleinnconrad) (own design)
* **Description:** A 50 mm fan mount (60 x 50 x 18 mm, 40 mm air opening) for the **40 mm motor fan from hobbywing**. Designed for mounting in the Carten T410R for installation and cooling of the motor.
* **Status:** Not in use. The motor cooling was removed, since the motor does not heat up significantly during speedruns (ADR-007).

### 2. LiPo battery dummy (`lipo_mock.stl`)
* **Author:** [@kleinnconrad](https://github.com/kleinnconrad) (own design)
* **Description:** A placeholder object in the size of a **3S hardcase LiPo battery**. This model is used for planning installations, electronics and cable management in the Carten T410R. It replaces the physical battery during the design phase.

### 3. RC car maintenance stand (`stojan_3dprint_25.stl`)
* **Author:** [@Upgrade25](https://www.printables.com/@Upgrade25)
* **Description:** A maintenance stand for RC cars (scale 1:10). Intended for repairs, setup work or as a rest.

### 4. Rear diffuser (`T410R_DIFFUSOR_V2_2.stl`)
* **Author:** [3DMaxi](https://cults3d.com/en/users/3DMaxi/3d-models)
* **Description:** A rear diffuser for the Carten T410R (120 x 70 x 18 mm).
* **Status:** Printed and mounted on the car.
* **License:** Private use only (see [sources](#sources)).

---

## Sources

The RC maintenance stand (`stojan_3dprint_25.stl`) is not mine. The original files and all credits go to the original designer on printables:

* **Original model:** [RC car maintenance stand 1:10 on printables](https://www.printables.com/model/1200600-rc-car-maintenance-stand-110/files)
* **Designer profile:** [Upgrade25](https://www.printables.com/@Upgrade25)

The rear diffuser (`T410R_DIFFUSOR_V2_2.stl`) is not mine. The original file and all credits go to the original designer on Cults3D:

* **Designer profile:** [3DMaxi on Cults3D](https://cults3d.com/en/users/3DMaxi/3d-models)
* **License:** The license of the author covers private use only. The licenses of this repository (MIT, CC BY 4.0) do not apply to this file.
