kleinnconrad/prototyping.rc.speedrun/cad/chassis/top_brace_speedrun/top_brace_T410R_speedrun_1to1_A4.pdf

## Carten T410R speedrun top brace - 1:1 template, A4

PRINT AT 100 % ("actual size"), no fit to page.
Check both 100 mm bars with a ruler before use.

Red: through holes Ø3.2 mm with centre cross (not countersunk).
New design for the bulkheads of this project: ends as wide as the bulkheads, solid bar. Origin: x = 0 centre line, y = 0 end edge with B01 to B04 (same as the original top brace). Outline without the edge chamfers (0.5 mm) and the hole chamfers (0.3 mm).

100 mm (x)

100 mm (y)

B01 | B02
B03 | B04
B07 | | B08
B10 | B09 | B11
B12 | B13
B14 | B15
