kleinnconrad/prototyping.rc.speedrun/cad/chassis/chassis_plate/chassis_plate_T410R_1to1_A3.pdf

## Carten T410R chassis plate - 1:1 template, A3

PRINT AT 100 % ("actual size"), no fit to page.
Check both 100 mm bars with a ruler before use.

Top view (side without countersinks): place the plate with the countersinks facing down.
Red: through holes Ø3.2 mm with centre cross. Dashed circles: countersinks Ø6.2 mm (bottom face). Scaled to caliper values: width 99.98 mm, H11 to H23 145.82 mm (centres).
Origin: x = 0 centre line, y = 0 end edge with H01 to H04 (End B).

100 mm (x)

100 mm (y)

H02 | H01
H03 | H04
H05 | H06
H08 | H07
H10 | H09
H11 | H12

H13

H14 | H15

H16

H17

H18 | H19

H20

H21

H23 | H22
H24 | H25
H26 | H27
H28 | H29
H30 | H31
H32 | H33
H35 | H34

H36

End B (H01 to H04)

End A (H34 to H36)
