kleinnconrad/prototyping.rc.speedrun/cad/shock_tower/shock_tower_rear_T410R_speedrun_1to1_A4.pdf

## Carten T410R speedrun rear shock tower - 1:1 template, A4

PRINT AT 100 % ("actual size"), no fit to page.
Check both 100 mm bars with a ruler before use.

Red: through holes Ø3.2 / Ø5.2 mm with centre cross. Outline without the edge chamfers.
Origin: x = 0 centre line, y = 0 parting face of the bulkheads (height above it).
Lay the template on the back face (wall side). T1 to T4: mounting holes, C1/C2: camber links,
D1/D2: dampers, B1/B2 and S1/S2: body post mounts. All holes are at the positions of the stock tower.

100 mm (x)

100 mm (y)

T1 | T2
T3 | T4
C1 | C2
D1 | D2
S1 | S2
B1 | B2
