kleinnconrad/prototyping.rc.speedrun/cad/chassis/top_brace_speedrun/top_brace_speedrun_hole_table.csv

id | x_mm | y_mm | through_d_mm
B01 | -13.05 | 3.35 | 3.2
B02 | 13.05 | 3.35 | 3.2
B03 | -9.55 | 10.29 | 3.2
B04 | 9.55 | 10.29 | 3.2
B07 | -9.51 | 206.97 | 3.2
B08 | 9.51 | 206.97 | 3.2
B09 | 0.00 | 213.65 | 3.2
B10 | -7.02 | 213.71 | 3.2
B11 | 7.02 | 213.71 | 3.2
B12 | -9.49 | 232.90 | 3.2
B13 | 9.49 | 232.90 | 3.2
B14 | -12.83 | 239.48 | 3.2
B15 | 12.83 | 239.48 | 3.2
