kleinnconrad/prototyping.rc.speedrun/cad/chassis_v2/chassis_plate_T410R_v2_1to1_A3.pdf

## Carten T410R chassis plate v2 - 1:1

PRINT AT 100% / "Actual size" - no fit-to-page. Check both 100 mm bars with a ruler before using.
View from the TOP side. Countersinks (dashed, 6.2 mm) are on the BOTTOM face. Red = 3.2 mm through holes. Lay the plate top-side-up on the print, align the outline, look through every hole.
v2: scaled to your caliper values (width 99.98, H11-H23 145.82). Origin x=0 centreline, y=0 rear end edge.
H02 | H01
H03 | H04
H05 | H06
H08 | H07
H10 | H09
H11 | H12

H13

H14 | H15

H16

H17

H18 | H19

H20

H21

H23 | H22
H24 | H25
H26 | H27
H28 | H29
H30 | H31
H32 | H33
H35 | H34

H36

100 mm check: must measure exactly 100 mm
