kleinnconrad/prototyping.rc.speedrun/photos/bulkhead_upper_stock_end_view.jpg

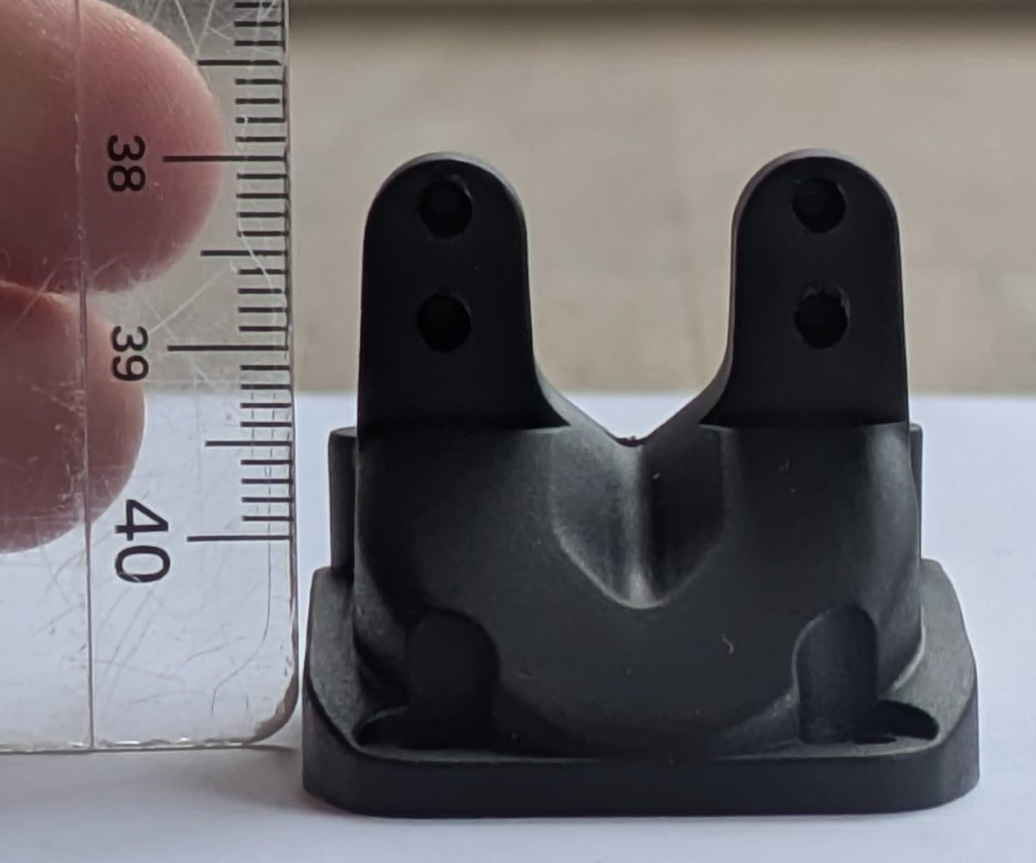
photos/bulkhead_upper_stock_end_view.jpg
