kleinnconrad/prototyping.rc.speedrun/photos/bulkhead_upper_stock_top_view.jpg

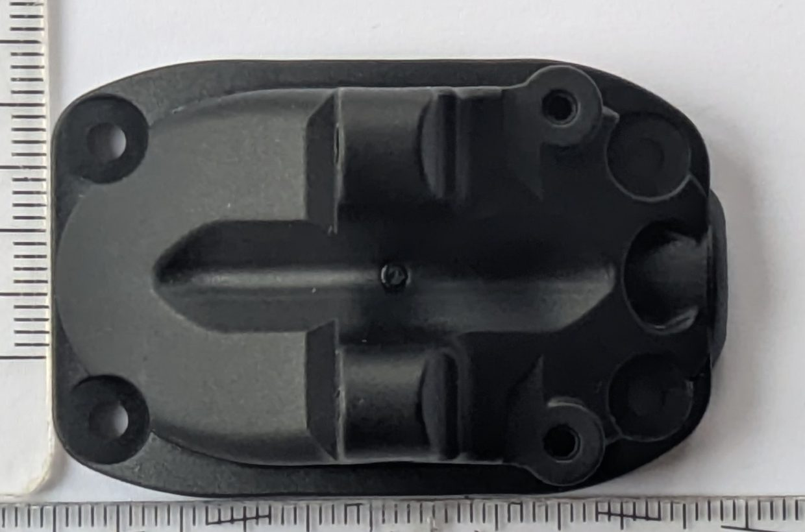
photos/bulkhead_upper_stock_top_view.jpg
