kleinnconrad/prototyping.rc.speedrun/photos/rc_car_chassis_diffuser.jpg

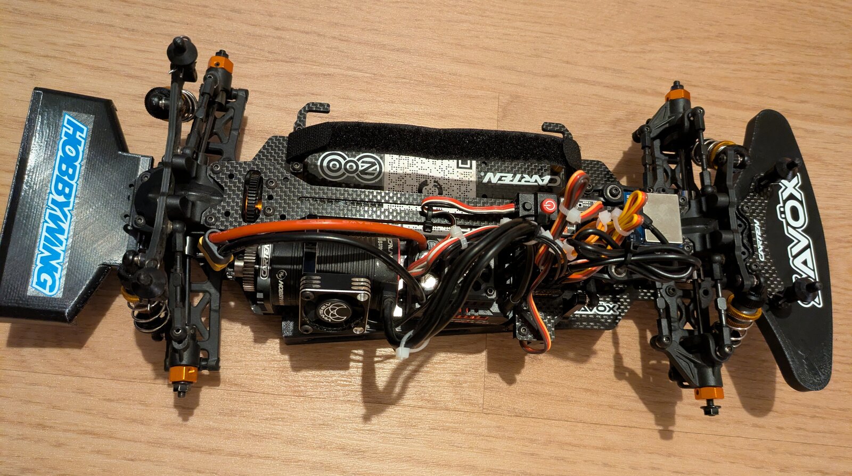
photos/rc_car_chassis_diffuser.jpg
