kleinnconrad/prototyping.rc.speedrun/photos/rc_car_chassis_front.jpg

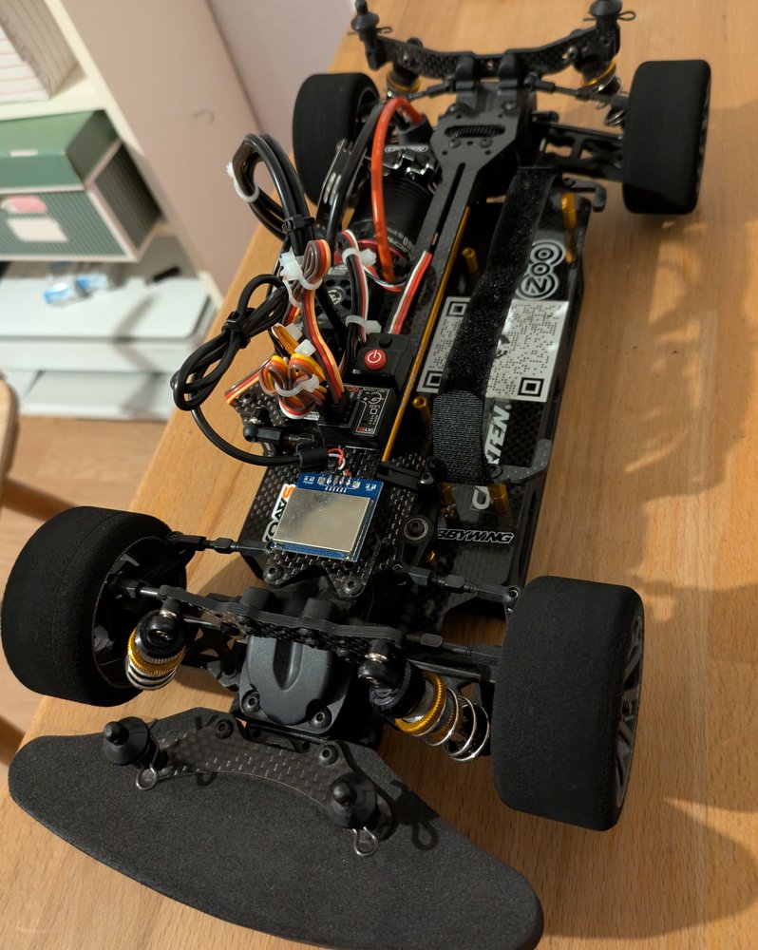
photos/rc_car_chassis_front.jpg
