kleinnconrad/prototyping.rc.speedrun/photos/rc_car_chassis_top.jpg

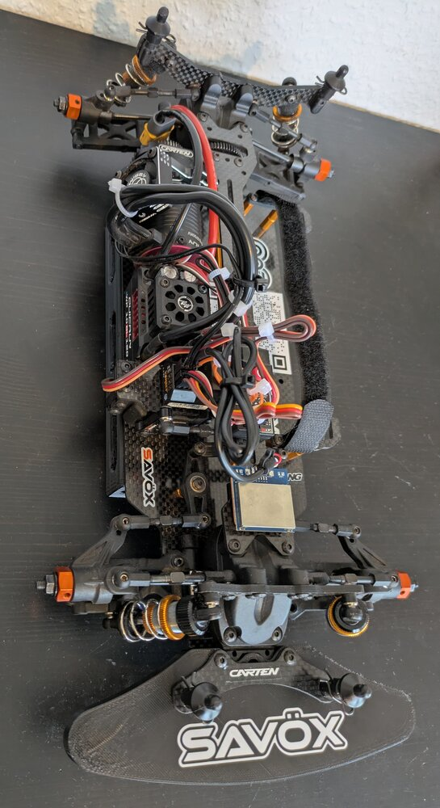
photos/rc_car_chassis_top.jpg
