kleinnconrad/prototyping.rc.speedrun/project/costs/readme.md

# Bill of materials (BOM) - Carten T410R speedrun project

## Table of contents
* [Hardware](#hardware)
* [Cost breakdown](#cost-breakdown)

**Date:** 2026-08-20

## Hardware

| Pos | category | article description | article no. | Dealer | quantity | price |
|:---:|:---|:---|:---|:---|:---:|---:|
| 1 | **chassis** | CARTEN T410R - 1:10 4WD touring car kit | 75-NHA102 | RC-KleinKram | 1 | 179,99 € |
| 2 | **control** | carson REFLEX wheel X1 - 2.4GHz incl. 4-channel receiver (old) | 17-500148 | RC-KleinKram | 1 | 34,99 € |
| 3 | **drive** | hobbywing combo WP10BL120G2 with 3660SL-3700KV-G2 | HW38030211 | monster hopups | 1 | 82,78 € |
| 4 | **energy** | absima greenhorn vol.2 LiPo 3S 11.1V-50C 5000 HC (XT60) | AB-4140014 | monster hopups | 1 | 32,36 € |
| 5 | **mechanics** | robinson-racing motor pinion hardened steel 5mm 48DP 43 teeth | RR-2043 | monster hopups | 1 | 9,18 € |
| 6 | **cooling** | hobbywing fan with cooling fins for 36mm motor (60mm) (old) | HW86080120 | monster hopups | 1 | 9,99 € |
| 7 | **charging tech** | SkyRC S100 neo LiPo 1-6s 10A 100W AC | SK100202-01 | monster hopups | 1 | 44,95 € |
| 8 | **steering** | amewi 4409MG AMX digital servo low-profile (old) | AW-28995 | tamico shop | 1 | 23,99 € |
| 9 | **testing** | QWORK digital tachometer | - | amazon | 1 | 13,88 € |
| 10 | **body** | ZooRacing ZR-0006-07 - HellCat - 1:10 touring car | 10-ZR-0006-07 | RC-KleinKram | 1 | 30,99 € |
| 11 | **tool** | bittydesign BDSS-37855-C curved scissors | 18-BDSS-37855-C | RC-KleinKram | 1 | 10,99 € |
| 12 | **wheels & tires** | Team Corally Attack Moosgummi Reifen 35 shore front & rear | C-14705-35 | - | 2 | 31,98 € |
| 13 | **telemetry** | ruddog GPS/GNSS speed & performance analyzer | RP-0525 | RCFOX | 1 | 54,85 € |
| 14 | **ESC programming** | hobbywing programming box LED universal | HW30501003 | modellbau metz | 1 | 11,49 € |
| 15 | **control** | Konect X9S radio + RG4CHWP receiver | KN-X9S-4CH | RCFOX | 1 | 152,00 € |
| 16 | **steering** | Savöx SC-1252MG+ low-profile servo | SA_SC-1252MG+ | RCFOX | 1 | 52,72 € |
| 17 | **steering** | ALU CLAMP SERVO HORN 25T (HUD293409) | HUD293409 | RCFOX | 1 | 21,50 € |
| 18 | **spare parts** | CARTEN T410R - 1:10 4WD touring car kit | 75-NHA102 | RC-KleinKram | 1 | 179,99 € |
| 19 | **mechanics** | CARTEN NBA360 steel spur gear 48DP 68 teeth | 75-NBA360 | - | 1 | 15,99 € |
| 20 | **telemetry** | WFLY S01G GPS-modul | - | - | 1 | 18,00 € |
| 21 | **steering** | SkyRC GC301 Gyro | - | - | 1 | 25,00 € |

---

## Cost breakdown

| Description | amount |
|:---|---:|
| **Pure vehicle costs:** | **652,49 €** |
| Costs for tools, infrastructure & spare parts (pos. 2, 6, 7, 8, 9, 11, 13, 14, 18): | 385,12 € |
| **Total costs:** | **1037,61 €** |
