kleinnconrad/prototyping.rc.speedrun/cad/shock_tower/shock_tower_front_hole_table.csv

id | x_mm | y_mm | through_d_mm | use
T1 | -9.55 | 22.50 | 3.2 | mounting screw M3x8 (tapped hole of the upper bulkhead)
T2 | 9.55 | 22.50 | 3.2 | mounting screw M3x8 (tapped hole of the upper bulkhead)
T3 | -9.55 | 28.60 | 3.2 | mounting screw M3x8 (tapped hole of the upper bulkhead)
T4 | 9.55 | 28.60 | 3.2 | mounting screw M3x8 (tapped hole of the upper bulkhead)
C1 | -21.24 | 19.10 | 3.2 | camber link ball stud (wheel mount)
C2 | 21.24 | 19.10 | 3.2 | camber link ball stud (wheel mount)
D1 | -31.65 | 30.60 | 3.2 | damper ball stud
D2 | 31.65 | 30.60 | 3.2 | damper ball stud
