kleinnconrad/prototyping.rc.speedrun/cad/bulkhead/bulkhead_assembly_T410R.step

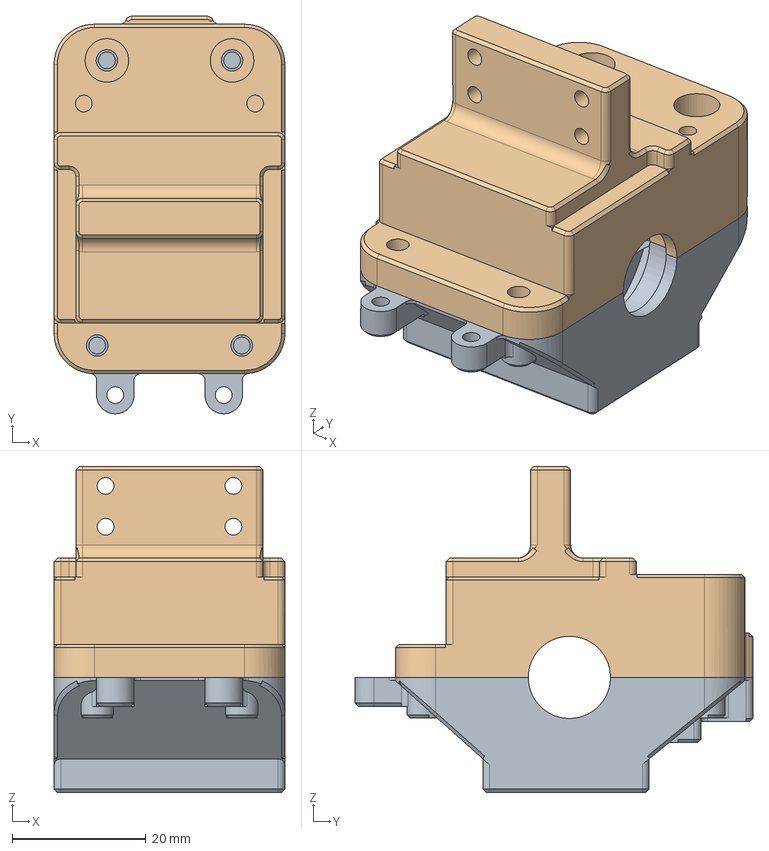
[picture p23: CAD file, 2026-11-13]
cad/bulkhead/bulkhead_assembly_T410R.step
34.5 x 59.4 x 48.7 mm
lower
upper
