kleinnconrad/prototyping.rc.speedrun/cad/assembly/speedrun_chassis_T410R.step

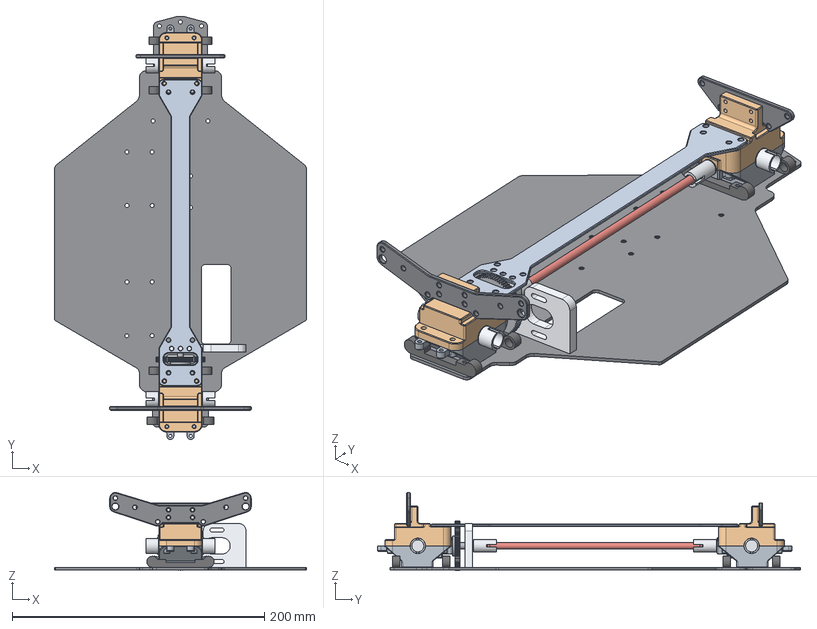
[picture p24: CAD file, 2026-11-14]
cad/assembly/speedrun_chassis_T410R.step
200.0 x 335.6 x 61.9 mm
chassis_plate
lower_bulkhead_End_B
upper_bulkhead_End_B
lower_bulkhead_End_A
upper_bulkhead_End_A
speedrun_top_brace
speedrun_front_shock_tower_End_A
speedrun_rear_shock_tower_End_B
stock_pivot_block_End_B,_outer
stock_pivot_block_End_B,_inner
stock_pivot_block_End_A,_inner
stock_pivot_block_End_A,_outer
stock_centre_driveshaft
cup_joint_End_B
cup_joint_End_A
rear_pinion_shaft_with_flange
spur_gear
bearing_NBA298_in_the_motor_mount
motor_mount
cap_of_the_motor_mount
diff_outdrive_End_B_+x
diff_outdrive_End_B_-x
diff_outdrive_End_A_+x
diff_outdrive_End_A_-x
