kleinnconrad/prototyping.rc.speedrun/cad/bulkhead/testprint_bulkhead_upper.stl

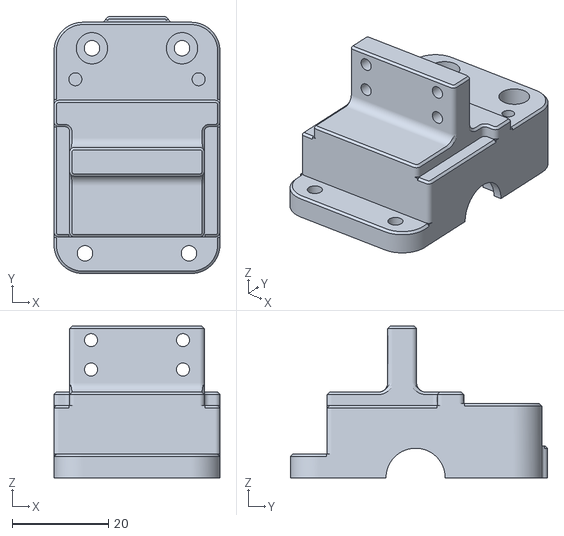
[picture p25: CAD file, 2026-11-13]
cad/bulkhead/testprint_bulkhead_upper.stl
34.5 x 53.4 x 31.5
