kleinnconrad/prototyping.rc.speedrun/cad/chassis/chassis_plate_speedrun_wide/chassis_plate_T410R_speedrun_wide.step

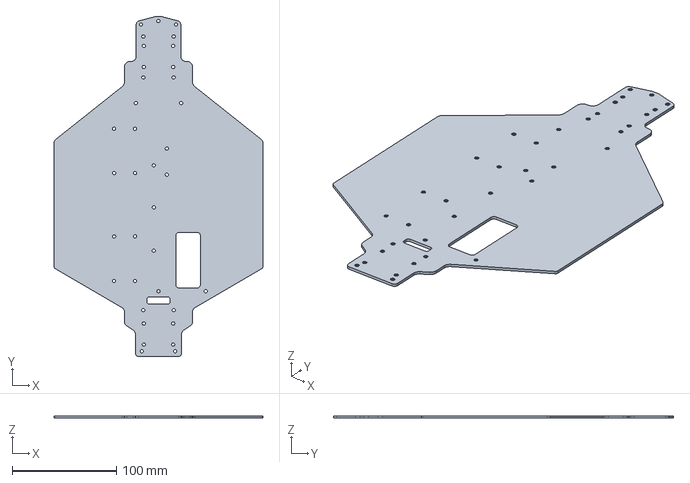
[picture p26: CAD file, 2026-11-12]
cad/chassis/chassis_plate_speedrun_wide/chassis_plate_T410R_speedrun_wide.step
200.0 x 325.6 x 2.00 mm
