kleinnconrad/prototyping.rc.speedrun/cad/chassis/test_print/testprint_chassis_plate_halfA.stl

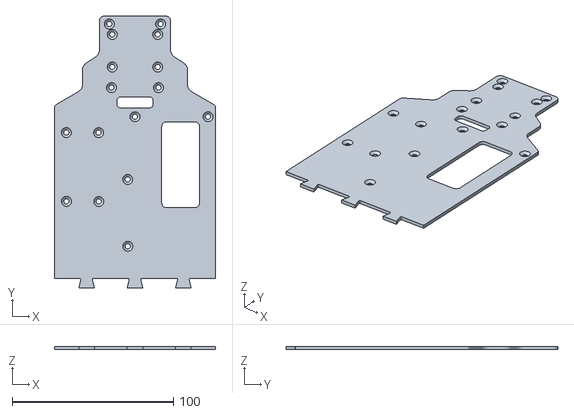
[picture p27: CAD file, 2026-11-12]
cad/chassis/test_print/testprint_chassis_plate_halfA.stl
100.0 x 168.7 x 2.00
