kleinnconrad/prototyping.rc.speedrun/cad/chassis/top_brace/top_brace_T410R.stl

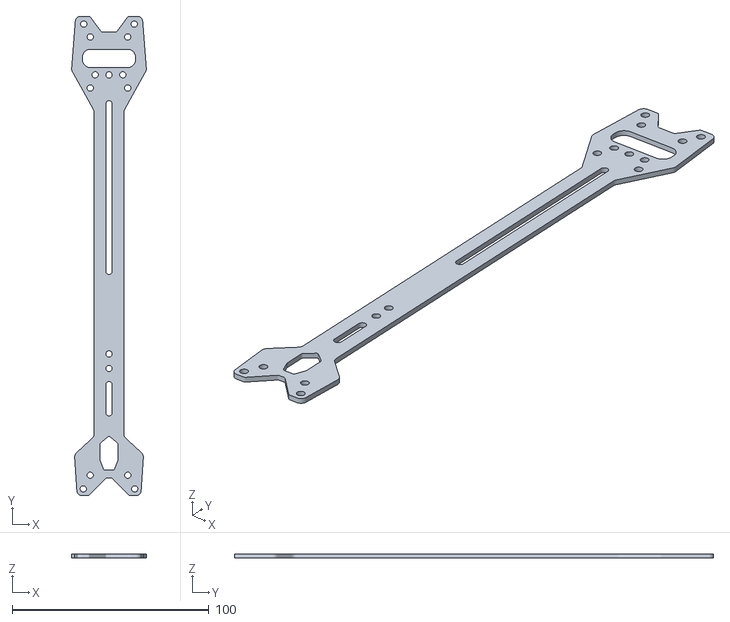
[picture p28: CAD file, 2026-11-12]
cad/chassis/top_brace/top_brace_T410R.stl
38.0 x 243.3 x 2.00
