kleinnconrad/prototyping.rc.speedrun/cad/chassis/top_brace_speedrun/top_brace_T410R_speedrun.step

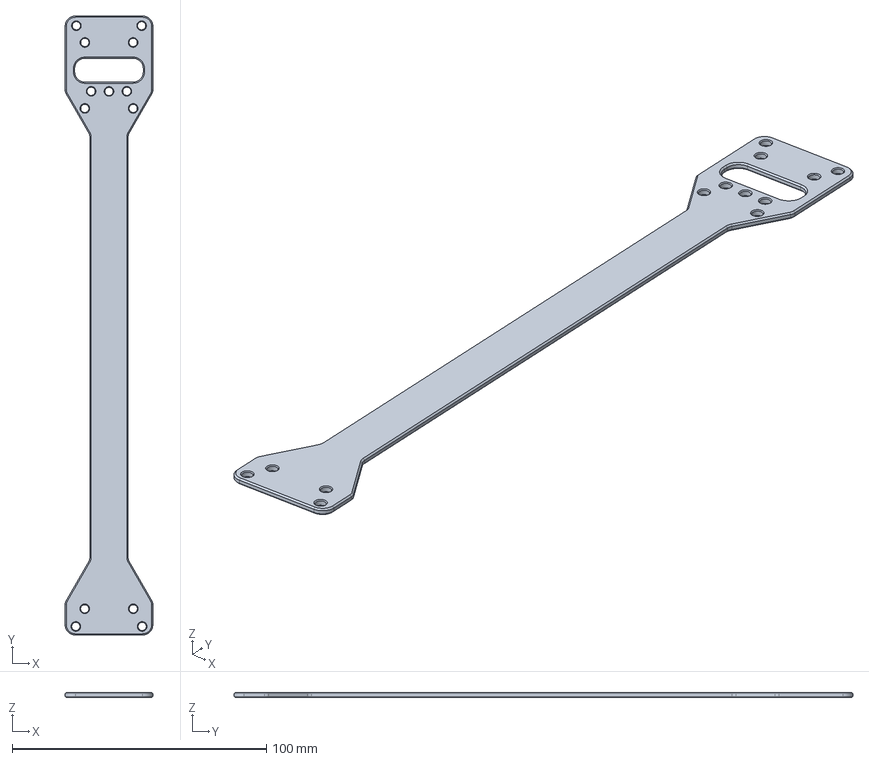
[picture p29: CAD file, 2026-11-13]
cad/chassis/top_brace_speedrun/top_brace_T410R_speedrun.step
34.5 x 243.3 x 2.00 mm
