kleinnconrad/prototyping.rc.speedrun/cad/fan_mount.stl

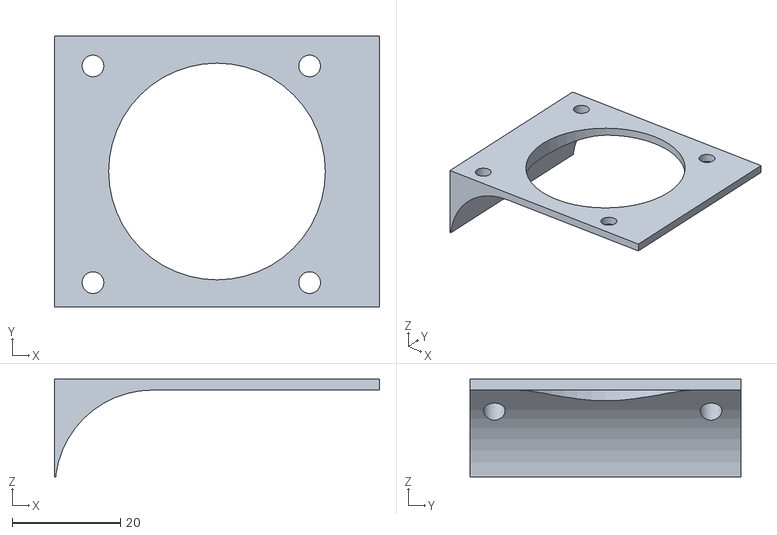
[picture p30: CAD file, 2026-11-10]
cad/fan_mount.stl
60.0 x 50.0 x 18.0
