kleinnconrad/prototyping.rc.speedrun/cad/shock_tower/shock_tower_rear_T410R_speedrun.step

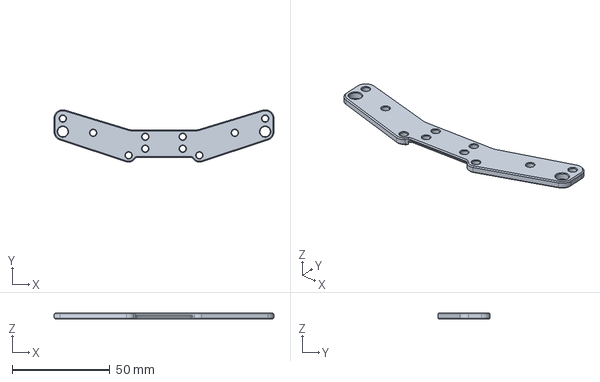
[picture p31: CAD file, 2026-11-13]
cad/shock_tower/shock_tower_rear_T410R_speedrun.step
112.3 x 26.7 x 3.00 mm
