kleinnconrad/prototyping.rc.speedrun/cad/stock_parts/diff/spool_T410R.step

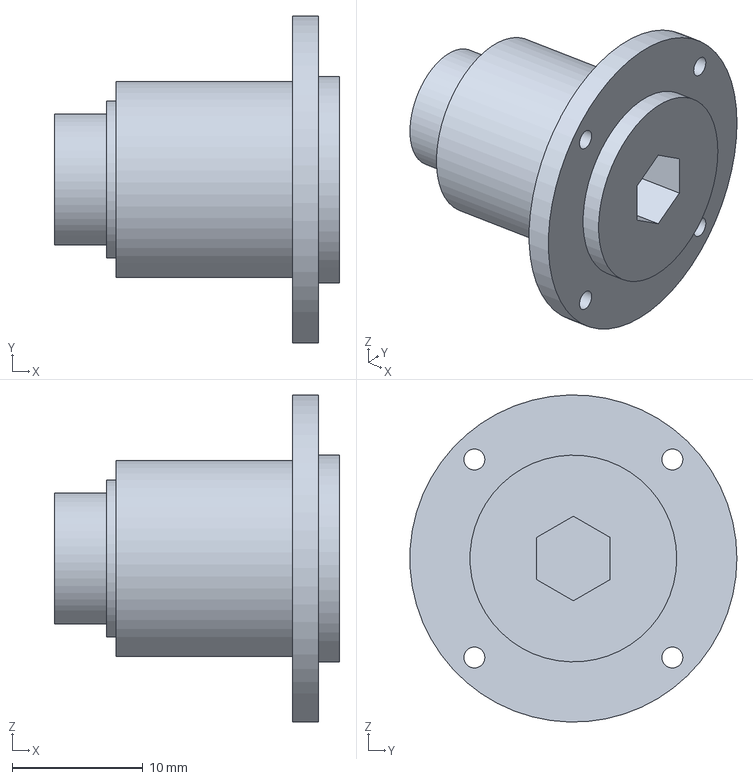
[picture p32: CAD file, 2026-11-14]
cad/stock_parts/diff/spool_T410R.step
21.8 x 25.0 x 25.0 mm
