kleinnconrad/prototyping.rc.speedrun/cad/stock_parts/diff_outdrive/diff_outdrive_T410R.step

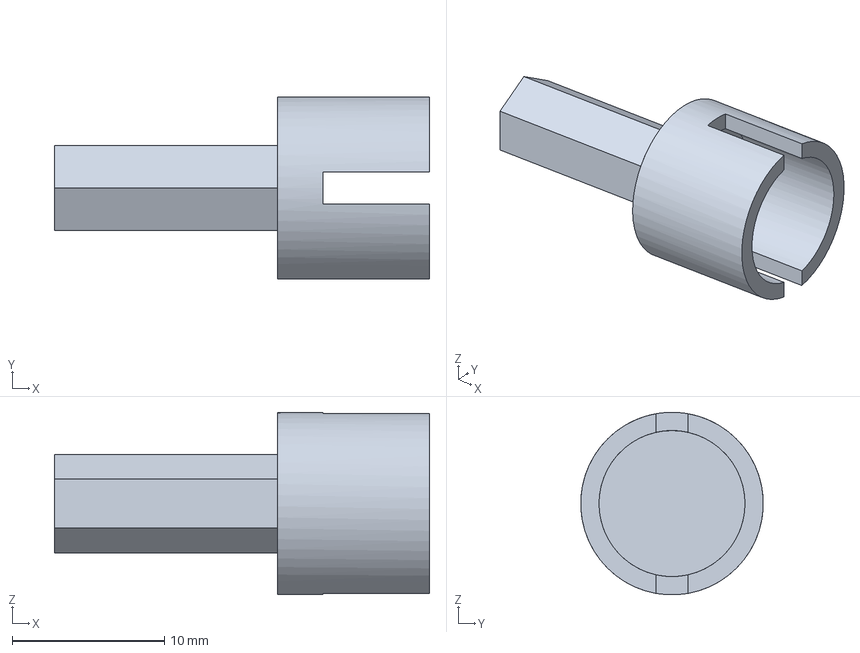
[picture p33: CAD file, 2026-11-14]
cad/stock_parts/diff_outdrive/diff_outdrive_T410R.step
24.6 x 12.0 x 12.0 mm
