kleinnconrad/prototyping.rc.speedrun/cad/stock_parts/driveshaft/cup_joint_T410R.step

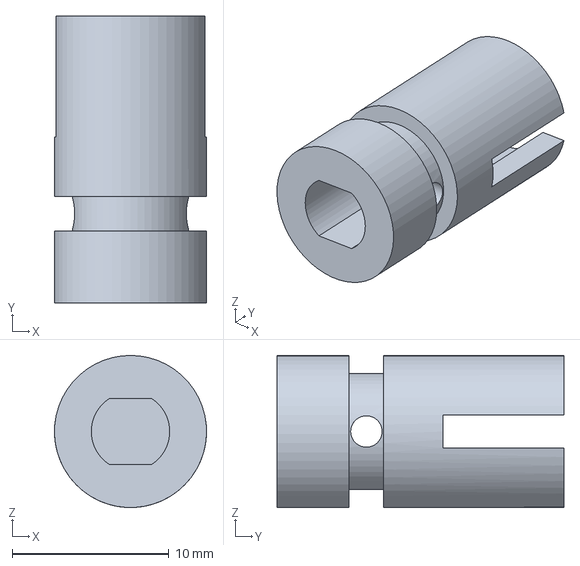
[picture p34: CAD file, 2026-11-14]
cad/stock_parts/driveshaft/cup_joint_T410R.step
9.70 x 18.3 x 9.70 mm
