kleinnconrad/prototyping.rc.speedrun/cad/stock_parts/motor_mount/motor_mount_cap_T410R.step

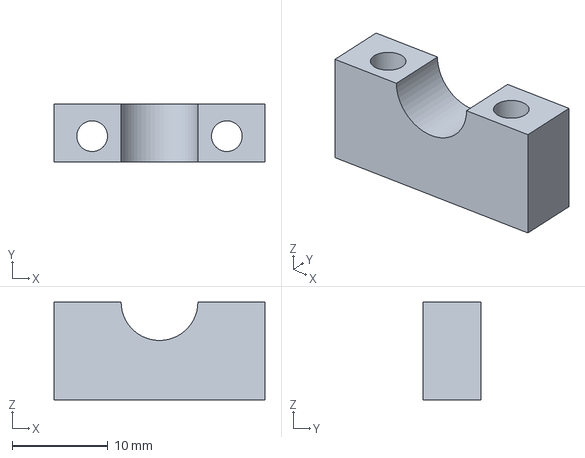
[picture p35: CAD file, 2026-11-14]
cad/stock_parts/motor_mount/motor_mount_cap_T410R.step
22.0 x 6.00 x 10.2 mm
