kleinnconrad/prototyping.rc.speedrun/cad/stock_parts/pivot_block/pivot_block_short_T410R.stl

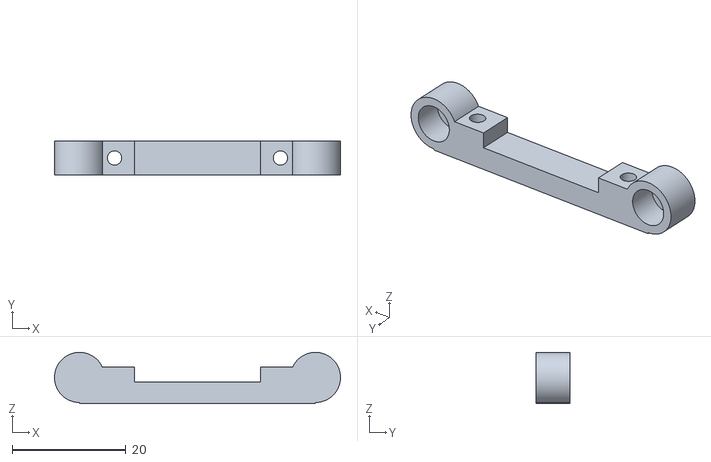
[picture p36: CAD file, 2026-11-13]
cad/stock_parts/pivot_block/pivot_block_short_T410R.stl
50.2 x 5.94 x 9.00
