kleinnconrad/prototyping.rc.speedrun/cad/stock_parts/rear_drive/pinion_17T_NBA207.step

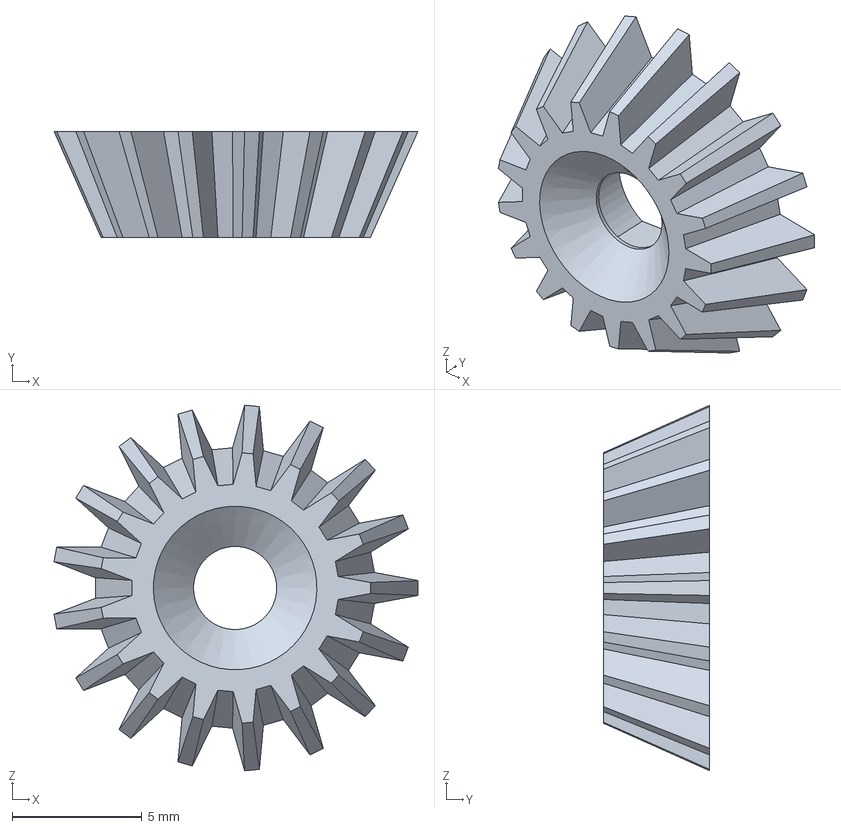
[picture p37: CAD file, 2026-11-14]
cad/stock_parts/rear_drive/pinion_17T_NBA207.step
14.0 x 4.10 x 14.1 mm
