kleinnconrad/prototyping.rc.speedrun/cad/stock_parts/wishbone/wishbone_front_T410R.stl

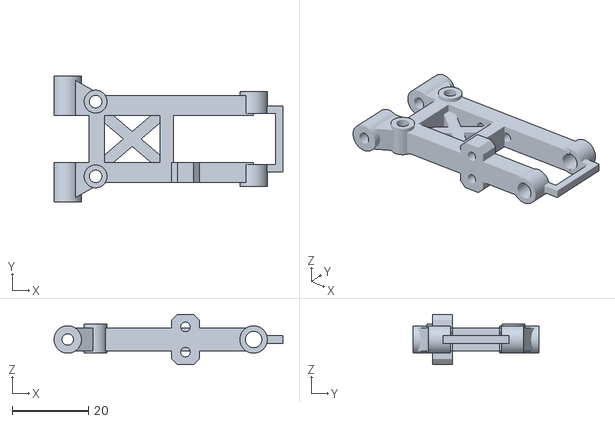
[picture p38: CAD file, 2026-11-14]
cad/stock_parts/wishbone/wishbone_front_T410R.stl
60.0 x 33.0 x 13.2
