kleinnconrad/prototyping.rc.speedrun/specs/mechanics/cad/T410R_DIFFUSOR_V2_2.stl

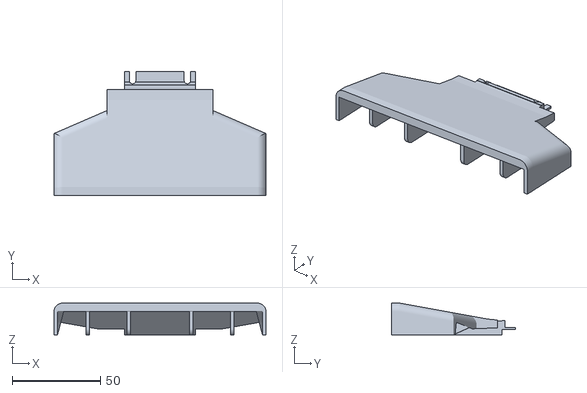
[picture p39: CAD file, 2026-11-03]
specs/mechanics/cad/T410R_DIFFUSOR_V2_2.stl
120.0 x 70.0 x 18.0
