kleinnconrad/prototyping.rc.speedrun/cad/chassis/top_brace_speedrun/testprint_top_brace_speedrun_halfA.stl

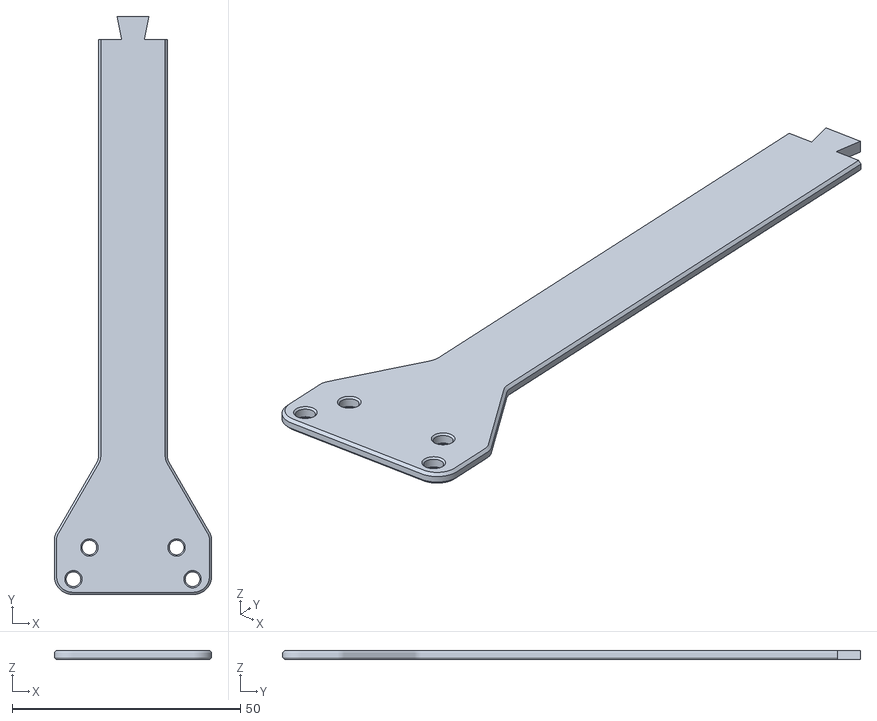
[picture p40: CAD file, 2026-11-13]
cad/chassis/top_brace_speedrun/testprint_top_brace_speedrun_halfA.stl
34.5 x 126.7 x 2.00
