kleinnconrad/prototyping.rc.speedrun/cad/shock_tower/shock_tower_front_T410R_speedrun.step

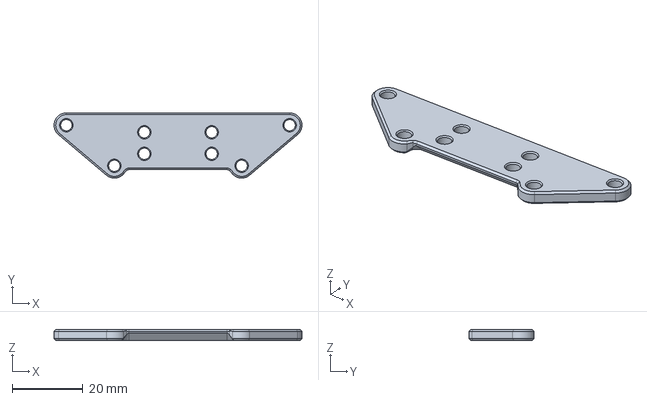
[picture p41: CAD file, 2026-11-13]
cad/shock_tower/shock_tower_front_T410R_speedrun.step
70.3 x 18.5 x 3.00 mm
