kleinnconrad/prototyping.rc.speedrun/cad/stock_parts/diff/shim_spider_gear.stl

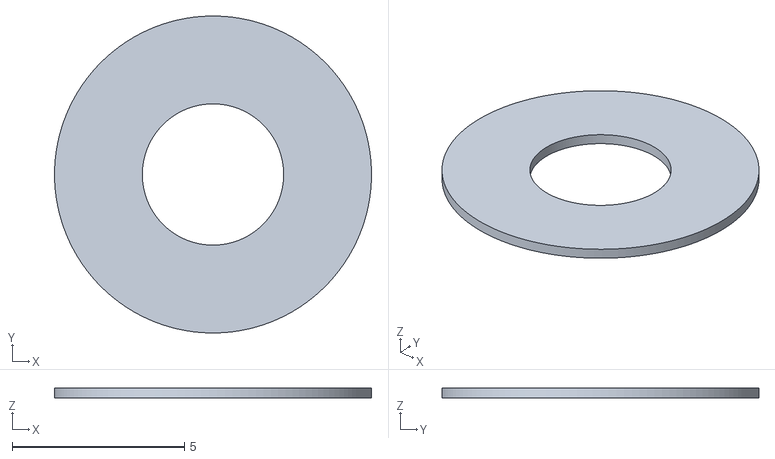
[picture p42: CAD file, 2026-11-14]
cad/stock_parts/diff/shim_spider_gear.stl
9.20 x 9.20 x 0.3
