kleinnconrad/prototyping.rc.speedrun/cad/stock_parts/driveshaft/driveshaft_T410R.step

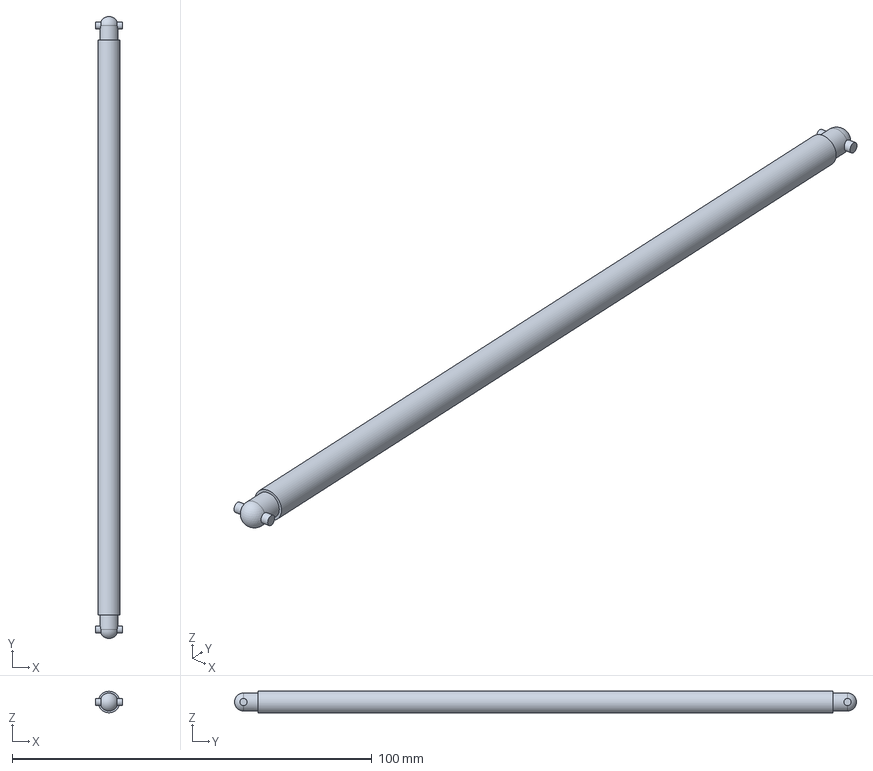
[picture p43: CAD file, 2026-11-14]
cad/stock_parts/driveshaft/driveshaft_T410R.step
7.60 x 173.0 x 5.99 mm
