kleinnconrad/prototyping.rc.speedrun/cad/stock_parts/motor_mount/motor_mount_T410R.step

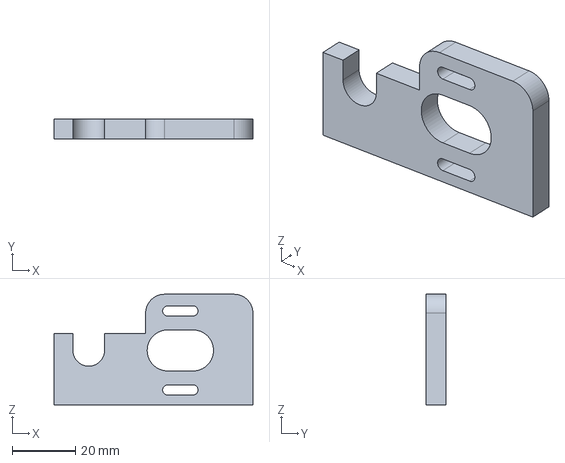
[picture p44: CAD file, 2026-11-14]
cad/stock_parts/motor_mount/motor_mount_T410R.step
63.0 x 6.20 x 35.0 mm
