kleinnconrad/prototyping.rc.speedrun/cad/stock_parts/pivot_block/pivot_block_long_T410R.step

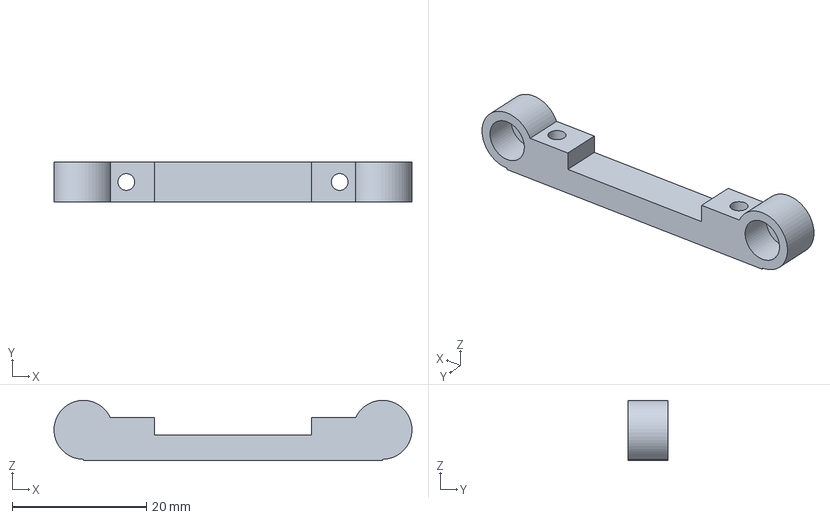
[picture p45: CAD file, 2026-11-13]
cad/stock_parts/pivot_block/pivot_block_long_T410R.step
53.4 x 5.94 x 9.00 mm
