kleinnconrad/prototyping.rc.speedrun/cad/stock_parts/rear_drive/spur_gear_72T_T410R.step

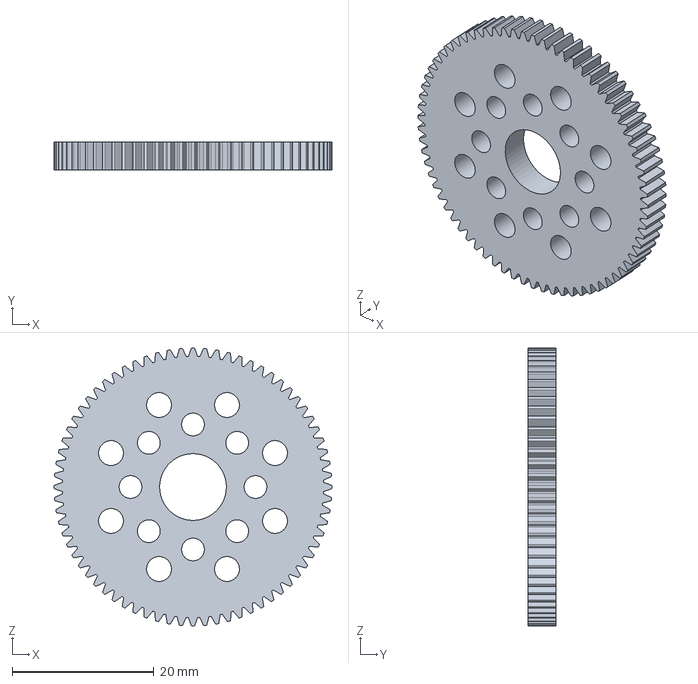
[picture p46: CAD file, 2026-11-14]
cad/stock_parts/rear_drive/spur_gear_72T_T410R.step
39.2 x 4.00 x 39.2 mm
