kleinnconrad/prototyping.rc.speedrun/cad/stock_parts/wishbone/hinge_pin_3x42_NHA423.stl

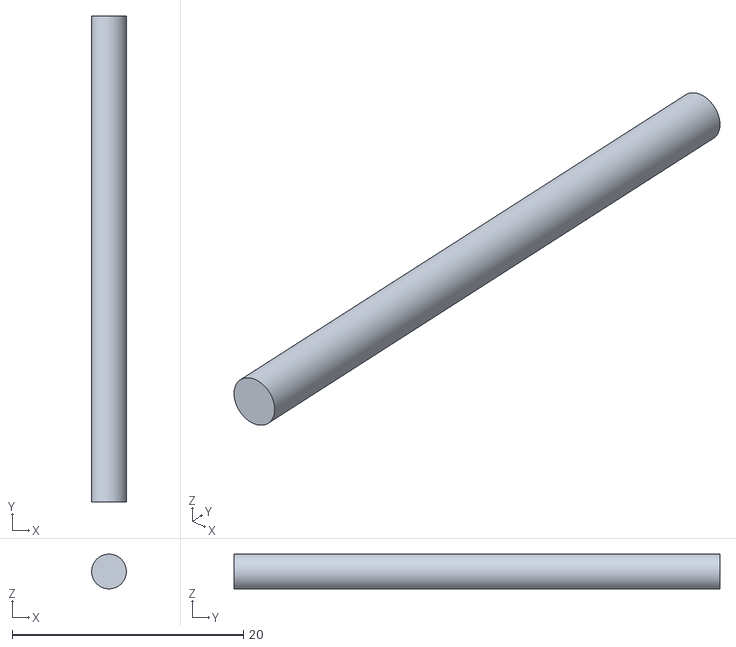
[picture p47: CAD file, 2026-11-14]
cad/stock_parts/wishbone/hinge_pin_3x42_NHA423.stl
3.00 x 42.0 x 3.00
