kleinnconrad/prototyping.rc.speedrun/cad/bulkhead/bulkhead_upper_T410R.step

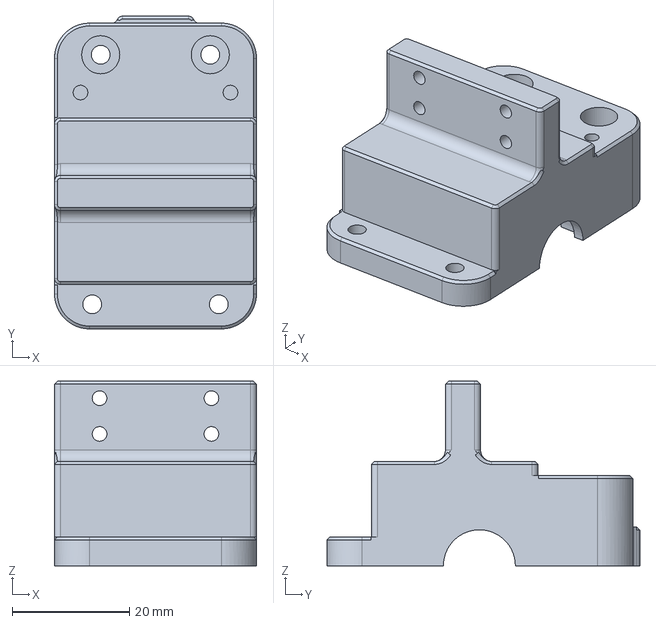
[picture p48: CAD file, 2026-11-13]
cad/bulkhead/bulkhead_upper_T410R.step
34.5 x 53.4 x 31.5 mm
