kleinnconrad/prototyping.rc.speedrun/cad/chassis/top_brace_speedrun/testprint_top_brace_speedrun_halfB.stl

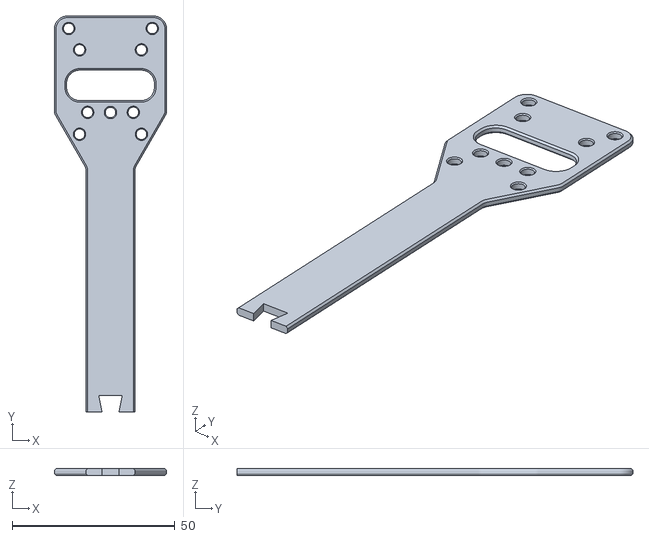
[picture p49: CAD file, 2026-11-13]
cad/chassis/top_brace_speedrun/testprint_top_brace_speedrun_halfB.stl
34.5 x 121.7 x 2.00
