kleinnconrad/prototyping.rc.speedrun/cad/stock_parts/diff/cross_pin_T410R.stl

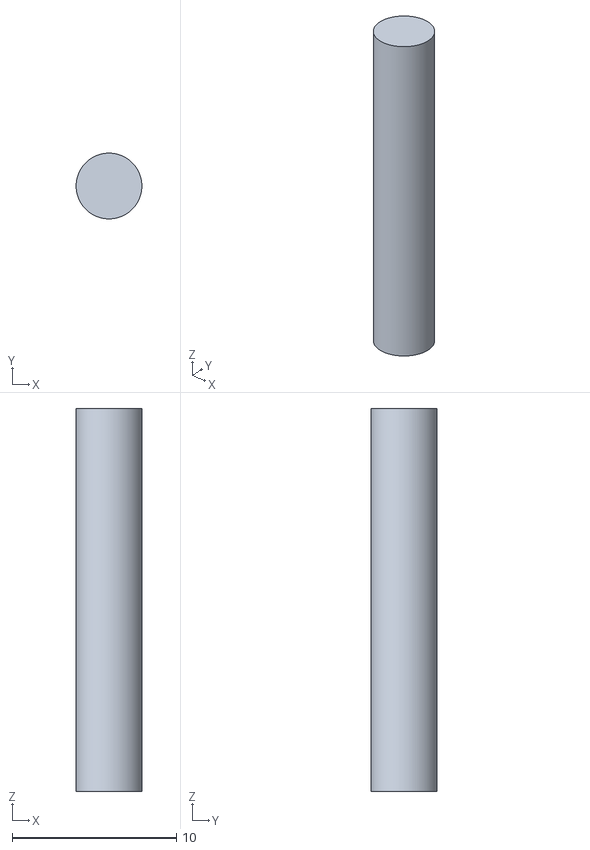
[picture p50: CAD file, 2026-11-14]
cad/stock_parts/diff/cross_pin_T410R.stl
4.00 x 4.00 x 23.3
