kleinnconrad/prototyping.rc.speedrun/cad/stock_parts/rear_drive/retaining_pin_2x7.6_NBA255.step

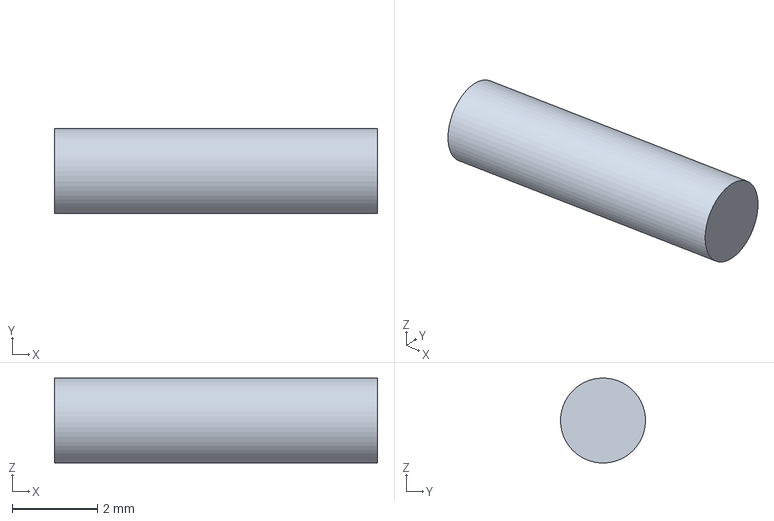
[picture p51: CAD file, 2026-11-14]
cad/stock_parts/rear_drive/retaining_pin_2x7.6_NBA255.step
7.60 x 2.00 x 2.00 mm
