kleinnconrad/prototyping.rc.speedrun/cad/bulkhead/bulkhead_lower_T410R.stl

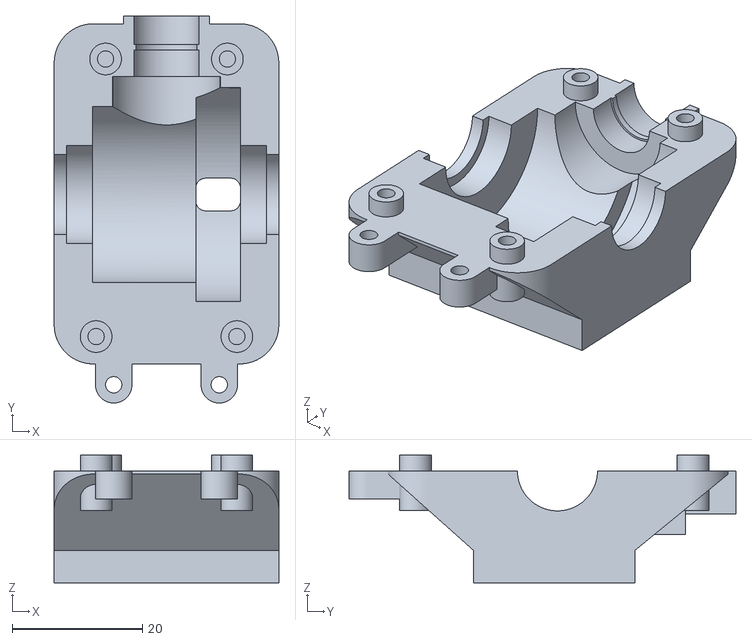
[picture p52: CAD file, 2026-11-12]
cad/bulkhead/bulkhead_lower_T410R.stl
34.5 x 59.4 x 19.6
