kleinnconrad/prototyping.rc.speedrun/cad/stock_parts/diff/ring_gear_42T_T410R.step

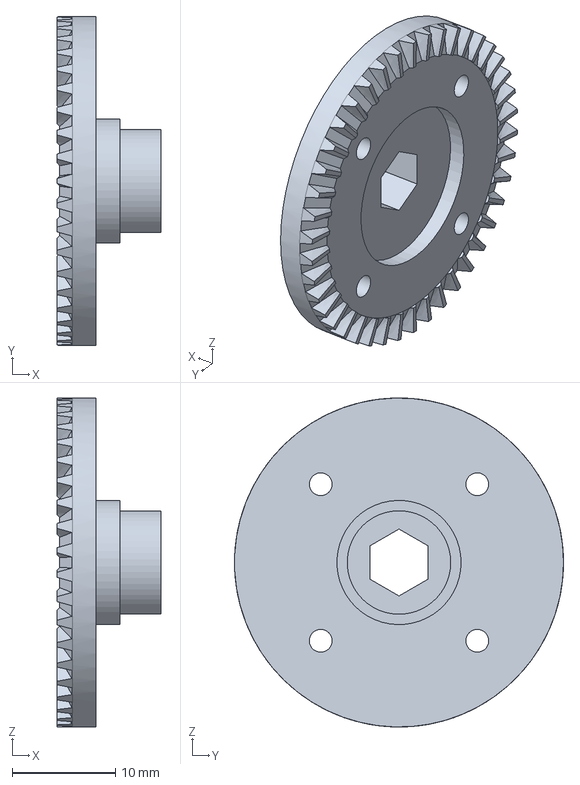
[picture p53: CAD file, 2026-11-14]
cad/stock_parts/diff/ring_gear_42T_T410R.step
10.1 x 31.8 x 31.8 mm
