kleinnconrad/prototyping.rc.speedrun/cad/stock_parts/rear_drive/bearing_5x10x4.step

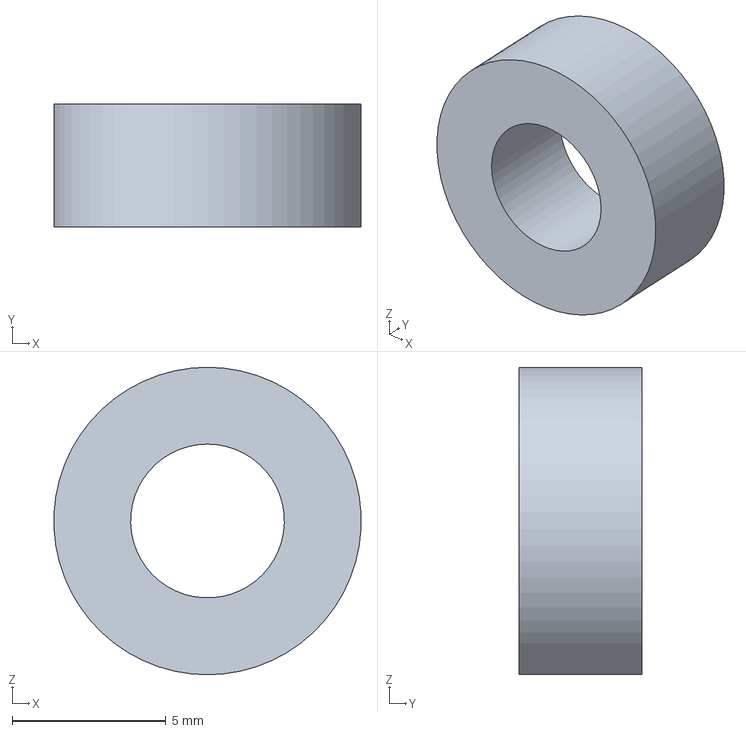
[picture p54: CAD file, 2026-11-14]
cad/stock_parts/rear_drive/bearing_5x10x4.step
9.99 x 4.00 x 10.0 mm
