kleinnconrad/prototyping.rc.speedrun/cad/stock_parts/diff/shim_side_gear.step

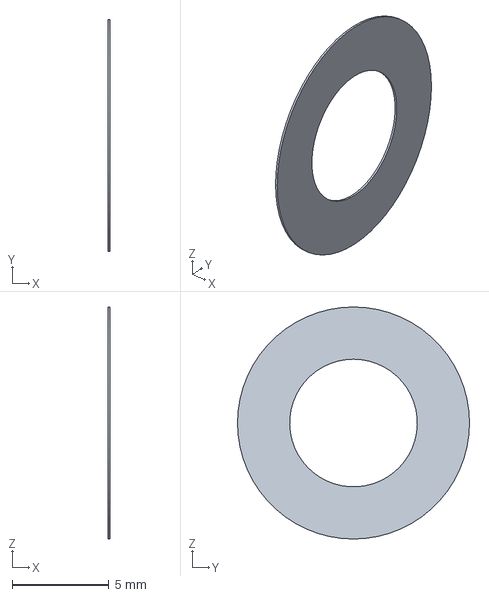
[picture p55: CAD file, 2026-11-14]
cad/stock_parts/diff/shim_side_gear.step
0.1 x 12.0 x 12.0 mm
