kleinnconrad/prototyping.rc.speedrun/cad/stock_parts/rear_drive/rear_pinion_shaft_T410R.step

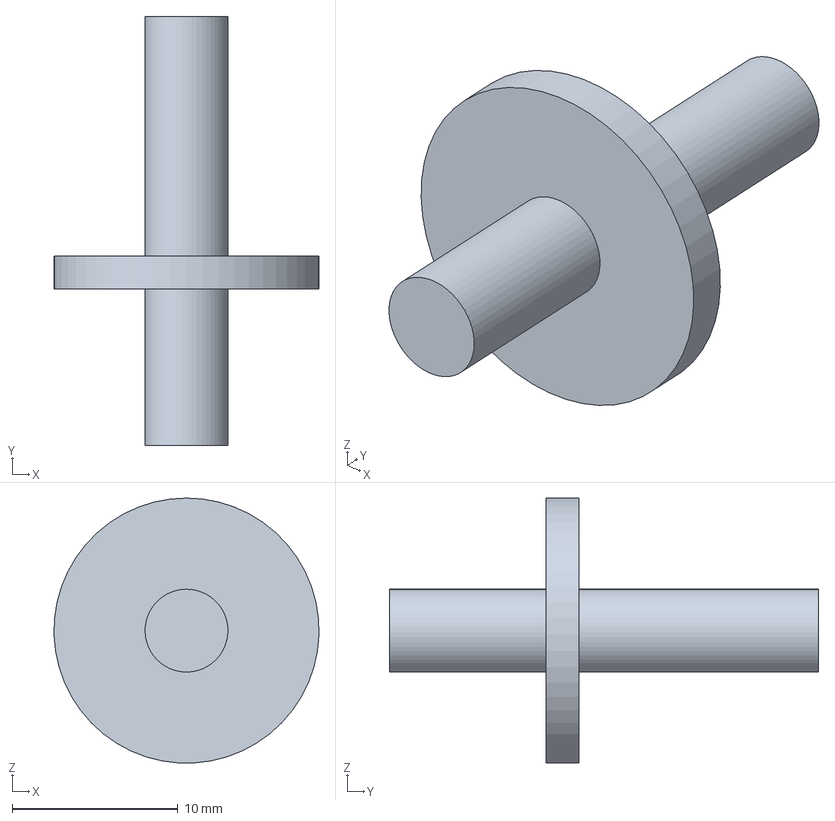
[picture p56: CAD file, 2026-11-14]
cad/stock_parts/rear_drive/rear_pinion_shaft_T410R.step
16.0 x 25.9 x 16.0 mm
