kleinnconrad/prototyping.rc.speedrun/cad/stock_parts/diff/side_gear_14T_T410R.stl

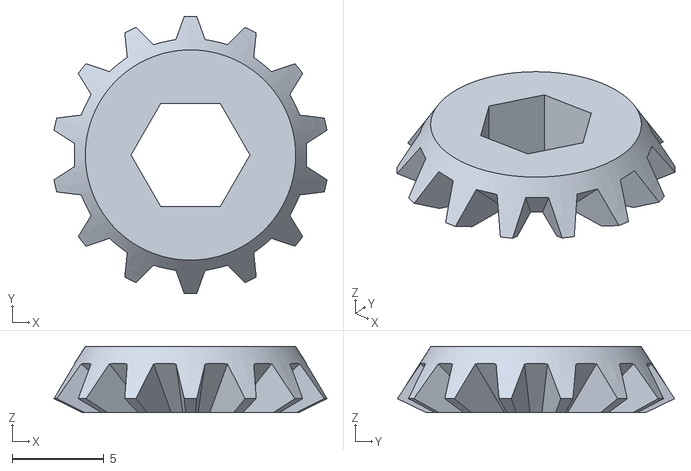
[picture p57: CAD file, 2026-11-14]
cad/stock_parts/diff/side_gear_14T_T410R.stl
14.8 x 15.1 x 3.60
