kleinnconrad/prototyping.rc.speedrun/cad/stock_parts/diff/diff_case_T410R.step

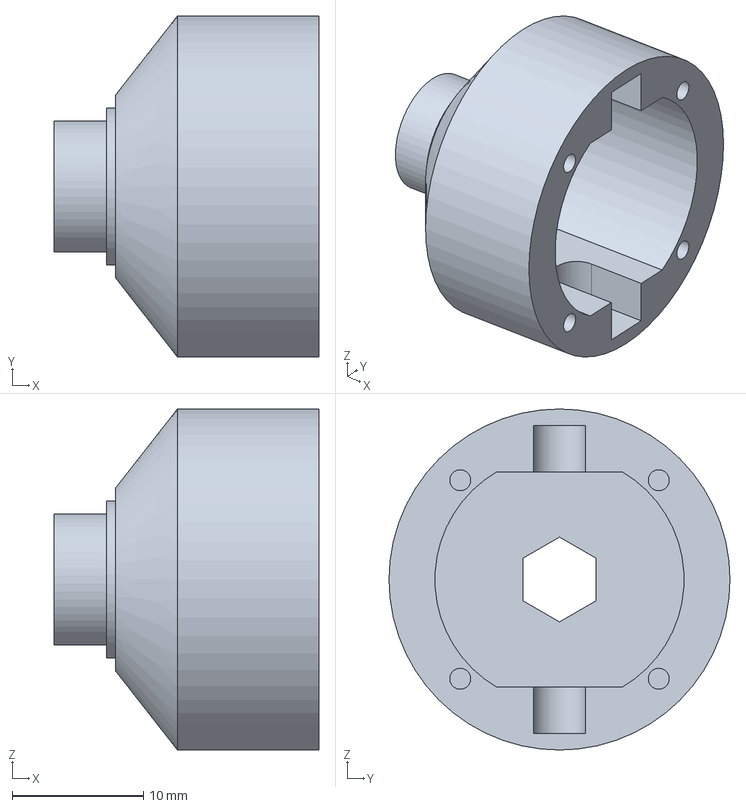
[picture p58: CAD file, 2026-11-14]
cad/stock_parts/diff/diff_case_T410R.step
20.2 x 26.0 x 26.0 mm
