kleinnconrad/prototyping.rc.speedrun/cad/stock_parts/diff/spider_gear_9T_T410R.stl

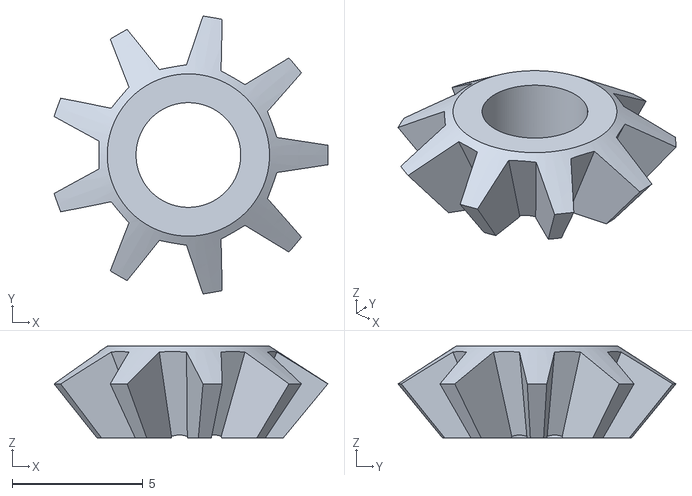
[picture p59: CAD file, 2026-11-14]
cad/stock_parts/diff/spider_gear_9T_T410R.stl
10.5 x 10.6 x 3.50
