kleinnconrad/prototyping.rc.speedrun/cad/stock_parts/diff/bearing_10x15x4_NBA299.stl

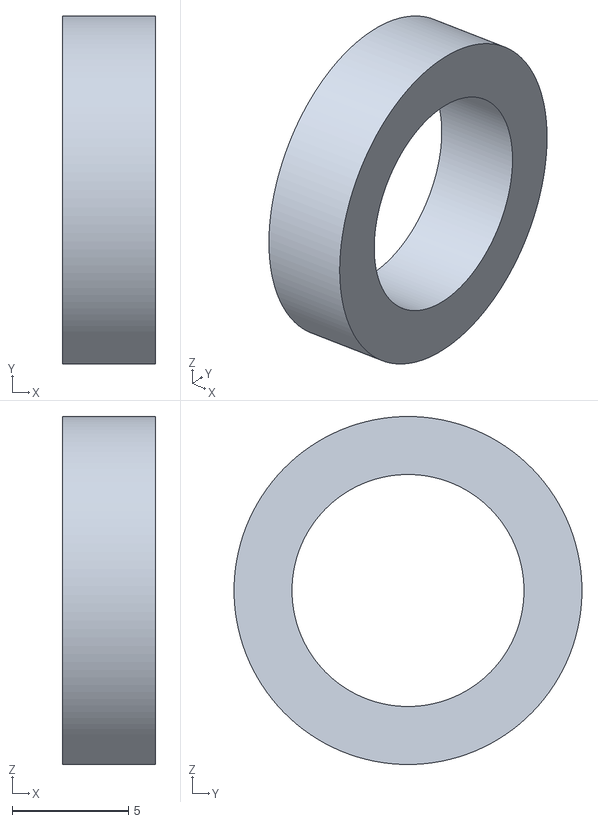
[picture p60: CAD file, 2026-11-14]
cad/stock_parts/diff/bearing_10x15x4_NBA299.stl
4.00 x 15.0 x 15.0
