kleinnconrad/prototyping.rc.speedrun/cad/chassis/chassis_plate/chassis_plate_T410R.scad

// Carten T410R chassis plate (caliper-corrected)
// Generated from photos. Units: mm. Origin: centreline (x=0), rear end edge (y=0). View from TOP side.
// Countersinks are on the BOTTOM face (z=0). Edit parameters below.
thickness = 2.00;
hole_d    = 3.20;   // M3 clearance
csk_d     = 6.20;   // countersink diameter at bottom face (0 = plain holes)
csk_angle = 90.0;   // included angle
$fn = 64;

outline = [[-49.990,56.746],[-49.987,56.641],[-49.979,56.536],[-49.965,56.433],[-49.946,56.329],[-49.922,56.227],[-49.892,56.127],[-49.857,56.028],[-49.818,55.931],[-49.773,55.836],[-49.723,55.744],[-49.668,55.655],[-49.609,55.568],[-49.545,55.485],[-49.478,55.405],[-49.406,55.329],[-49.330,55.256],[-49.251,55.188],[-49.168,55.124],[-49.081,55.064],[-48.992,55.009],[-35.103,46.904],[-35.016,46.852],[-34.931,46.799],[-34.846,46.743],[-34.763,46.687],[-34.681,46.628],[-34.600,46.568],[-34.520,46.506],[-34.442,46.443],[-34.365,46.378],[-34.289,46.312],[-34.214,46.244],[-34.141,46.175],[-34.069,46.104],[-33.999,46.032],[-33.930,45.958],[-33.863,45.883],[-33.797,45.807],[-33.733,45.729],[-33.670,45.650],[-33.609,45.570],[-33.549,45.489],[-33.491,45.406],[-33.435,45.322],[-33.381,45.238],[-33.328,45.152],[-33.277,45.065],[-33.227,44.977],[-33.180,44.888],[-33.134,44.798],[-33.090,44.707],[-33.048,44.616],[-33.008,44.523],[-32.969,44.430],[-32.933,44.336],[-32.898,44.242],[-32.865,44.146],[-32.835,44.050],[-32.806,43.954],[-32.779,43.857],[-32.754,43.759],[-32.731,43.661],[-32.710,43.562],[-32.691,43.463],[-32.673,43.364],[-32.658,43.264],[-32.645,43.164],[-32.634,43.064],[-32.625,42.964],[-32.618,42.863],[-32.613,42.762],[-32.610,42.662],[-32.609,42.561],[-32.609,33.451],[-32.608,33.350],[-32.605,33.248],[-32.600,33.147],[-32.592,33.046],[-32.583,32.945],[-32.572,32.844],[-32.559,32.743],[-32.543,32.643],[-32.526,32.543],[-32.507,32.443],[-32.485,32.344],[-32.462,32.245],[-32.437,32.146],[-32.409,32.049],[-32.380,31.951],[-32.349,31.855],[-32.315,31.759],[-32.280,31.664],[-32.243,31.569],[-32.204,31.475],[-32.163,31.382],[-32.121,31.290],[-32.076,31.199],[-32.030,31.109],[-31.982,31.019],[-31.932,30.931],[-31.880,30.844],[-31.826,30.757],[-31.771,30.672],[-31.714,30.588],[-31.655,30.505],[-31.595,30.423],[-31.533,30.343],[-31.469,30.264],[-31.404,30.186],[-31.338,30.109],[-31.269,30.034],[-31.200,29.960],[-31.128,29.888],[-31.056,29.817],[-30.981,29.748],[-30.906,29.680],[-30.829,29.613],[-30.751,29.549],[-30.672,29.485],[-30.591,29.424],[-30.509,29.364],[-30.426,29.306],[-30.341,29.249],[-24.335,25.303],[-24.251,25.246],[-24.168,25.188],[-24.086,25.128],[-24.005,25.067],[-23.925,25.003],[-23.847,24.938],[-23.770,24.872],[-23.695,24.804],[-23.621,24.735],[-23.548,24.664],[-23.477,24.591],[-23.407,24.518],[-23.339,24.442],[-23.272,24.366],[-23.207,24.288],[-23.143,24.209],[-23.081,24.128],[-23.021,24.047],[-22.962,23.964],[-22.906,23.880],[-22.850,23.795],[-22.797,23.708],[-22.745,23.621],[-22.695,23.533],[-22.647,23.443],[-22.600,23.353],[-22.556,23.262],[-22.513,23.170],[-22.472,23.077],[-22.433,22.983],[-22.396,22.888],[-22.361,22.793],[-22.328,22.697],[-22.296,22.600],[-22.267,22.503],[-22.240,22.405],[-22.214,22.307],[-22.191,22.208],[-22.170,22.109],[-22.150,22.009],[-22.133,21.909],[-22.118,21.809],[-22.104,21.708],[-22.093,21.607],[-22.084,21.506],[-22.077,21.405],[-22.072,21.304],[-22.069,21.202],[-22.068,21.100],[-22.068,3.020],[-22.066,2.919],[-22.061,2.818],[-22.052,2.718],[-22.041,2.618],[-22.026,2.518],[-22.007,2.419],[-21.985,2.320],[-21.960,2.223],[-21.932,2.126],[-21.901,2.030],[-21.866,1.935],[-21.828,1.842],[-21.787,1.750],[-21.743,1.659],[-21.696,1.570],[-21.646,1.482],[-21.594,1.396],[-21.538,1.312],[-21.479,1.230],[-21.418,1.150],[-21.355,1.072],[-21.288,0.996],[-21.219,0.922],[-21.148,0.851],[-21.074,0.782],[-20.998,0.716],[-20.920,0.652],[-20.840,0.591],[-20.758,0.532],[-20.674,0.477],[-20.588,0.424],[-20.500,0.374],[-20.411,0.327],[-20.321,0.283],[-20.228,0.242],[-20.135,0.204],[-20.040,0.170],[-19.944,0.138],[-19.848,0.110],[-19.750,0.085],[-19.652,0.063],[-19.552,0.045],[-19.453,0.030],[-19.353,0.018],[-19.252,0.010],[-19.151,0.004],[-19.051,0.003],[19.051,0.003],[19.151,0.004],[19.252,0.010],[19.353,0.018],[19.453,0.030],[19.552,0.045],[19.652,0.063],[19.750,0.085],[19.848,0.110],[19.944,0.138],[20.040,0.170],[20.135,0.204],[20.228,0.242],[20.321,0.283],[20.411,0.327],[20.500,0.374],[20.588,0.424],[20.674,0.477],[20.758,0.532],[20.840,0.591],[20.920,0.652],[20.998,0.716],[21.074,0.782],[21.148,0.851],[21.219,0.922],[21.288,0.996],[21.355,1.072],[21.418,1.150],[21.479,1.230],[21.538,1.312],[21.594,1.396],[21.646,1.482],[21.696,1.570],[21.743,1.659],[21.787,1.750],[21.828,1.842],[21.866,1.935],[21.901,2.030],[21.932,2.126],[21.960,2.223],[21.985,2.320],[22.007,2.419],[22.026,2.518],[22.041,2.618],[22.052,2.718],[22.061,2.818],[22.066,2.919],[22.068,3.020],[22.068,21.100],[22.069,21.202],[22.072,21.304],[22.077,21.405],[22.084,21.506],[22.093,21.607],[22.104,21.708],[22.118,21.809],[22.133,21.909],[22.150,22.009],[22.170,22.109],[22.191,22.208],[22.214,22.307],[22.240,22.405],[22.267,22.503],[22.296,22.600],[22.328,22.697],[22.361,22.793],[22.396,22.888],[22.433,22.983],[22.472,23.077],[22.513,23.170],[22.556,23.262],[22.600,23.353],[22.647,23.443],[22.695,23.533],[22.745,23.621],[22.797,23.708],[22.850,23.795],[22.906,23.880],[22.962,23.964],[23.021,24.047],[23.081,24.128],[23.143,24.209],[23.207,24.288],[23.272,24.366],[23.339,24.442],[23.407,24.518],[23.477,24.591],[23.548,24.664],[23.621,24.735],[23.695,24.804],[23.770,24.872],[23.847,24.938],[23.925,25.003],[24.005,25.067],[24.086,25.128],[24.168,25.188],[24.251,25.246],[24.335,25.303],[30.341,29.249],[30.426,29.306],[30.509,29.364],[30.591,29.424],[30.672,29.485],[30.751,29.549],[30.829,29.613],[30.906,29.680],[30.981,29.748],[31.056,29.817],[31.128,29.888],[31.200,29.960],[31.269,30.034],[31.338,30.109],[31.404,30.186],[31.469,30.264],[31.533,30.343],[31.595,30.423],[31.655,30.505],[31.714,30.588],[31.771,30.672],[31.826,30.757],[31.880,30.844],[31.932,30.931],[31.982,31.019],[32.030,31.109],[32.076,31.199],[32.121,31.290],[32.163,31.382],[32.204,31.475],[32.243,31.569],[32.280,31.664],[32.315,31.759],[32.349,31.855],[32.380,31.951],[32.409,32.049],[32.437,32.146],[32.462,32.245],[32.485,32.344],[32.507,32.443],[32.526,32.543],[32.543,32.643],[32.559,32.743],[32.572,32.844],[32.583,32.945],[32.592,33.046],[32.600,33.147],[32.605,33.248],[32.608,33.350],[32.609,33.451],[32.609,42.561],[32.610,42.662],[32.613,42.762],[32.618,42.863],[32.625,42.964],[32.634,43.064],[32.645,43.164],[32.658,43.264],[32.673,43.364],[32.691,43.463],[32.710,43.562],[32.731,43.661],[32.754,43.759],[32.779,43.857],[32.806,43.954],[32.835,44.050],[32.865,44.146],[32.898,44.242],[32.933,44.336],[32.969,44.430],[33.008,44.523],[33.048,44.616],[33.090,44.707],[33.134,44.798],[33.180,44.888],[33.227,44.977],[33.277,45.065],[33.328,45.152],[33.381,45.238],[33.435,45.322],[33.491,45.406],[33.549,45.489],[33.609,45.570],[33.670,45.650],[33.733,45.729],[33.797,45.807],[33.863,45.883],[33.930,45.958],[33.999,46.032],[34.069,46.104],[34.141,46.175],[34.214,46.244],[34.289,46.312],[34.365,46.378],[34.442,46.443],[34.520,46.506],[34.600,46.568],[34.681,46.628],[34.763,46.687],[34.846,46.743],[34.931,46.799],[35.016,46.852],[35.103,46.904],[48.992,55.009],[49.081,55.064],[49.168,55.124],[49.251,55.188],[49.330,55.256],[49.406,55.329],[49.478,55.405],[49.545,55.485],[49.609,55.568],[49.668,55.655],[49.723,55.744],[49.773,55.836],[49.818,55.931],[49.857,56.028],[49.892,56.127],[49.922,56.227],[49.946,56.329],[49.965,56.433],[49.979,56.536],[49.987,56.641],[49.990,56.746],[49.990,244.329],[49.989,244.429],[49.985,244.529],[49.979,244.629],[49.971,244.729],[49.960,244.828],[49.947,244.927],[49.932,245.026],[49.914,245.124],[49.894,245.222],[49.872,245.320],[49.847,245.417],[49.821,245.513],[49.791,245.609],[49.760,245.704],[49.726,245.798],[49.690,245.891],[49.652,245.984],[49.612,246.075],[49.570,246.166],[49.525,246.255],[49.478,246.344],[49.430,246.431],[49.379,246.517],[49.326,246.602],[49.271,246.686],[49.214,246.768],[49.156,246.849],[49.095,246.929],[49.033,247.007],[48.968,247.083],[48.902,247.158],[48.834,247.232],[48.765,247.304],[48.694,247.374],[48.621,247.442],[48.546,247.509],[48.470,247.574],[48.392,247.637],[35.040,258.238],[34.961,258.302],[34.883,258.366],[34.806,258.433],[34.731,258.500],[34.656,258.568],[34.582,258.638],[34.509,258.709],[34.438,258.780],[34.367,258.853],[34.298,258.927],[34.230,259.003],[34.163,259.079],[34.097,259.156],[34.032,259.234],[33.969,259.313],[33.907,259.393],[33.846,259.474],[33.787,259.557],[33.728,259.639],[33.671,259.723],[33.615,259.808],[33.561,259.894],[33.508,259.980],[33.456,260.067],[33.406,260.155],[33.357,260.244],[33.309,260.334],[33.263,260.424],[33.218,260.515],[33.175,260.606],[33.133,260.699],[33.092,260.792],[33.053,260.885],[33.016,260.979],[32.980,261.074],[32.945,261.170],[32.912,261.265],[32.880,261.362],[32.850,261.458],[32.821,261.556],[32.794,261.653],[32.768,261.752],[32.744,261.850],[32.721,261.949],[32.700,262.048],[32.681,262.148],[32.663,262.247],[32.646,262.347],[32.632,262.448],[32.618,262.548],[32.606,262.649],[32.596,262.750],[32.588,262.851],[32.581,262.952],[32.575,263.053],[32.571,263.155],[32.569,263.256],[32.568,263.357],[32.568,277.469],[32.567,277.570],[32.564,277.671],[32.559,277.772],[32.552,277.872],[32.543,277.973],[32.532,278.073],[32.518,278.173],[32.503,278.273],[32.486,278.372],[32.467,278.471],[32.446,278.570],[32.423,278.668],[32.398,278.766],[32.371,278.863],[32.342,278.960],[32.311,279.056],[32.278,279.151],[32.244,279.246],[32.207,279.340],[32.169,279.433],[32.128,279.525],[32.086,279.617],[32.042,279.708],[31.996,279.798],[31.949,279.887],[31.899,279.975],[31.848,280.062],[31.795,280.147],[31.741,280.232],[31.685,280.316],[31.627,280.399],[31.567,280.480],[31.506,280.560],[31.443,280.639],[31.379,280.717],[31.313,280.793],[31.245,280.868],[31.176,280.942],[31.106,281.014],[31.034,281.085],[30.961,281.154],[30.886,281.222],[30.811,281.288],[30.733,281.353],[30.655,281.416],[30.575,281.478],[30.494,281.538],[30.412,281.597],[30.328,281.653],[30.244,281.709],[30.158,281.762],[30.072,281.814],[29.984,281.864],[29.895,281.912],[29.806,281.958],[29.715,282.003],[29.624,282.045],[29.532,282.086],[29.439,282.125],[29.345,282.162],[29.250,282.198],[29.155,282.231],[29.059,282.262],[28.963,282.292],[28.866,282.320],[28.768,282.345],[28.670,282.369],[28.572,282.391],[28.473,282.410],[28.374,282.428],[28.274,282.444],[28.174,282.457],[28.074,282.469],[27.974,282.479],[27.873,282.487],[27.772,282.492],[26.131,282.568],[26.030,282.574],[25.929,282.582],[25.829,282.591],[25.729,282.603],[25.629,282.617],[25.529,282.633],[25.430,282.650],[25.331,282.670],[25.232,282.692],[25.134,282.715],[25.037,282.741],[24.940,282.769],[24.843,282.798],[24.748,282.830],[24.652,282.863],[24.558,282.898],[24.464,282.935],[24.371,282.974],[24.279,283.015],[24.188,283.058],[24.097,283.102],[24.007,283.149],[23.919,283.197],[23.831,283.247],[23.745,283.299],[23.659,283.352],[23.575,283.407],[23.491,283.464],[23.409,283.522],[23.328,283.582],[23.248,283.644],[23.170,283.707],[23.092,283.772],[23.016,283.839],[22.942,283.906],[22.869,283.976],[22.797,284.047],[22.726,284.119],[22.657,284.192],[22.590,284.268],[22.524,284.344],[22.460,284.422],[22.397,284.500],[22.336,284.581],[22.276,284.662],[22.218,284.745],[22.162,284.828],[22.107,284.913],[22.055,284.999],[22.003,285.086],[21.954,285.174],[21.906,285.263],[21.861,285.353],[21.817,285.443],[21.774,285.535],[21.734,285.628],[21.696,285.721],[21.659,285.815],[21.624,285.909],[21.592,286.005],[21.561,286.101],[21.532,286.198],[21.505,286.295],[21.480,286.392],[21.457,286.491],[21.436,286.589],[21.417,286.688],[21.400,286.788],[21.384,286.887],[21.371,286.987],[21.360,287.088],[21.351,287.188],[21.344,287.289],[21.339,287.389],[21.336,287.490],[21.335,287.591],[21.335,318.058],[21.333,318.160],[21.329,318.262],[21.321,318.363],[21.311,318.465],[21.297,318.566],[21.280,318.666],[21.261,318.766],[21.238,318.866],[21.212,318.965],[21.184,319.063],[21.153,319.160],[21.118,319.256],[21.081,319.351],[21.041,319.444],[20.998,319.537],[20.953,319.628],[20.905,319.718],[20.854,319.806],[20.801,319.893],[20.744,319.979],[20.686,320.062],[20.625,320.144],[20.562,320.224],[20.496,320.302],[20.428,320.377],[20.357,320.451],[20.285,320.523],[20.210,320.593],[20.134,320.660],[20.055,320.725],[19.975,320.788],[19.892,320.848],[19.808,320.905],[19.723,320.961],[19.635,321.013],[19.546,321.063],[19.456,321.110],[19.364,321.155],[19.271,321.197],[19.177,321.236],[19.082,321.272],[18.985,321.305],[18.888,321.336],[18.790,321.363],[3.343,325.449],[3.246,325.473],[3.149,325.496],[3.051,325.517],[2.953,325.535],[2.854,325.552],[2.756,325.567],[2.656,325.580],[2.557,325.591],[2.457,325.600],[2.358,325.607],[2.258,325.612],[2.158,325.615],[2.058,325.616],[-2.058,325.616],[-2.158,325.615],[-2.258,325.612],[-2.358,325.607],[-2.457,325.600],[-2.557,325.591],[-2.656,325.580],[-2.756,325.567],[-2.854,325.552],[-2.953,325.535],[-3.051,325.517],[-3.149,325.496],[-3.246,325.473],[-3.343,325.449],[-18.790,321.363],[-18.888,321.336],[-18.985,321.305],[-19.082,321.272],[-19.177,321.236],[-19.271,321.197],[-19.364,321.155],[-19.456,321.110],[-19.546,321.063],[-19.635,321.013],[-19.723,320.961],[-19.808,320.905],[-19.892,320.848],[-19.975,320.788],[-20.055,320.725],[-20.134,320.660],[-20.210,320.593],[-20.285,320.523],[-20.357,320.451],[-20.428,320.377],[-20.496,320.302],[-20.562,320.224],[-20.625,320.144],[-20.686,320.062],[-20.744,319.979],[-20.801,319.893],[-20.854,319.806],[-20.905,319.718],[-20.953,319.628],[-20.998,319.537],[-21.041,319.444],[-21.081,319.351],[-21.118,319.256],[-21.153,319.160],[-21.184,319.063],[-21.212,318.965],[-21.238,318.866],[-21.261,318.766],[-21.280,318.666],[-21.297,318.566],[-21.311,318.465],[-21.321,318.363],[-21.329,318.262],[-21.333,318.160],[-21.335,318.058],[-21.335,287.591],[-21.336,287.490],[-21.339,287.389],[-21.344,287.289],[-21.351,287.188],[-21.360,287.088],[-21.371,286.987],[-21.384,286.887],[-21.400,286.788],[-21.417,286.688],[-21.436,286.589],[-21.457,286.491],[-21.480,286.392],[-21.505,286.295],[-21.532,286.198],[-21.561,286.101],[-21.592,286.005],[-21.624,285.909],[-21.659,285.815],[-21.696,285.721],[-21.734,285.628],[-21.774,285.535],[-21.817,285.443],[-21.861,285.353],[-21.906,285.263],[-21.954,285.174],[-22.003,285.086],[-22.055,284.999],[-22.107,284.913],[-22.162,284.828],[-22.218,284.745],[-22.276,284.662],[-22.336,284.581],[-22.397,284.500],[-22.460,284.422],[-22.524,284.344],[-22.590,284.268],[-22.657,284.192],[-22.726,284.119],[-22.797,284.047],[-22.869,283.976],[-22.942,283.906],[-23.016,283.839],[-23.092,283.772],[-23.170,283.707],[-23.248,283.644],[-23.328,283.582],[-23.409,283.522],[-23.491,283.464],[-23.575,283.407],[-23.659,283.352],[-23.745,283.299],[-23.831,283.247],[-23.919,283.197],[-24.007,283.149],[-24.097,283.102],[-24.188,283.058],[-24.279,283.015],[-24.371,282.974],[-24.464,282.935],[-24.558,282.898],[-24.652,282.863],[-24.748,282.830],[-24.843,282.798],[-24.940,282.769],[-25.037,282.741],[-25.134,282.715],[-25.232,282.692],[-25.331,282.670],[-25.430,282.650],[-25.529,282.633],[-25.629,282.617],[-25.729,282.603],[-25.829,282.591],[-25.929,282.582],[-26.030,282.574],[-26.131,282.568],[-27.772,282.492],[-27.873,282.487],[-27.974,282.479],[-28.074,282.469],[-28.174,282.457],[-28.274,282.444],[-28.374,282.428],[-28.473,282.410],[-28.572,282.391],[-28.670,282.369],[-28.768,282.345],[-28.866,282.320],[-28.963,282.292],[-29.059,282.262],[-29.155,282.231],[-29.250,282.198],[-29.345,282.162],[-29.439,282.125],[-29.532,282.086],[-29.624,282.045],[-29.715,282.003],[-29.806,281.958],[-29.895,281.912],[-29.984,281.864],[-30.072,281.814],[-30.158,281.762],[-30.244,281.709],[-30.328,281.653],[-30.412,281.597],[-30.494,281.538],[-30.575,281.478],[-30.655,281.416],[-30.733,281.353],[-30.811,281.288],[-30.886,281.222],[-30.961,281.154],[-31.034,281.085],[-31.106,281.014],[-31.176,280.942],[-31.245,280.868],[-31.313,280.793],[-31.379,280.717],[-31.443,280.639],[-31.506,280.560],[-31.567,280.480],[-31.627,280.399],[-31.685,280.316],[-31.741,280.232],[-31.795,280.147],[-31.848,280.062],[-31.899,279.975],[-31.949,279.887],[-31.996,279.798],[-32.042,279.708],[-32.086,279.617],[-32.128,279.525],[-32.169,279.433],[-32.207,279.340],[-32.244,279.246],[-32.278,279.151],[-32.311,279.056],[-32.342,278.960],[-32.371,278.863],[-32.398,278.766],[-32.423,278.668],[-32.446,278.570],[-32.467,278.471],[-32.486,278.372],[-32.503,278.273],[-32.518,278.173],[-32.532,278.073],[-32.543,277.973],[-32.552,277.872],[-32.559,277.772],[-32.564,277.671],[-32.567,277.570],[-32.568,277.469],[-32.568,263.357],[-32.569,263.256],[-32.571,263.155],[-32.575,263.053],[-32.581,262.952],[-32.588,262.851],[-32.596,262.750],[-32.606,262.649],[-32.618,262.548],[-32.632,262.448],[-32.646,262.347],[-32.663,262.247],[-32.681,262.148],[-32.700,262.048],[-32.721,261.949],[-32.744,261.850],[-32.768,261.752],[-32.794,261.653],[-32.821,261.556],[-32.850,261.458],[-32.880,261.362],[-32.912,261.265],[-32.945,261.170],[-32.980,261.074],[-33.016,260.979],[-33.053,260.885],[-33.092,260.792],[-33.133,260.699],[-33.175,260.606],[-33.218,260.515],[-33.263,260.424],[-33.309,260.334],[-33.357,260.244],[-33.406,260.155],[-33.456,260.067],[-33.508,259.980],[-33.561,259.894],[-33.615,259.808],[-33.671,259.723],[-33.728,259.639],[-33.787,259.557],[-33.846,259.474],[-33.907,259.393],[-33.969,259.313],[-34.032,259.234],[-34.097,259.156],[-34.163,259.079],[-34.230,259.003],[-34.298,258.927],[-34.367,258.853],[-34.438,258.780],[-34.509,258.709],[-34.582,258.638],[-34.656,258.568],[-34.731,258.500],[-34.806,258.433],[-34.883,258.366],[-34.961,258.302],[-35.040,258.238],[-48.392,247.637],[-48.470,247.574],[-48.546,247.509],[-48.621,247.442],[-48.694,247.374],[-48.765,247.304],[-48.834,247.232],[-48.902,247.158],[-48.968,247.083],[-49.033,247.007],[-49.095,246.929],[-49.156,246.849],[-49.214,246.768],[-49.271,246.686],[-49.326,246.602],[-49.379,246.517],[-49.430,246.431],[-49.478,246.344],[-49.525,246.255],[-49.570,246.166],[-49.612,246.075],[-49.652,245.984],[-49.690,245.891],[-49.726,245.798],[-49.760,245.704],[-49.791,245.609],[-49.821,245.513],[-49.847,245.417],[-49.872,245.320],[-49.894,245.222],[-49.914,245.124],[-49.932,245.026],[-49.947,244.927],[-49.960,244.828],[-49.971,244.729],[-49.979,244.629],[-49.985,244.529],[-49.989,244.429],[-49.990,244.329]];

cutout_window = [[37.058,65.627],[37.158,65.629],[37.258,65.634],[37.358,65.642],[37.458,65.654],[37.557,65.669],[37.656,65.687],[37.753,65.709],[37.851,65.734],[37.947,65.762],[38.042,65.793],[38.136,65.827],[38.229,65.865],[38.321,65.906],[38.411,65.949],[38.500,65.996],[38.587,66.046],[38.672,66.098],[38.756,66.154],[38.837,66.212],[38.917,66.273],[38.995,66.336],[39.070,66.402],[39.144,66.470],[39.214,66.541],[39.283,66.615],[39.349,66.690],[39.412,66.768],[39.473,66.847],[39.531,66.929],[39.587,67.013],[39.639,67.098],[39.689,67.185],[39.735,67.274],[39.779,67.364],[39.820,67.456],[39.857,67.549],[39.892,67.643],[39.923,67.738],[39.951,67.834],[39.976,67.931],[39.998,68.029],[40.016,68.128],[40.031,68.227],[40.043,68.327],[40.051,68.427],[40.056,68.527],[40.058,68.627],[40.058,115.899],[40.056,115.999],[40.051,116.100],[40.043,116.199],[40.031,116.299],[40.016,116.398],[39.998,116.497],[39.976,116.595],[39.951,116.692],[39.923,116.788],[39.892,116.883],[39.857,116.977],[39.820,117.070],[39.779,117.162],[39.735,117.252],[39.689,117.341],[39.639,117.428],[39.587,117.513],[39.531,117.597],[39.473,117.679],[39.412,117.758],[39.349,117.836],[39.283,117.912],[39.214,117.985],[39.144,118.056],[39.070,118.124],[38.995,118.190],[38.917,118.254],[38.837,118.314],[38.756,118.372],[38.672,118.428],[38.587,118.480],[38.500,118.530],[38.411,118.577],[38.321,118.620],[38.229,118.661],[38.136,118.699],[38.042,118.733],[37.947,118.764],[37.851,118.793],[37.753,118.817],[37.656,118.839],[37.557,118.857],[37.458,118.872],[37.358,118.884],[37.258,118.892],[37.158,118.897],[37.058,118.899],[19.586,118.899],[19.486,118.897],[19.386,118.892],[19.286,118.884],[19.186,118.872],[19.087,118.857],[18.989,118.839],[18.891,118.817],[18.794,118.793],[18.697,118.764],[18.602,118.733],[18.508,118.699],[18.415,118.661],[18.323,118.620],[18.233,118.577],[18.144,118.530],[18.057,118.480],[17.972,118.428],[17.888,118.372],[17.807,118.314],[17.727,118.254],[17.649,118.190],[17.574,118.124],[17.501,118.056],[17.430,117.985],[17.361,117.912],[17.295,117.836],[17.232,117.758],[17.171,117.679],[17.113,117.597],[17.057,117.513],[17.005,117.428],[16.955,117.341],[16.909,117.252],[16.865,117.162],[16.824,117.070],[16.787,116.977],[16.752,116.883],[16.721,116.788],[16.693,116.692],[16.668,116.595],[16.646,116.497],[16.628,116.398],[16.613,116.299],[16.601,116.199],[16.593,116.100],[16.588,115.999],[16.586,115.899],[16.586,68.627],[16.588,68.527],[16.593,68.427],[16.601,68.327],[16.613,68.227],[16.628,68.128],[16.646,68.029],[16.668,67.931],[16.693,67.834],[16.721,67.738],[16.752,67.643],[16.787,67.549],[16.824,67.456],[16.865,67.364],[16.909,67.274],[16.955,67.185],[17.005,67.098],[17.057,67.013],[17.113,66.929],[17.171,66.847],[17.232,66.768],[17.295,66.690],[17.361,66.615],[17.430,66.541],[17.501,66.470],[17.574,66.402],[17.649,66.336],[17.727,66.273],[17.807,66.212],[17.888,66.154],[17.972,66.098],[18.057,66.046],[18.144,65.996],[18.233,65.949],[18.323,65.906],[18.415,65.865],[18.508,65.827],[18.602,65.793],[18.697,65.762],[18.794,65.734],[18.891,65.709],[18.989,65.687],[19.087,65.669],[19.186,65.654],[19.286,65.642],[19.386,65.634],[19.486,65.629],[19.586,65.627]];
cutout_slot = [[9.208,50.284],[9.309,50.287],[9.411,50.294],[9.511,50.307],[9.611,50.325],[9.709,50.348],[9.807,50.376],[9.903,50.409],[9.997,50.446],[10.089,50.489],[10.179,50.535],[10.266,50.587],[10.351,50.643],[10.432,50.703],[10.511,50.767],[10.586,50.835],[10.658,50.906],[10.726,50.981],[10.790,51.060],[10.850,51.142],[10.905,51.226],[10.957,51.314],[11.004,51.403],[11.046,51.495],[11.084,51.590],[11.116,51.685],[11.144,51.783],[11.167,51.882],[11.185,51.981],[11.198,52.082],[11.206,52.183],[11.208,52.284],[11.208,54.975],[11.206,55.076],[11.198,55.177],[11.185,55.277],[11.167,55.377],[11.144,55.476],[11.116,55.573],[11.084,55.669],[11.046,55.763],[11.004,55.855],[10.957,55.945],[10.905,56.033],[10.850,56.117],[10.790,56.199],[10.726,56.277],[10.658,56.353],[10.586,56.424],[10.511,56.492],[10.432,56.556],[10.351,56.616],[10.266,56.672],[10.179,56.723],[10.089,56.770],[9.997,56.813],[9.903,56.850],[9.807,56.883],[9.709,56.911],[9.611,56.934],[9.511,56.952],[9.411,56.964],[9.309,56.972],[9.208,56.975],[-9.138,56.975],[-9.239,56.972],[-9.340,56.964],[-9.441,56.952],[-9.540,56.934],[-9.639,56.911],[-9.737,56.883],[-9.832,56.850],[-9.927,56.813],[-10.019,56.770],[-10.108,56.723],[-10.196,56.672],[-10.280,56.616],[-10.362,56.556],[-10.441,56.492],[-10.516,56.424],[-10.587,56.353],[-10.655,56.277],[-10.719,56.199],[-10.779,56.117],[-10.835,56.033],[-10.887,55.945],[-10.933,55.855],[-10.976,55.763],[-11.013,55.669],[-11.046,55.573],[-11.074,55.476],[-11.097,55.377],[-11.115,55.277],[-11.128,55.177],[-11.135,55.076],[-11.138,54.975],[-11.138,52.284],[-11.135,52.183],[-11.128,52.082],[-11.115,51.981],[-11.097,51.882],[-11.074,51.783],[-11.046,51.685],[-11.013,51.590],[-10.976,51.495],[-10.933,51.403],[-10.887,51.314],[-10.835,51.226],[-10.779,51.142],[-10.719,51.060],[-10.655,50.981],[-10.587,50.906],[-10.516,50.835],[-10.441,50.767],[-10.362,50.703],[-10.280,50.643],[-10.196,50.587],[-10.108,50.535],[-10.019,50.489],[-9.927,50.446],[-9.832,50.409],[-9.737,50.376],[-9.639,50.348],[-9.540,50.325],[-9.441,50.307],[-9.340,50.294],[-9.239,50.287],[-9.138,50.284]];

holes = [ // [x, y]  id
  [15.911, 5.016]  // H01,
  [-15.911, 5.016]  // H02,
  [-14.077, 11.419]  // H03,
  [14.077, 11.419]  // H04,
  [-14.091, 31.642]  // H05,
  [14.091, 31.642]  // H06,
  [14.586, 44.411]  // H07,
  [-14.586, 44.411]  // H08,
  [45.333, 62.475]  // H09,
  [-0.002, 62.489]  // H10,
  [-42.597, 72.312]  // H11,
  [-22.556, 72.366]  // H12,
  [-4.512, 101.394]  // H13,
  [-42.506, 114.966]  // H14,
  [-22.465, 115.076]  // H15,
  [-4.459, 142.827]  // H16,
  [7.979, 174.149]  // H17,
  [-42.459, 175.641]  // H18,
  [-22.435, 175.663]  // H19,
  [-4.500, 183.049]  // H20,
  [7.998, 199.153]  // H21,
  [-22.516, 218.107]  // H22,
  [-42.575, 218.131]  // H23,
  [-21.696, 242.693]  // H24,
  [21.696, 242.693]  // H25,
  [-14.554, 267.260]  // H26,
  [14.554, 267.260]  // H27,
  [-14.073, 277.259]  // H28,
  [14.073, 277.259]  // H29,
  [-14.058, 297.447]  // H30,
  [14.058, 297.447]  // H31,
  [-14.542, 306.476]  // H32,
  [14.542, 306.476]  // H33,
  [16.677, 317.982]  // H34,
  [-16.677, 317.982]  // H35,
  [-0.114, 321.224]  // H36
];

module plate2d() { difference() { polygon(outline); polygon(cutout_window); polygon(cutout_slot); for (h = holes) translate(h) circle(d = hole_d); } }

module hole3d() {
    translate([0,0,-1]) cylinder(d = hole_d, h = thickness + 2);
    if (csk_d > 0) {
        depth = (csk_d - hole_d) / 2 / tan(csk_angle / 2);
        translate([0,0,-0.01]) cylinder(d1 = csk_d + 0.02, d2 = hole_d, h = depth + 0.01);
    }
}

module plate3d() {
    difference() {
        linear_extrude(height = thickness) difference() { polygon(outline); polygon(cutout_window); polygon(cutout_slot); }
        for (h = holes) translate([h[0], h[1], 0]) hole3d();
    }
}

plate3d();
// For a 2D DXF export use: projection() plate3d();  or  plate2d();
