kleinnconrad/prototyping.rc.speedrun/(list of files, cad)

Other CAD files:
cad/chassis_v2/top_brace/top_brace_T410R_v2.scad
cad/bulkhead/bulkhead_upper_T410R.stl
cad/chassis/top_brace_speedrun/top_brace_T410R_speedrun.dxf
cad/chassis/top_brace_speedrun/top_brace_T410R_speedrun.stl
cad/chassis_v2/chassis_plate_T410R_speedrun_wide.stl
cad/chassis_v2/chassis_plate_T410R_v2.step
cad/chassis_v2/chassis_plate_speedrun_wide_motor10/chassis_plate_T410R_speedrun_wide_motor10.stl
cad/chassis_v2/test_print/testprint_top_brace_v2_halfA.stl
cad/shock_tower/shock_tower_front_T410R_speedrun.dxf
cad/shock_tower/shock_tower_front_T410R_speedrun.stl
cad/shock_tower/shock_tower_rear_T410R_speedrun.dxf
cad/shock_tower/shock_tower_rear_T410R_speedrun.stl
cad/stock_parts/diff/shim_side_gear.stl
cad/stock_parts/diff/spool_T410R.stl
cad/stock_parts/diff_outdrive/diff_outdrive_T410R.stl
cad/stock_parts/driveshaft/cup_joint_T410R.stl
cad/stock_parts/driveshaft/driveshaft_T410R.stl
cad/stock_parts/motor_mount/motor_mount_T410R.stl
cad/stock_parts/motor_mount/motor_mount_cap_T410R.stl
cad/stock_parts/rear_drive/pinion_17T_NBA207.stl
cad/stock_parts/rear_drive/rear_pinion_shaft_T410R.stl
cad/stock_parts/rear_drive/retaining_pin_2x7.6_NBA255.stl
cad/stock_parts/rear_drive/spur_gear_72T_T410R.stl
