kleinnconrad/prototyping.rc.speedrun/cad/chassis/chassis_plate_speedrun_wide_motor10/chassis_plate_T410R_speedrun_wide_motor10_1to1_A4x2_print97.pdf

H02 | H01
H03 | H04
H05 | H06
H08 | H07
H10 | H09
H11 | H12

H13

H14 | H15

H16

H17

H18 | H19

H20

overlap zone (20 mm)

100 mm (x)

100 mm (y)

## Carten T410R speedrun chassis plate (wide)

### with longer motor window (3660 motor) 1:1 template, A4 landscape, page 1 of 2

PRINT AT 97 % (scale of your PDF viewer). The drawing is pre-scaled to 103.09 % (100/97). Check both 100 mm bars with a ruler before use. Printed at 100 % ("actual size") it is 3.1 % too large.

Top view (side without countersinks):
place the part with the countersinks facing down. Red: through holes Ø3.2 mm with centre cross. Dashed circles: countersinks Ø6.2 mm (bottom face). Blue dashed: 20 mm overlap zone. Lay page 2 over page 1 so that both pairs of lines coincide.
Grey dashed: outline of the chassis plate.
Green dashed: end of the previous motor window.
After joining: H11 to H23 = 145.82 mm (centres). | End B (H01 to H04)

H16

H17

H18 | H19

H20

H21

H23 | H22
H24 | H25
H26 | H27
H28 | H29
H30 | H31
H32 | H33
H35 | H34

H36

overlap zone (20 mm)

100 mm (x)

100 mm (y)

## Carten T410R speedrun chassis plate (wide)

### with longer motor window (3660 motor) 1:1 template, A4 landscape, page 2 of 2

PRINT AT 97 % (scale of your PDF viewer). The drawing is pre-scaled to 103.09 % (100/97). Check both 100 mm bars with a ruler before use. Printed at 100 % ("actual size") it is 3.1 % too large.

Top view (side without countersinks):
place the part with the countersinks facing down. Red: through holes Ø3.2 mm with centre cross. Dashed circles: countersinks Ø6.2 mm (bottom face). Blue dashed: 20 mm overlap zone. Lay page 2 over page 1 so that both pairs of lines coincide.
Grey dashed: outline of the chassis plate.
Green dashed: end of the previous motor window. After joining: H11 to H23 = 145.82 mm (centres).

End A (H34 to H36)
