kleinnconrad/prototyping.rc.speedrun/cad/chassis/top_brace/top_brace_T410R_1to1_A4_print97.pdf

## Carten T410R top brace - 1:1 template, A4

PRINT AT 97 % (scale of your PDF viewer).
The drawing is pre-scaled to 103.09 % (100/97).
Printed at 100 % ("actual size") it is 3.1 % too large.
Check both 100 mm bars with a ruler before use.

Red: through holes Ø3.2 mm with centre cross (not countersunk). Scaled to the caliper value of the bar width: 15.09 mm.
Origin: x = 0 centre line, y = 0 end edge with the hexagon cutout.

100 mm (x)

100 mm (y)

B01 | B02
B03 | B04

B05

B06

B07 | | B08
B10 | B09 | B11
B12 | B13
B14 | B15
