kleinnconrad/prototyping.rc.speedrun/photos/cad_chassis_v2_test_print.png

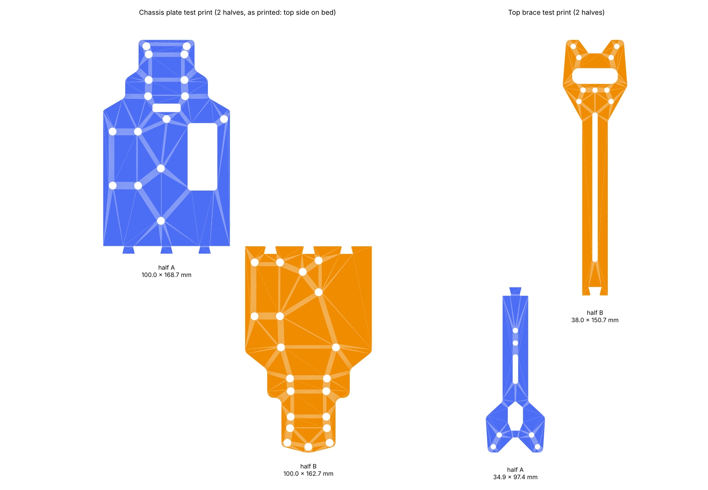
photos/cad_chassis_v2_test_print.png
