kleinnconrad/prototyping.rc.speedrun/cad/bulkhead/bulkhead_lower_measurement_sheet.pdf

7

# Measurement sheet - lower bulkhead - page 1: top and bottom view

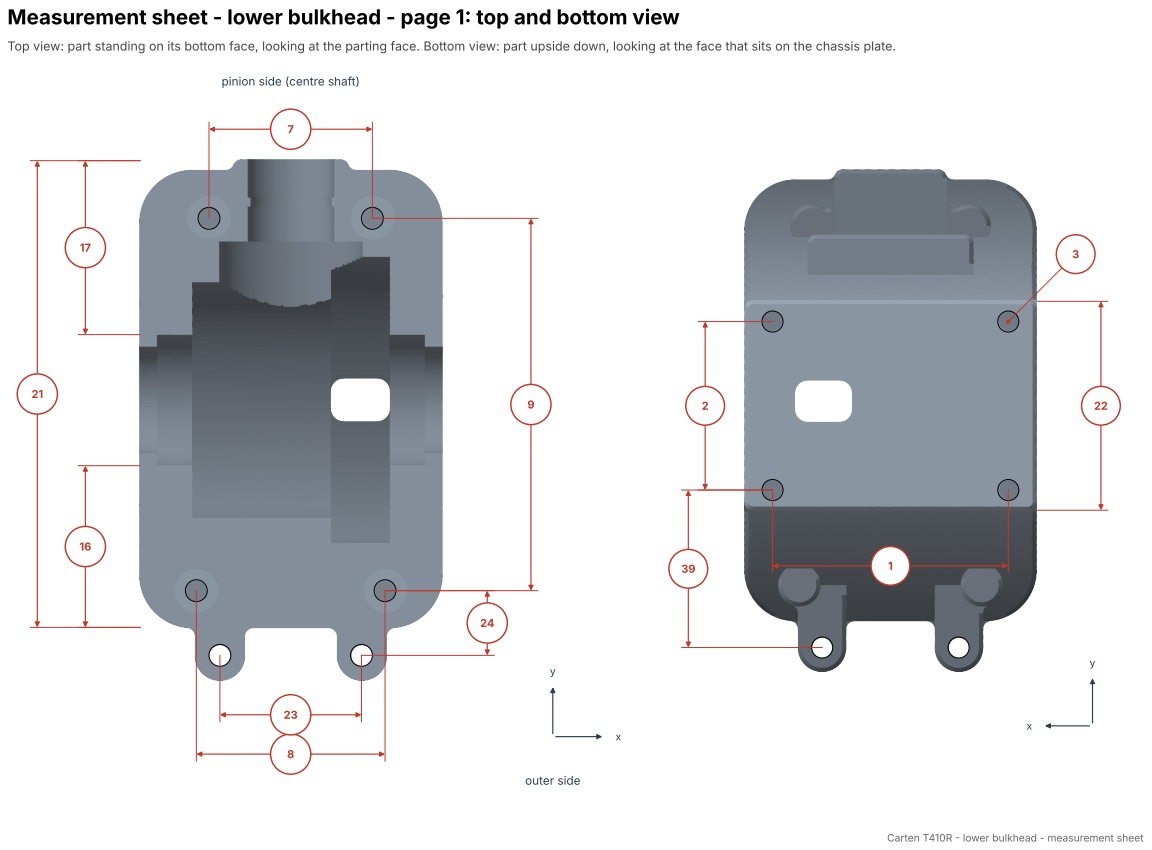
[picture p62: page 1]
outer side

Top view: part standing on its bottom face, looking at the parting face. Bottom view: part upside down, looking at the face that sits on the chassis plate.

pinion side (centre shaft)

Carten T410R - lower bulkhead - measurement sheet

## Section B-B (diff axis, seen from the pinion side)

# Measurement sheet - lower bulkhead - page 2: sections

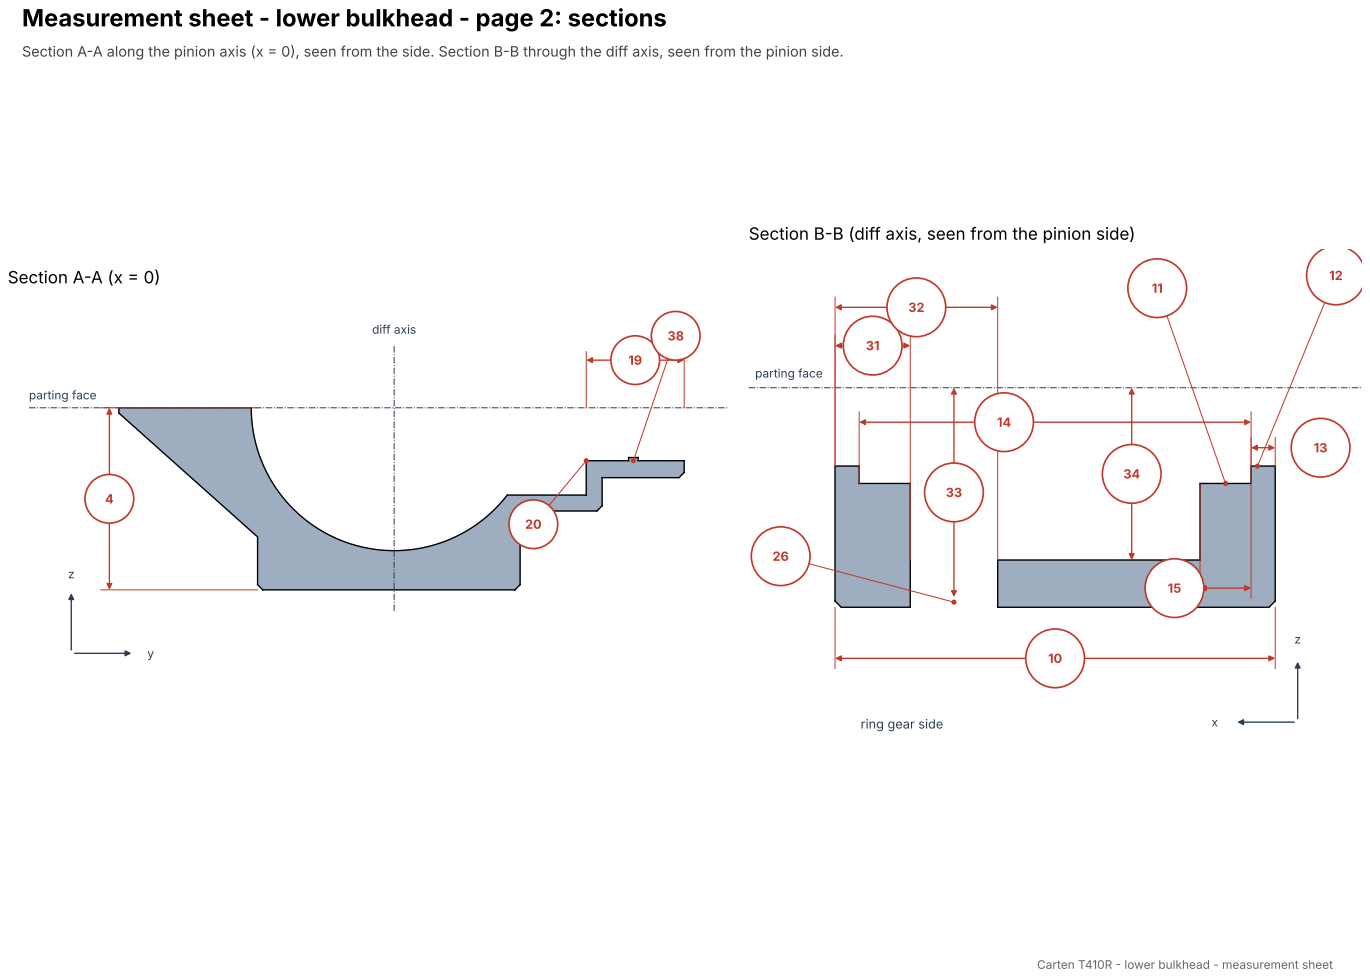
[picture p63: page 2]
diff axis; parting face; Section A-A (x = 0)

Section A-A along the pinion axis (x = 0), seen from the side. Section B-B through the diff axis, seen from the pinion side.

ring gear side

y

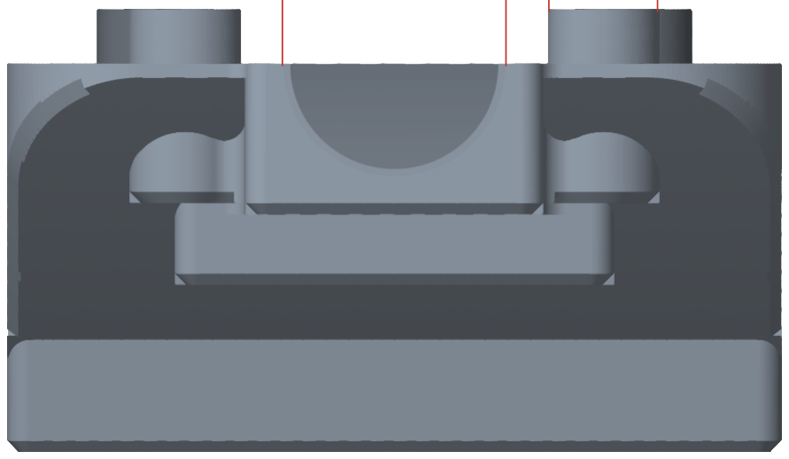
[picture p64: figure]

outer side | pinion side

## Side view

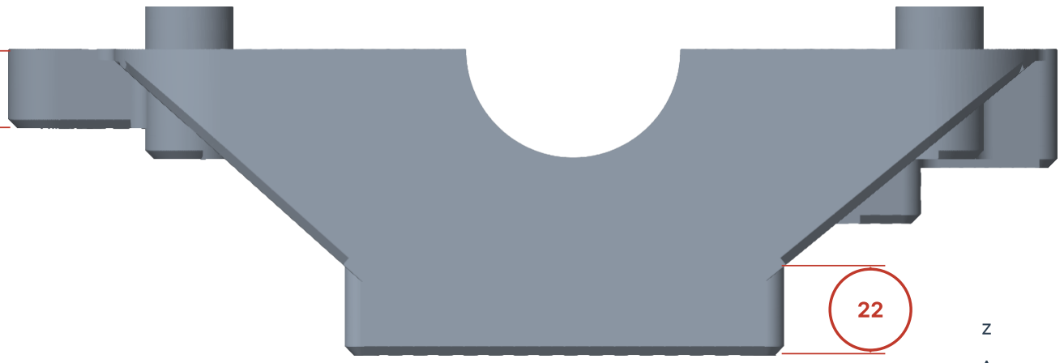
[picture p65: figure]

5

25

x

z

## End view (pinion side)

18 6

# Measurement sheet - lower bulkhead - page 3: side and end view

Side view: looking at a diff bearing wall. End view: looking at the pinion housing.

No. Prio Feature | How to measure | Model | Caliper value
1 | A | Bottom holes: spacing across (x) | inside jaws, far edge to far edge, minus hole diameter | 28.0 | 28.0
2 | A | Bottom holes: spacing along (y) | as no. 1 | 20.0 | 20.0
3 | B | Bottom holes: diameter / depth | inside jaws / depth rod | M3: 2.5 / 8.0 | 3.2 / 6.25
4 | A | Height: bottom face to parting face | part on a flat surface, depth rod | 17.2 | 17.2
5 | A | Height: bottom face to top of the bosses | as no. 4 | 19.62 | 19.62
6 | B | Top bosses: outer diameter | outside jaws | 4.86 | 4.86
7 | A | Top boss holes: spacing across, pinion side (M3x10) | as no. 1 | 18.7 | 18.7
8 | A | Top boss holes: spacing across, outer side (M3x8) | as no. 1 | 21.6 | 21.6
9 | A | Top boss holes: spacing along (y) | as no. 1 | 42.6 | 42.6
10 | B | Width over the outer faces of the diff bearing walls | outside jaws | 34.48 | 34.2
11 | A | Diff bearing seat: width of the half bore at the parting face | inside jaws | 15.0 (fit) | 15.6
12 | A | Diff bearing lip: opening diameter | inside jaws at the outer face | 12.28 | 12.28
13 | A | Diff bearing lip: thickness | outside jaws or depth rod | 1.89 | 1.89
14 | A | Spacing of the inner faces of the two lips | inside jaws across the cavity | 30.7 | 30.7
15 | A | Diff bearing seat: length from the lip inward / inner shoulder | depth rod | 4.0 / none | 4.0 / none
16 | A | Outer end face to the near edge of the diff half bore at the parting face | depth rod | 18.2 (design) | 21.12
17 | A | Pinion housing end face to the near edge of the diff half bore | as no. 16 | 19.6 | 19.6
18 | A | Pinion bearing seat: width of the half bore at the parting face | inside jaws | 10.0 (fit) | 10.5
19 | A | Pinion bearing seat: length (inner end of the seat to housing end face) | depth rod | 9.25 | 9.25
20 | A | Pinion bearing seat: shoulder at the inner end | look | none | none
21 | B | Overall length at the parting face (outer end to pinion housing end) | outside jaws | 53.4 (design)
22 | B | Contact block on the chassis plate: length (y) / height of the end faces | outside jaws | 24.8 / 5.0 | - / 5.0
23 | A | Sway bar holes: spacing | as no. 1 | 16.2 | 16.2
24 | A | Sway bar hole to the outer top boss hole, along (y) | inside jaws, far edges, minus diameters | 7.4 | 7.4
25 | B | Sway bar tabs: thickness | outside jaws | 4.35 | 4.35
26 | B | Floor below the ring gear deepening | - | open 6.85 x 5 | open (test print)
27 | A | Diff: outer diameter of the ring gear | outside jaws on the diff | max. 31.9 | 31.93
28 | A | Diff with both bearings: distance over the outer faces of the bearings | outside jaws on the diff | 30.0 | 30.0
29 | A | Pinion gear (17T): outer diameter | outside jaws | max. 14.1 | 14.1
30 | B | 4 small holes on the outer end face: function, diameter, positions | photo with ruler | not modelled
31 | A | Ring gear deepening: outer face of the diff wall (ring gear side) to the outer end | depth rod | 5.89
32 | A | Ring gear deepening: outer face of the diff wall (ring gear side) to the inner end | depth rod | 12.74
33 | A | Ring gear deepening: depth below the parting face | depth rod | 16.4
34 | B | Floor below the diff case: depth below the parting face | depth rod | 13.5 | test print
35 | A | Diff: largest outer diameter of the diff case (without the ring gear) | outside jaws on the diff | max. 24.0
36 | A | Diff: back face of the ring gear to the outer face of the bearing on that side | depth rod | min. 4.0
37 | A | Ring gear side: seen from the pinion housing, is the deepening on the left? | look | left | left (photo)
38 | A | Pinion seat: rib between the two bearings: width / opening diameter | depth rod / inside jaws | 0.9 / 9.4 | test print
39 | A | Bottom side: sway bar hole to the nearest bottom hole, along (y) | as no. 24 | 18.7
40 | A | Parting face: outer top boss hole to the near edge of the diff half bore, along (y) | depth rod or inside jaws | 14.3
41 | B | Sway bar tabs: top face below the parting face | depth rod | 0

# Measurement sheet - lower bulkhead - page 4: values

Priority A: interfaces. Priority B: shape. Rows without a caliper value are open. Nos. 16 and 17 refer to the edge of the seat (15.6 at the parting face). Values in mm.
