kleinnconrad/prototyping.rc.speedrun/cad/bulkhead/bulkhead_upper_measurement_sheet.pdf

# Measurement sheet - stock upper bulkhead - page 1: interfaces

# Notes

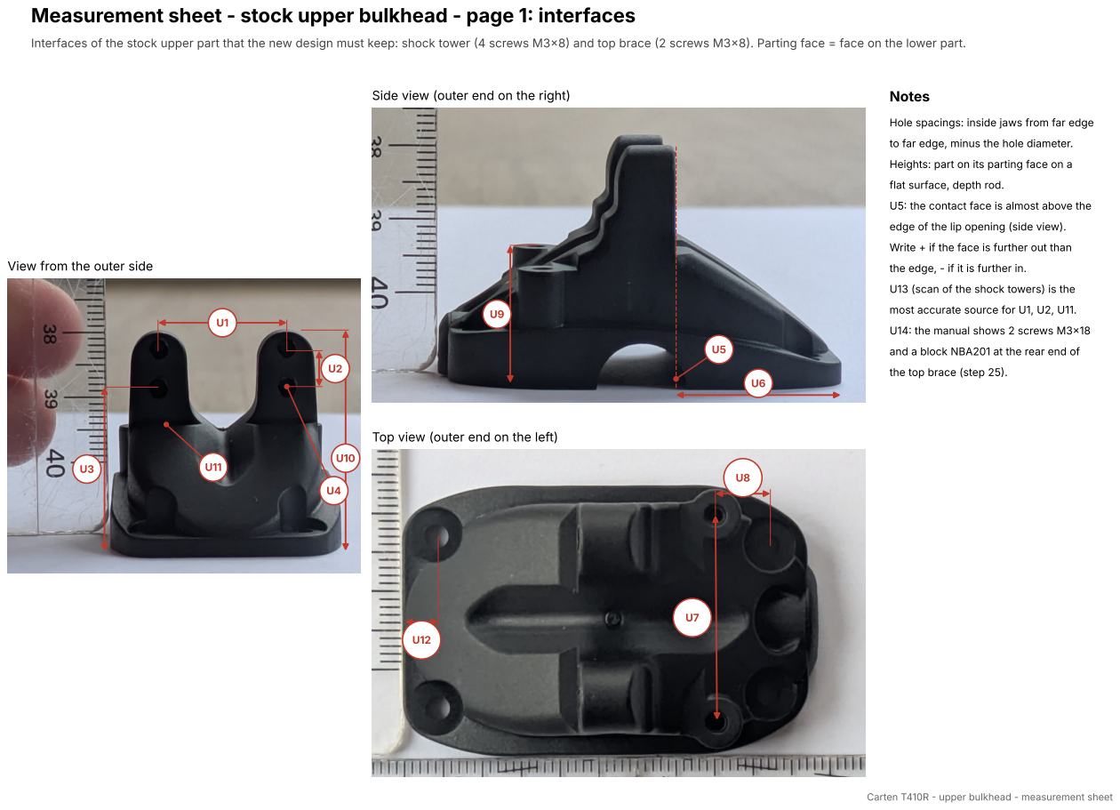
[picture p66: page 1]

Interfaces of the stock upper part that the new design must keep: shock tower (4 screws M3x8) and top brace (2 screws M3x8). Parting face = face on the lower part.

Side view (outer end on the right)

Hole spacings: inside jaws from far edge

to far edge, minus the hole diameter.

Heights: part on its parting face on a

flat surface, depth rod.
U5: the contact face is almost above the

edge of the lip opening (side view).

Write + if the face is further out than

View from the outer side

the edge, - if it is further in.

U13 (scan of the shock towers) is the

most accurate source for U1, U2, U11.
U14: the manual shows 2 screws M3x18

and a block NBA201 at the rear end of
the top brace (step 25).

Top view (outer end on the left)

Carten T410R - upper bulkhead - measurement sheet

No. | Prio | Feature | How to measure | Model | Caliper value
U1 | A | Shock tower holes: spacing across (x) | inside jaws, far edge to far edge, minus hole diameter | 19.1 | 19.1
U2 | A | Shock tower holes: spacing up/down (one ear) | as U1 | 6.1 | 6.1
U3 | A | Lower shock tower holes: height of the centre above the parting face | depth rod to the lower hole edge, plus d/2 | 22.5 | 22.5
U4 | B | Shock tower holes: diameter / length (through) | inside jaws / depth rod | M3: 2.5 / 6.0 | 2.9 / 5.8
U5 | A | Contact face of the shock tower to the outer edge of the lip opening at the parting face (y) | square against the contact face, depth rod | face 0.3 inside
U6 | A | Contact face of the shock tower to the outer end face (y) | square against the face, depth rod | 20.2
U7 | A | Top brace holes: spacing across (x) | as U1 | 25.6 | 25.6
U8 | A | Top brace hole to the screw hole on the pinion side (y) | as U1 | 6.94
U9 | A | Top brace contact face (top of the 2 raised bosses): height above the parting face | part on its parting face, depth rod | 15.4 | 15.4
U10 | B | Ear tops: height above the parting face | as U9 | 31.5 | 31.5
U11 | A | Shock towers (front and rear): lower hole centre to the lowest edge of the tower | on the shock tower, depth rod | 4.7
U12 | B | Outer end face to the centre of the outer screw holes (y) | depth rod, plus d/2 | 4.2
U13 | A | Scan of both shock towers with a ruler on the glass (gives U1, U2 and U11 directly) | flatbed scanner, 600 to 1200 dpi | -
U14 | A | Rear end of the top brace: where do the 2 screws M3x18 with the block NBA201 go? | look (manual step 25) | open

# Measurement sheet - stock upper bulkhead - page 2: values

Priority A: interfaces of the new design. Priority B: shape and checks. Rows without a caliper value are open, their model values are estimates from photos. Values in mm.

Carten T410R - upper bulkhead - measurement sheet
