kleinnconrad/prototyping.rc.speedrun/CHANGELOG.md

# Changelog

## [1.6.0](https://github.com/kleinnconrad/prototyping.rc.speedrun/compare/v1.5.1...v1.6.0) (2026-11-13)

### Features

* add 97 % print templates of the chassis plate and the top brace ([92805ac](https://github.com/kleinnconrad/prototyping.rc.speedrun/commit/92805acbb021fff356e6449c473918fe10149ba1))
* add a script for the chassis plate and top brace templates ([f59b336](https://github.com/kleinnconrad/prototyping.rc.speedrun/commit/f59b3367f96465a289cedd48e350e02c766be021))
* add CAD model and measurement sheet of the lower bulkhead ([f013fd7](https://github.com/kleinnconrad/prototyping.rc.speedrun/commit/f013fd7b20baa4012cbf94fb1337405e9f083b2f))
* add close-ups of both ends to the assembly picture of the speedrun chassis ([11a77bc](https://github.com/kleinnconrad/prototyping.rc.speedrun/commit/11a77bc2a397884546288617ce576b8b8d331e4d))
* add edge chamfers to the speedrun top brace ([3b315dc](https://github.com/kleinnconrad/prototyping.rc.speedrun/commit/3b315dc6abc98c815d7e1944c30317c4dcdbba93))
* add edge chamfers to the speedrun top brace ([34659f5](https://github.com/kleinnconrad/prototyping.rc.speedrun/commit/34659f503fd0f0bc24e488df5ff9e0cbdf75db22))
* add inside radii and bearing relief grooves to the bulkheads ([adfe905](https://github.com/kleinnconrad/prototyping.rc.speedrun/commit/adfe905087dddda84a0ba85b03553684363e4ce2))
* add radii and edge chamfers on the outer side of the bulkheads ([8908443](https://github.com/kleinnconrad/prototyping.rc.speedrun/commit/8908443508bb09605a2ad919ceefa6d0080099d5))
* add the ring gear deepening to the lower bulkhead ([52de8e1](https://github.com/kleinnconrad/prototyping.rc.speedrun/commit/52de8e16748ab547cd401e02af47172a255710d2))
* add the speedrun front shock tower for the speedrun upper bulkhead ([e6deb98](https://github.com/kleinnconrad/prototyping.rc.speedrun/commit/e6deb9818751a1f82500c291478d0bdf71017089))
* add the speedrun rear shock tower for the speedrun upper bulkhead ([db56bc9](https://github.com/kleinnconrad/prototyping.rc.speedrun/commit/db56bc9c1dd5a3c2ac6b20203636637cdfb38764))
* add the speedrun rear shock tower for the speedrun upper bulkhead ([2cbeb30](https://github.com/kleinnconrad/prototyping.rc.speedrun/commit/2cbeb30a2f2e880328b4963da73a8571c4c117e0))
* add the speedrun top brace in the design of the bulkheads ([7728dc6](https://github.com/kleinnconrad/prototyping.rc.speedrun/commit/7728dc6b61bc411697b0e046f85c4081f7fb1655))
* add the upper bulkhead v1 and remove the pinion shoulder ([9c77de2](https://github.com/kleinnconrad/prototyping.rc.speedrun/commit/9c77de29389c486b04e4c3be49b289f5ea315f29))
* close the window at End A of the speedrun top brace ([29b4a08](https://github.com/kleinnconrad/prototyping.rc.speedrun/commit/29b4a0884c5a84f699772a0b49ec7386076d1d3d))
* close the window at End A of the speedrun top brace ([369b53e](https://github.com/kleinnconrad/prototyping.rc.speedrun/commit/369b53e3166991349bfbe4f460cddfe59c9e10c2))
* enter the caliper values of the stock upper bulkhead ([a418731](https://github.com/kleinnconrad/prototyping.rc.speedrun/commit/a4187317a2ee49333fcf76f46a70e8115c84d1af))
* redesign the lower bulkhead to match the upper part ([9b0effc](https://github.com/kleinnconrad/prototyping.rc.speedrun/commit/9b0effc004074bb4493ff93e278760a019e22f2c))
* show the speedrun rear shock tower in view B of the setup drawing ([cffebb7](https://github.com/kleinnconrad/prototyping.rc.speedrun/commit/cffebb7a4452f1d394676444cce1d07cb8711567))
* update the lower bulkhead to version 2 with caliper values ([fe5c312](https://github.com/kleinnconrad/prototyping.rc.speedrun/commit/fe5c312f71c97a8ea49e998db21437363b23a842))

### Bug Fixes

* close the opening below the pinion pocket of the lower bulkhead ([a96e294](https://github.com/kleinnconrad/prototyping.rc.speedrun/commit/a96e29482ce2e1f65ba209dd84bb7ca4b9c1463b))
* enlarge the diff case cavity after the test print ([896fe62](https://github.com/kleinnconrad/prototyping.rc.speedrun/commit/896fe62e18b4f86cce17188c1428f0499e966f4a))
* more space for the pinion in both bulkhead halves ([a4a6f99](https://github.com/kleinnconrad/prototyping.rc.speedrun/commit/a4a6f996e4bc82ee281372cd6eb0e8c004aa9ec2))
* move the camber link holes of the shock towers to the stock position and narrow the shock tower wall ([3c0e91b](https://github.com/kleinnconrad/prototyping.rc.speedrun/commit/3c0e91b8283895c5dd152e10102522ba89c6dacc))
* move the damper holes of the rear shock tower to 2 mm above the upper mounting hole ([340ca28](https://github.com/kleinnconrad/prototyping.rc.speedrun/commit/340ca28c0c1c9a6db028c38042e701c7264626dd))
* open the floor below the ring gear of the lower bulkhead ([1731674](https://github.com/kleinnconrad/prototyping.rc.speedrun/commit/17316745401318120fbcf1c9a0f714d48601c7a6))
* remove the inner shoulder of the diff bearing seats ([012bbbc](https://github.com/kleinnconrad/prototyping.rc.speedrun/commit/012bbbc9ed3a834087cbe86c1869e27692dc8321))
* remove the relief grooves, the inside of the bulkheads stays verified ([09e32b5](https://github.com/kleinnconrad/prototyping.rc.speedrun/commit/09e32b503fd77e6c7568302185c21ad11ba9c7d8))
* run the edge chamfers of the bulkheads through tangent junctions ([5657c28](https://github.com/kleinnconrad/prototyping.rc.speedrun/commit/5657c2896aceed7dd3d482f76b212daea39741cd))
* show the speedrun front shock tower in the setup drawing ([5adc32d](https://github.com/kleinnconrad/prototyping.rc.speedrun/commit/5adc32d55f84d906d875ea0b250e73e063c29c6a))
* show the speedrun front shock tower in the setup drawing ([0a5bb18](https://github.com/kleinnconrad/prototyping.rc.speedrun/commit/0a5bb182490826e6265be3b278aafc41da500e42))
* show the speedrun shock towers in the upper bulkhead preview and mark the front shock tower as verified ([c73b226](https://github.com/kleinnconrad/prototyping.rc.speedrun/commit/c73b226df6b7dc30a34bdec53e1232903877c618))

### Reverts

* restore the setup drawing to its state before the shock tower changes ([9698dbe](https://github.com/kleinnconrad/prototyping.rc.speedrun/commit/9698dbedc05166ba5184946b6937362a9b78d7e5))

## [1.5.1](https://github.com/kleinnconrad/prototyping.rc.speedrun/compare/v1.5.0...v1.5.1) (2026-11-11)

### Bug Fixes

* correct the thickness of the chassis bottom plate to 2.03 mm ([3417141](https://github.com/kleinnconrad/prototyping.rc.speedrun/commit/34171412af4167c0d38b7223c1064af0c570ce3e))

## [1.5.0](https://github.com/kleinnconrad/prototyping.rc.speedrun/compare/v1.4.1...v1.5.0) (2026-11-10)

### Features

* add 1:1 print template of the plate with the longer motor window ([d44ecb1](https://github.com/kleinnconrad/prototyping.rc.speedrun/commit/d44ecb1aa7116d93d0960a273b0b25c47e6e0f31))
* add 1:1 print template of the plate with the longer motor window ([e1f2759](https://github.com/kleinnconrad/prototyping.rc.speedrun/commit/e1f27595f73882e76f3c83f1fa17ad0b08b6590c))
* add 1:1 print template of the wide speedrun chassis plate ([acf4a11](https://github.com/kleinnconrad/prototyping.rc.speedrun/commit/acf4a11e3fbadcfb430e64d1a8a34827677537cd))
* add CAD files of the chassis plate and top brace ([964d7cf](https://github.com/kleinnconrad/prototyping.rc.speedrun/commit/964d7cfd726cbacd8d94e50867c12b6096bc8265))
* add CAD files of the chassis plate and top brace ([0fe7028](https://github.com/kleinnconrad/prototyping.rc.speedrun/commit/0fe702859db786185e3a0e1609f97dda13c5352b))
* add DXF and readme for the longer motor window ([b3b3ab2](https://github.com/kleinnconrad/prototyping.rc.speedrun/commit/b3b3ab23562a5eddf2242999959eb1aba6f6106f))
* add DXF generation script and drawing of the wide chassis plate ([4481ae4](https://github.com/kleinnconrad/prototyping.rc.speedrun/commit/4481ae44680f8b20577516555f9fda9169370e59))
* add the helper scripts of the speedrun chassis plates ([d07a0d2](https://github.com/kleinnconrad/prototyping.rc.speedrun/commit/d07a0d2bd451eb905fa8da7f966e2e4ad7424868))
* add wide speedrun chassis plate CAD files ([6a9ed8d](https://github.com/kleinnconrad/prototyping.rc.speedrun/commit/6a9ed8da44d7e5213030b1aefa8aba103726bd72))
* add wide speedrun chassis plate CAD files ([26ff155](https://github.com/kleinnconrad/prototyping.rc.speedrun/commit/26ff15549bb2e30b6cb567f3b6b5a0145cc8fa53))
* add wide speedrun chassis plate with a longer motor window ([b107634](https://github.com/kleinnconrad/prototyping.rc.speedrun/commit/b107634f39807562bb609f333e26250093475771))
* longer motor window for the wide speedrun chassis plate, print template and CAD scripts ([4e7e313](https://github.com/kleinnconrad/prototyping.rc.speedrun/commit/4e7e3130ac55e10464fc45bda307655f9e6acfbf))

## [1.4.1](https://github.com/kleinnconrad/prototyping.rc.speedrun/compare/v1.4.0...v1.4.1) (2026-11-07)

### Bug Fixes

* clarify the derived values in the setup drawing ([df4521f](https://github.com/kleinnconrad/prototyping.rc.speedrun/commit/df4521f2677dbae680c1fd695c71939d8b486170))
* clarify the derived values in the setup drawing ([54bfed2](https://github.com/kleinnconrad/prototyping.rc.speedrun/commit/54bfed26815c155911c4274d54f492c0fa895389))

## [1.4.0](https://github.com/kleinnconrad/prototyping.rc.speedrun/compare/v1.3.0...v1.4.0) (2026-11-07)

### Features

* add generated technical drawing of the latest setup ([3904aeb](https://github.com/kleinnconrad/prototyping.rc.speedrun/commit/3904aebd378e608bcbc077e9f793e33cf6548360))
* add generated technical drawing of the latest setup ([3abb687](https://github.com/kleinnconrad/prototyping.rc.speedrun/commit/3abb6875ad6a76e43a8e8a7108c56781610a97b1))
* add setup sheet version 4 ([7bf4c90](https://github.com/kleinnconrad/prototyping.rc.speedrun/commit/7bf4c904ba22236cf77a92bda7acba22dcbd1a7e))
* add setup sheet version 4 ([218e111](https://github.com/kleinnconrad/prototyping.rc.speedrun/commit/218e111f996fb2c5585b954c8a6c09301fe6d64f))
* show only the setup drawing on the setup dashboard ([7a83c42](https://github.com/kleinnconrad/prototyping.rc.speedrun/commit/7a83c4214055d41df3a8aedeadbba6e3091cf629))
* show only the setup drawing on the setup dashboard ([8f7469b](https://github.com/kleinnconrad/prototyping.rc.speedrun/commit/8f7469ba573be86c13d710fb559fe718f9d3c509))
* show the setup drawing on the setup dashboard ([86efe89](https://github.com/kleinnconrad/prototyping.rc.speedrun/commit/86efe89183633eeedbf5870bb66e002189b56db7))
* show the setup drawing on the setup dashboard ([3c4a817](https://github.com/kleinnconrad/prototyping.rc.speedrun/commit/3c4a817237e4cf35c16d28ed7af842827eedbe84))

## [1.3.0](https://github.com/kleinnconrad/prototyping.rc.speedrun/compare/v1.2.1...v1.3.0) (2026-10-22)

### Features

* add setup sheet version 3 ([d135781](https://github.com/kleinnconrad/prototyping.rc.speedrun/commit/d135781b8b5bf8addef1f25958ac55cbbc79dda6))
* add setup sheet version 3 ([49869d5](https://github.com/kleinnconrad/prototyping.rc.speedrun/commit/49869d5b17308553108ce03040fd7b0f09854494))

## [1.2.1](https://github.com/kleinnconrad/prototyping.rc.speedrun/compare/v1.2.0...v1.2.1) (2026-10-09)

### Bug Fixes

* resolve contradictions ([331f7a9](https://github.com/kleinnconrad/prototyping.rc.speedrun/commit/331f7a9cf65acb4983dcc34995bf99bb31dffec8))
* resolve contradictions ([f4cb75d](https://github.com/kleinnconrad/prototyping.rc.speedrun/commit/f4cb75d0021629f3d7d0beec92dffe6aa02efdc7))

## [1.2.0](https://github.com/kleinnconrad/prototyping.rc.speedrun/compare/v1.1.1...v1.2.0) (2026-10-02)

### Features

* add setup sheet version 2 ([0fdc470](https://github.com/kleinnconrad/prototyping.rc.speedrun/commit/0fdc470395b102294b9d4869526db2837aa97cb3))

### Bug Fixes

* add pip install pyyaml to update dashboard action ([e72e650](https://github.com/kleinnconrad/prototyping.rc.speedrun/commit/e72e650406f3f71cc41241baf161365e8b7565fb))

## [1.1.1](https://github.com/kleinnconrad/prototyping.rc.speedrun/compare/v1.1.0...v1.1.1) (2026-09-05)

### Bug Fixes

* add ride heigth to the setup_sheet and fix repo structure ([ec82257](https://github.com/kleinnconrad/prototyping.rc.speedrun/commit/ec82257cc457d3932b0909fb01e86b3d5832e2e0))

## [1.1.0](https://github.com/kleinnconrad/prototyping.rc.speedrun/compare/v1.0.1...v1.1.0) (2026-09-03)

### Features

* adding github pages setup_sheet dashboard ([9794f73](https://github.com/kleinnconrad/prototyping.rc.speedrun/commit/9794f73e0ec0930f5f7f317a28bf6329256cfaa6))

## [1.0.1](https://github.com/kleinnconrad/prototyping.rc.speedrun/compare/v1.0.0...v1.0.1) (2026-09-02)

### Bug Fixes

* minor corrections of the specs ([c406340](https://github.com/kleinnconrad/prototyping.rc.speedrun/commit/c406340bf08ea09a567a6e4af21a4bddef42dcd9))

## 1.0.0 (2026-09-01)

initial version
