kleinnconrad/prototyping.rc.speedrun/cad/chassis_v2/top_brace_T410R_v2_1to1_A4.pdf

## Carten T410R top brace v2 - 1:1

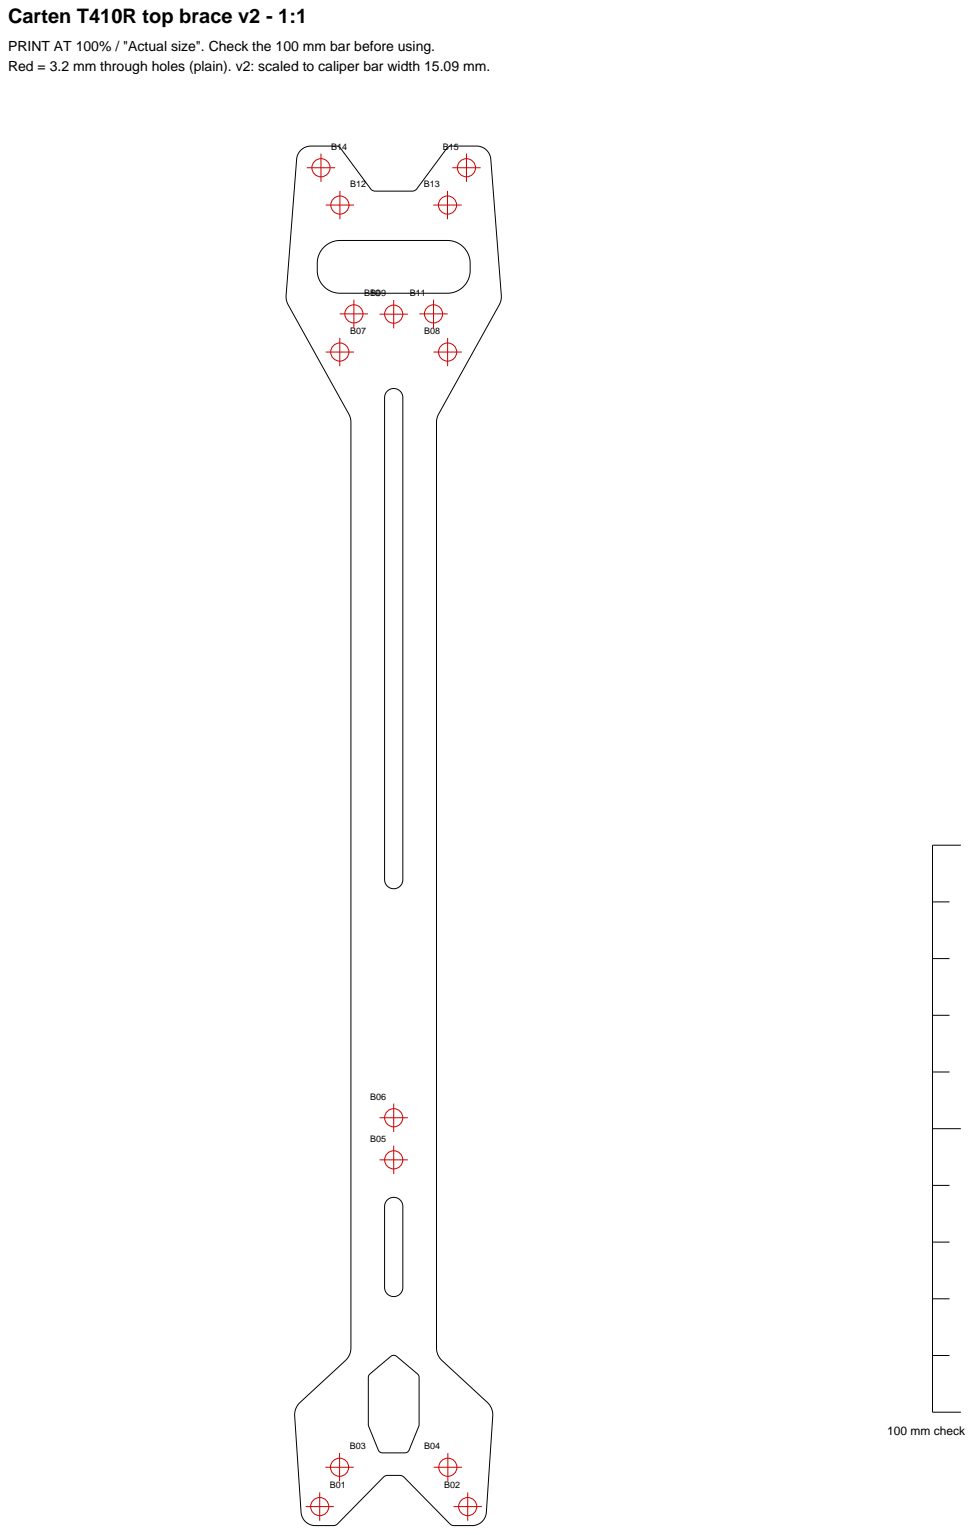
[picture p67: page 1]
100 mm check

PRINT AT 100% / "Actual size". Check the 100 mm bar before using.
Red = 3.2 mm through holes (plain). v2: scaled to caliper bar width 15.09 mm.
