kleinnconrad/prototyping.rc.speedrun/specs/full_spec.yaml

Battery:
  meta:
    brand: Absima
    series: GreenHorn Line V2
    part_number: '4140014'
    type: LiPo (Lithium-Polymer)
  properties:
    electrical_specifications:
      voltage: 11.1V (Nominal voltage)
      cells: 3S
      capacity: 5000 mAh
      energy: 55.5 Wh
      discharge_rate_continuous: 50C
      max_continuous_amp_draw: 250A
    connectors:
      main_power: XT60 (Plug & Play with Hobbywing QuicRun G2 ESC)
      balancer: XH (Standard balancer for the charger)
    physical_specifications:
      case_type: Hardcase (HC) - Hard plastic box
      safety: Absolutely necessary for speedruns to protect against driveshaft/crashes
      weight_g: 370
      dimensions:
        length_mm: 138
        width_mm: 46
        height_mm: 35
Charger:
  meta:
    brand: SkyRC
    model: S100neo
    type: Smart AC/DC Charger
    architecture_fit: optimal. Has XT60 socket built directly into the housing. No
      adapter chaos.
  properties:
    power_specifications:
      input_voltage_ac: 100-240V (Integrated power supply for normal socket)
      input_voltage_dc: 6-30V
      charge_power_max_ac: 100W
      charge_power_max_dc: 200W
      discharge_power_max: 5W (Main port) / 20W (Balance port)
    charging_capabilities:
      supported_chemistries:
      - LiPo
      - LiIon
      - LiFe
      - LiHV
      - NiMH
      - NiCd
      - Pb
      supported_cells_lipo: 1S to 6S
      charge_current_range: 0.1A - 12.0A
      discharge_current_range: 0.1A - 2.0A
      balancer_current_max: 1.0A
    physical_specifications:
      display: Color LCD Screen
      dimensions_mm:
        length: 105
        width: 105
        height: 62
      weight_g: 340
      control_interface: Simple 3-button control
Brushless Combo:
  meta:
    description: Specification of the brushless powertrain for 100 km/h on 3S.
    architecture_status: 'ADR-002: Hobbywing QuicRun WP10BL120 G2 Combo (3660SL 3700KV)
      accepted'
  properties:
    electronic_speed_controller_esc:
      type: Brushless ESC (Sensorless)
      ampere_continuous: Min. 120A
      lipo_support: 2S - 3S (optional up to 4S)
      bec_voltage: '6.0V or 7.4V (adjustable for servo - CAUTION: Leave at 6.0V, the
        Savöx SC-1252MG+ servo is rated for 4.8V - 6.0V!)'
      connector_system_battery: XT60 (Soldered from the factory for the G2 Combo)
      connector_system_motor: 4.0mm gold contact
      reference_model: Hobbywing QuicRun WP10BL120 G2
      packaging_note: Due to the longer motor, the ESC in the T410R chassis must be
        mounted as far back as possible or slightly offset.
      shopping_item:
        add_to_list: true
        item_name: Hobbywing QuicRun Brushless Combo WP10BL120 G2 (incl. 3660SL 3700KV
          Motor)
        category: Drivetrain & Electronics
        reference_link: https://www.rcfox.de/HW38030211-HobbyWing-Quicrun-Brushless-Combo-WP10BL120G2-mit-3660SL-3700KV-G2
        estimated_price_eur: 89.0
    brushless_motor:
      size: 3660 (36 mm diameter, 60 mm length)
      kv_rating: 3700KV
      shaft_diameter: 5.0 mm (Absolutely requires 48dp pinion with 5mm bore!)
      pole_count: 4-Pole (for high torque)
      reference_model: Hobbywing 3660SL G2 (3700KV)
      thermal_tolerance: Max. 25.0 % calculated wheel load
      shopping_item:
        add_to_list: false
    motor_pinion:
      type: Large Bore Pinion Gear
      pitch_profile: 48dp
      tooth_count: 43T
      bore: 5.0 mm (Mandatory for the shaft of the Hobbywing 3660 motor!)
      material: Hardened Steel
      shopping_item:
        add_to_list: true
        item_name: Robinson Racing RRP-2043 (48dp, 43T, 5mm Bore)
        category: Drivetrain & Mechanics
        reference_link: https://www.ebay.com/itm/234242275376
        estimated_price_eur: 15.0
Gps:
  meta:
    type: GNSS Performance Analyzer (GPS/GLONASS)
    reference_model: Ruddog GPS Performance Analyzer
    measuring_frequency: 10 Hz (10 Updates per second - critical for RC speedruns!)
    interface: Bluetooth 4.0 (Readout via iOS/Android App)
    power_supply: Integrated LiPo battery (chargeable via USB)
    weight: approx. 38 Grams
    shopping_item:
      add_to_list: true
      item_name: Ruddog GPS Performance Analyzer
      category: Testing & Validation
      reference_link: Search at RC model specialist dealer (e.g. RC-KleinKram, Tamico,
        Monster Hopups)
      estimated_price_eur: 50
  properties:
    app_integration:
      software: RC Gears / Ruddog App (or identical SkyRC App)
      functions: Top-Speed measurement, 0-100 km/h time measurement, Track-Logging
    mounting_and_setup:
      positioning: 'Must be mounted in a location that has a clear view of the sky.
        Carbon components (like the upper deck of the Carten) shield the satellite
        signal! Best mounting location: On the front foam bumper.'
      fixation: The module must absolutely be secured with velcro AND an additional
        cable tie or tape during speedruns. The G-forces during a crash are enormous.
      operation: The module flashes during the satellite search. Only start driving
        when the GPS signal is confirmed as 'Locked' (usually by a solid light), otherwise
        the first meters are missing from the measurement.
Glitch Buster:
  meta:
    brand: Ruddog
    model: Glitch Buster
    type: Receiver Capacitor / Voltage Stabilizer
    features: Prevents voltage drops and receiver brown-outs
    price_class: Low-Budget (~5 EUR)
  properties:
    mechanical_specifications:
      connector: Standard JR/Futaba servo plug
      case: Shrink-wrapped electrolytic capacitor
    performance_specifications:
      function: Buffers the BEC (Battery Eliminator Circuit) voltage to prevent sudden
        drops caused by high current draw from the steering servo.
      compatibility: Universally compatible with all standard RC receivers.
    installation:
      mounting: Plugs directly into any available free port on the receiver (e.g.,
        CH4, AUX, or BATT).
      application: Highly recommended when using a gyro, as the constant micro-adjustments
        and counter-steering commands can lead to high-frequency current spikes, causing
        voltage fluctuations and subsequent servo jitter or receiver reboots.
Gyro:
  meta:
    brand: SkyRC
    model: GC301
    type: Steering Gyro
    features: Adjustable steering gain, remote gain support
    price_class: Budget / Entry-Level (~25 EUR)
  properties:
    mechanical_specifications:
      case: Plastic
      dimensions_mm:
        length: 21.0
        width: 21.0
        height: 11.0
      weight_g: 3.6
    performance_specifications:
      operating_voltage: 4.0V - 8.4V
      current_drain: 25mA
      operating_temperature: -10°C to +45°C
    installation:
      mounting: Must be securely mounted flat and parallel to the chassis longitudinal
        axis using double-sided tape to avoid false readings from vibrations.
      wiring: Connects between the steering servo and the receiver (CH1).
      gain_control: Can be adjusted remotely via an auxiliary channel (CH3) or manually
        via the physical potentiometer on the gyro.
Laser Tachometer:
  meta:
    type: Non-contact Laser Tachometer
    reference_model: DT-2234C+ (or identical clones like Neoteck/Proster)
    measuring_range: 2.5 to 99,999 RPM
    measuring_accuracy: +/- 0.05%
    shopping_item:
      add_to_list: true
      item_name: Digital Laser Tachometer (DT-2234C+)
      category: Workshop & Tools
      reference_link: Search Amazon for 'Laser Tachometer DT-2234C+'
      estimated_price_eur: 18.0
  properties:
    test_protocol:
      preparation: Stick reflector strip (included) on the tire sidewall or pinion.
      execution: Jack up the vehicle safely. Turn on the remote control, apply full
        throttle and point the laser at the rotating strip.
      safety_warning: 'IMPORTANT: At 100 km/h wheel rotation speed, rubber tires expand
        significantly (ballooning). Wear safety goggles and do not stand directly
        in the centrifugal line of the wheels in case the tire glue fails!'
Remote Control:
  meta:
    brand: Konect
    model: X9S Radio + RG4CHWP Receiver
    type: 4-Channel 2.4 GHz Pistol Grip Transmitter
    channels: 4
    price_class: Mid-Range (~152 EUR)
    shopping_item:
      add_to_list: true
      item_name: Konect X9S Radio + Mini Waterproof 4-Channel Receiver RG4CHWP
      category: Control & Electronics
      reference_link: Search at RC model specialist dealer (e.g. Tamico, Berlinski,
        Amazon)
      estimated_price_eur: 152.0
    integrated_features:
    - Fail-Safe Function (Protection in case of signal loss)
    input_voltage: Coordination with BEC of the ESC required
  properties:
    tx_performance:
      protocol: 2.4Ghz
      range_ground: '>200m'
      response_time: Low latency for high precision
      power_supply: Transmitter batteries according to manufacturer specifications
      potentiometer: Hall Sensor for highest possible precision
    calibration_and_setup:
      fail_safe_activation: The fail-safe must absolutely be programmed to brake!
        Jack up the car, hold full brake on the remote and press the setup button
        on the receiver. When turning off the remote, the car must brake immediately.
      steering_dual_rate: Reduce the maximum steering angle via the Dual Rate (D/R)
        dial on the remote control. At 100 km/h, full steering angle leads to a rollover.
      throttle_trim: The throttle trim (TH Trim) must be exactly at the zero point
        (center) before the ESC is calibrated.
      bec_voltage_warning: The BEC of the ESC must be matched with the input voltage
        of the receiver.
Servo:
  meta:
    brand: Savöx
    model: SC-1252MG+
    type: Digital Low-Profile Servo
    features: Coreless Motor, high speed and precision
    price_class: Mid-Range (~52.72 EUR)
  properties:
    mechanical_specifications:
      gears: Metal gears
      case: Plastic with aluminum middle section
      spline_teeth: 25T (Standard Futaba/Savöx)
      dimensions_mm:
        length: 40.8
        width: 20.2
        height: 25.4
      weight_g: 44.0
    performance_specifications:
      operating_voltage: 4.8V - 6.0V
      torque_6v: 7.0 kg-cm
      speed_6v: 0.07 sec / 60°
      return_to_center_accuracy: Very good (High precision for reproducible straight-line
        stability)
    mandatory_upgrades:
      part: ALU CLAMP SERVO HORN - FUTABA, SAVÖX - 3-HOLE - 25T (HUD293409)
      reason: Guarantees an absolutely rigid, play-free steering connection. A servo
        saver is completely omitted to achieve maximum accuracy.
      installation: Tighten the clamp screw and definitely fix the main screw with
        threadlocker (e.g. Loctite medium strength).
    transmitter_setup:
      dual_rate: For the 100 km/h run, the 'Dual Rate' (D/R) or the steering throw
        (EPA) must absolutely be reduced on the remote control. Minimal steering movements
        are sufficient at top speed.
Body:
  meta:
    brand: ZooRacing
    model: Hellcat
    vehicle_class: 1:10 On-Road Touring Car
    width_mm: 190
    wheelbase_mm: 258
    material: Polycarbonate (Lexan)
    material_thickness_mm: 0.7
    shopping_item:
      add_to_list: true
      item_name: ZooRacing Hellcat 190mm Touring Car Body (0.7mm Regular)
      category: Body & Aerodynamics
      reference_link: Search at RC-KleinKram or Tonisport for 'ZooRacing Hellcat 0.7mm'
      estimated_price_eur: 32.9
  properties:
    aerodynamic_features:
      front: Low-drawn nose and gentle hood angle reduce dynamic pressure and prevent
        lift.
      roofline: Flat sloping roof guides the air laminar and undisturbed to the rear
        wing.
      rear_wing: Included high-downforce wing provides absolutely necessary rear stability
        at high speed.
Differentials:
  meta:
    type: Oil-filled bevel differential (Metal Gear)
    mechanical_load_capacity: '> 100 km/h (approx. 8,300 RPM axle speed)'
  properties:
    material_and_construction:
      gears_ring_and_bevel: Sintered metal / Steel
      diff_outdrives_cup_joints: Hardened steel
      diff_case_cup: Fiber-reinforced composite plastic
    mandatory_modifications:
      perfect_shimming:
        issue: Freedom from play
        description: The inner metal gears must be adjusted absolutely free of play
          during assembly with ultra-thin shims. Only this way is it prevented that
          the teeth skip or tear off under the high torque of the 3S motor.
      reinforced_sealing:
        issue: O-ring sealing
        description: At 8,300 RPM, the oil inside generates a massive centrifugal
          pressure outwards. The rubber O-rings must be sealed with viscous special
          grease (e.g. 'Green Slime') so that the differential does not run dry.
      oil_viscosity:
        issue: Locking effect & straight-line stability
        description: The kit oil is too soft and leads to uncontrollable breakouts
          during speedruns if one wheel loses minimal grip. Highly viscous silicone
          oil must be used to force the car into a stubborn straight-line drive.
        setup_recommendation:
          front_axle: approx. 100,000 cSt (or a completely rigid spool/solid axle)
          rear_axle: approx. 10,000 cSt
Driveshaft And Joints:
  meta:
    component: Central Drive Shaft (Center Shaft)
  properties:
    material_and_suitability:
      driveshaft:
        component: Driveshaft (Shaft)
        material: Aluminum (anodized), hollow or solid (depending on batch)
        suitability_100kmh_3s: YES. Aluminum is better here than steel, since the
          lower rotating mass generates fewer vibrations at approx. 26,000 RPM.
      joint_cups:
        component: Connectors (Diff-Inputs)
        material: Steel (Hardened)
        suitability_100kmh_3s: YES. The mounts at the differential input are made
          of steel and withstand the torque of the 3S drive.
      rpm_load:
        component: Speed load
        specification: Shaft rotates at approx. 26,000 RPM
        suitability_100kmh_3s: Critical, but doable for the kit part, as long as there
          is no imbalance.
    mandatory_durability_measures:
      centering_floating_problem:
        issue: Centering (The 'Floating' problem)
        description: The shaft must not hit back and forth in the cups ('chatter').
        action: Mandatory to place small O-rings or foam pads (often included in the
          kit or cut from old shock rubbers) into the cups before the shaft is inserted.
          The shaft must sit 'floating', but without play between the diffs.
      joint_lubrication:
        issue: Lubrication of the joints
        description: The ends of the driveshaft (dogbones) that run in the steel cups
          are metal on metal. With 3S power, massive wear occurs here ('hammering
          in').
        action: Lubricate these contact points with viscous molybdenum grease (black)
          or special 'Joint Grease' to minimize friction.
      runout_check:
        issue: Check for concentricity
        description: Roll the shaft over a glass plate (or a mirror) before installation.
        action: If it 'wobbles' even minimally (is bent), it will set the entire chassis
          into destructive vibrations at 26,000 RPM. In this case, it must be replaced
          immediately.
Gearing:
  meta:
    brand: Robinson Racing
    model: 'Motor pinion 43T (48dp / 5mm shaft) OR Robinson Racing 5mm bore 48dp 43teeth
      if 3660 motor is run with 5mm shaft: https://www.ebay.com/itm/234242275376'
    part_number: 43T-48P
  properties:
    gearing_setup:
      spur_gear:
        teeth: 68
        type: steel
        module: 48dp
      motor_pinion:
        teeth: 43
        material: steel
      calculated_values:
        internal_ratio: 2.47
        total_ratio: 3.91
        target_speed: '> 100 km/h'
Spur Gear:
  meta:
    type: CARTEN NBA360 Steel Spur Gear (48 DP, 68T)
    mechanical_load_capacity: '> 100 km/h (designed for 3S / 120A Brushless Systems)'
  properties:
    material_and_construction:
      gear_body: Steel - CNC machined
      mounting_interface: Standard 1:10 Touring car 4-hole mount
      mating_pinion: Hardened steel (mandatory)
    mandatory_modifications:
      pinion_securing:
        issue: Slipping of the motor pinion (cause of gearbox damage)
        description: In order to prevent the main gear from slipping and being destroyed
          again by asymmetrical engagement, the grub screw of the hard steel pinion
          must absolutely be secured with medium-strength threadlocker (e.g. Loctite
          243 / blue) on the flat spot of the motor shaft.
      gear_mesh_calibration:
        issue: Gear backlash at approx. 26,000 RPM (spur gear) and 41,000 RPM (pinion)
        description: The play between the steel pinion and the steel spur gear must
          be calibrated exactly with the proven paper method. Too tight play leads
          to extreme friction heat, power loss and high wear.
      material_selection:
        issue: Switch to steel spur gear
        description: Due to previous damage to plastic gears, a more robust steel
          spur gear was chosen. This increases the rotating mass, but secures the
          mechanical integrity of the drivetrain at high torques.
Cartent410R:
  meta:
    brand: Carten
    model: T410R Touring Car Kit
    part_number: NHA413
    instruction_manual: CARTEN T410 Instruction Manual-FINAL (PDF, also covers the
      T410R). Not stored in this repository (copyright of the manufacturer). Available
      from the manufacturer (https://www.carten-rc.com) and from distributors, for
      example on the download page of Blaze-RC (http://blazerc.com/download).
  properties:
    carten_t410r:
      general:
        vehicle_type: 1:10 Electric Touring Car (EP Touring Car)
        delivery_condition: Kit - unassembled
        deployment_area: On-Road / Asphalt / Carpet
      dimensions:
        track_width_mm: 190
        wheelbase_mm: 258
      chassis_and_structure:
        bottom_plate: 2.03 mm Eco-Carbon (carbon fiber reinforced composite material,
          measured with a caliper)
        upper_deck: 2.0 mm Eco-Carbon
        shock_towers: 3.0 mm Eco-Carbon (front & rear, various mounting points)
        motor_mount: CNC-machined aluminum
        servo_mount: Floating Servo Mount (Aluminum)
        battery_mount: Prepared for 2S Standard LiPo (Stickpack) or Shorty LiPo
        body_mounts: Adjustable plastic posts
      drivetrain:
        drive_type: 4WD four-wheel drive, central shaft drive
        center_driveshaft: Aluminum (red anodized)
        differentials: Sealed bevel differentials (front & rear)
        differential_gears: Metal gears
        driveshafts: Steel CVD (Constant Velocity Drives) on front and rear axle
        spur_gear_mount: Aluminum
        wheel_hubs: 12 mm hex, aluminum
        internal_ratio: 1:2.47 to 1:2.53
        ball_bearings: Fully ball-beared (with rubber seals)
      suspension_and_springs:
        shock_absorbers: Aluminum oil shock absorbers (with threaded coilover)
        suspension_arm_mounts: Aluminum (Toe Blocks)
        sway_bars: Front and rear included
        geometry_adjustment: Continuously adjustable via R/L threaded rods (Turnbuckles)
        adjustable_parameters:
        - Camber
        - Toe
        - Caster
        - Droop
        - Ride Height
        - Ackermann
      steering:
        steering_system: Ball-bearing Dual-Bellcrank-System (Double arm)
        steering_knuckles_c_hubs: Composite plastic
Tools:
  meta:
    description: Required tools for assembling the Carten T410R.
  properties:
    tool_list:
      hex_wrenches:
        type: Hex Wrenches
        sizes: 1.5 mm, 2.0 mm, 2.5 mm
        note: Mandatory purchase! Carten uses metric M3 machine screws throughout
          the car (no self-tapping screws). A high-quality hex wrench is highly important
          here, so as not to damage the screw heads and the hard plastic thread when
          screwing in.
        brand: Neewer
        model: Titanium RC Hex Wrench Set (1.5/2.0/2.5/3.0)
      box_wrenches:
        type: RC Cross Wrench / Box Wrench
        sizes: 5.5 mm and 7.0 mm
        note: The 5.5 mm is needed permanently for all M3 nuts in the chassis. The
          7.0 mm is for the wheel nuts. The 10.0 mm mentioned in the Carten manual
          is not needed at all for this 1/10 model.
        status: Available (No purchase necessary)
      adhesives_and_chemicals:
        threadlocker:
          type: Screw Cement / Threadlocker
          note: highly important! Goes on all screws that are screwed into metal (e.g.
            motor pinion). Often incorrectly labeled as 'GLUE' in the Carten manual.
            Never use for plastic!
          brand: Loctite
          model: 243 Medium Strength (Blue)
      tapes:
        glass_tape:
          type: Glass Tape
          note: Mandatory for the T410R! The car has no classic plastic battery holders.
            According to the manual, the tape is pulled through the slots in the carbon
            chassis to strap the LiPo battery down tightly.
          brand: Arrowmax
          model: Fibre Tape / Battery Tape
Tires:
  meta:
    brand: Team Corally
    model: Attack Moosgummi Reifen (C-14705-35)
    type: Foam rubber tire
    tread: Slick
    shore_hardness: 35 shore
    wheel_hub: 12mm Hex - Suitable for kit hubs of the Carten T410R
    assembly_status: Pre-glued (Industrially glued at the factory on spoke wheels)
    shopping_item:
      add_to_list: true
      item_name: Team Corally C-14705-35 Attack Moosgummi Reifen - 1/10 GP Toerenwagen
        - 35 shore
      category: Wheels & Tires
      reference_link: Search for Team Corally C-14705-35 at common RC shops
      estimated_price_eur: 31.98
  properties:
    dimensions:
      diameter_mm: 64
      width_front_mm: 30
      width_rear_mm: 30
    setup_instructions:
      ballooning_protection: Foam rubber tires physically do not expand at approx.
        8,300 RPM (axle speed at 100 km/h). The aerodynamics of the ZooRacing Hellcat
        and the ride height remain constantly safe.
      wheel_nut_securing: Mandatory to use locknuts with an intact nylon ring (M4)
        and tighten firmly. The brutal acceleration of the 3660 motor can spin off
        loose nuts immediately.
      balancing: Despite industrial production, tires can have slight imbalances.
        In case of strong vibrations on the jacked-up chassis, balance the wheels
        (e.g. with putty lead in the rim) so as not to destroy the wheel bearings
        of the Carten T410R at 100 km/h.
      break_in_scrubbing: The smooth production layer must first be worn off. Use
        the first test runs to calibrate the ESC to build up the grip for the final
        topspeed run.
