kleinnconrad/prototyping.rc.speedrun/(commit log)

2026-10-12 Add Gyro installation note to remote control section
    Added a note to install and test the Gyro gain setting.
2026-10-22 chore: update front tire width in tire spec to 30 mm
    Claude-Session: https://claude.ai/code/session_01PujooWPCrUqVPoZ2YjHFVc
2026-10-27 docs: add chassis photo to readme header
    Claude-Session: https://claude.ai/code/session_012MJxxDGBMCGRR2L7UbtQUk
2026-10-27 chore: remove obsolete motor cooling
    Revise ADR-007 to no dedicated motor cooling, since test drives showed
    that the motor does not heat up significantly at FDR 3.91. Remove the
    cooling spec and update the readme, BOM, CAD and drivetrain docs.
    Regenerate the ADR overview and full_spec.yaml.
    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
2026-10-27 docs: replace chassis photo in readme with front and rear view
    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
2026-10-27 docs: note decorative motor fan, remove unused chassis photo
    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
2026-11-03 docs: replace front chassis photo in readme with top view
    Claude-Session: https://claude.ai/code/session_012MJxxFGeBPZixkD7tuaykf
2026-11-03 docs: add rear diffuser to 3d printed parts with author credits
    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
2026-11-03 docs: add chassis photo with rear diffuser to readme
    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
2026-11-07 fix: clarify the derived values in the setup drawing
    Show the no-load speed at the fully charged cell voltage of 4.2 V in
    addition to the nominal 3.7 V, and explain the rake angle with its
    formula.
    Claude-Session: https://claude.ai/code/session_012MJxxDumo8CdPDquth9fhB
2026-11-07 docs: replace chassis photos in readme
    Replace the three chassis photos below the first photo with a side view
    and a top view of the current chassis. The new photos are scaled to
    1600 px width and contain no metadata. Delete the photos that are no
    longer used.
    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
2026-11-08 docs: replace chassis photos in readme with front and top view
    Replace the side view and the top view below the first photo with a
    front view and a top view of the chassis with battery. The new photos
    are scaled to 1600 px and contain no metadata. Delete the side view,
    which is no longer used.
    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
2026-11-08 docs: rename top view photo to show the current image
    The readme showed a cached old version of the top view, because the new
    photo was saved under the name of the previous one. Rename the photo so
    that the readme loads it under a new address.
    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
2026-11-10 feat: add CAD files of the chassis plate and top brace
    Add version 2 of the chassis plate and the top brace of the Carten
    T410R as STEP, STL, DXF and OpenSCAD files, with 1:1 PDF templates,
    hole tables, geometry data and STL files for a test print. Describe
    the files in the readme of the cad directory and move the cad
    directory from specs/mechanics to the repository root.
    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
2026-11-10 feat: add wide speedrun chassis plate CAD files
    Add the STEP and STL files of a speedrun variant of the chassis plate
    v2 with a middle section widened to 200 mm, and describe it in the
    readme of the cad directory.
    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
2026-11-10 feat: add wide speedrun chassis plate with a longer motor window
    Add a variant of the wide speedrun chassis plate in which the motor
    window is 10 mm longer toward End A (y max 118.899 -> 128.899 mm,
    length 53.272 -> 63.272 mm). The -y end, the width, the R 3.0 corners,
    the slot, the 36 holes, the outline and the thickness are unchanged.
    The variant is provided as STEP, STL, geometry JSON and a top view
    preview.
    Claude-Session: https://claude.ai/code/session_012MJxxDt1dN1iX2k97gTC2U
2026-11-10 feat: add DXF and readme for the longer motor window
    Add the DXF file of the wide speedrun chassis plate with the motor
    window lengthened by 10 mm. It uses the same layers as the DXF of the
    chassis plate v2. Describe the variant in the readme of the cad
    directory: the window is lengthened to fit the 3660 motor of the car.
    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
2026-11-10 feat: add DXF generation script and drawing of the wide chassis plate
    Add the script scripts/cad/generate_dxf.py, which generates the DXF
    files of the chassis plate v2, the top brace v2 and the wide speedrun
    chassis plate with the longer motor window from the geometry data.
    Add a top view drawing of the wide speedrun chassis plate and show it
    in the readme of the cad directory. Describe the DXF generation in the
    readme.
    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
2026-11-10 feat: add 1:1 print template of the wide speedrun chassis plate
    Add a 1:1 template of the wide speedrun chassis plate on two A4 pages
    in landscape format to check the hole positions against the actual
    part. The drawing is pre-scaled to 103.09 % for a PDF viewer that
    prints at 97 %. Each page has 100 mm bars in x and y to check the
    scale. Describe the template in the readme of the cad directory.
    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
2026-11-10 refactor: sort the chassis v2 CAD files into one directory per part
    Move the files of cad/chassis_v2 into the directories chassis_plate,
    top_brace, test_print, chassis_plate_speedrun_wide and
    chassis_plate_speedrun_wide_motor10. Move the preview image of the
    longer motor window to the photos directory. Update the paths in the
    readmes and in the DXF generation script.
    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
2026-11-10 feat: add the helper scripts of the speedrun chassis plates
    Add scripts to derive the geometry data of the wide speedrun chassis
    plate from its STEP file, to lengthen the motor window, to generate
    STEP and STL files, to check the plate with the longer motor window and
    to generate the drawing, the window preview and the print template. Add
    the geometry data of the wide speedrun chassis plate and describe the
    scripts in the readme of the cad directory.
    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
2026-11-10 feat: add 1:1 print template of the plate with the longer motor window
    Add a 1:1 template of the wide speedrun chassis plate with the longer
    motor window on two A4 pages in landscape format, pre-scaled for a PDF
    viewer that prints at 97 %. It shows the longer window as a solid line
    and the end of the previous window as a green dashed line. Add the
    option --plate to the print template script and describe both
    templates in the readme of the cad directory.
    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
2026-11-11 docs: record the result of the chassis test print
    The test print of the chassis plate and the top brace fits the car.
    Mark both parts as verified, resolve the open point of the overall
    length and state which parts of the speedrun chassis plates the test
    print covers.
    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
2026-11-11 fix: correct the thickness of the chassis bottom plate to 2.03 mm
    The chassis specification listed 2.25 mm for the bottom plate. A
    measurement with a precise caliper resulted in 2.03 mm. Correct the
    specification, the merged specification and the plate thickness in the
    setup drawing, and resolve the open point in the readme of the cad
    directory.
    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
2026-11-12 feat: add CAD model and measurement sheet of the lower bulkhead
    Add version 1 of the lower bulkhead (gear box lower half, stock part
    NBA249) in the new directory cad/bulkhead:
    - STEP and STL file with nominal dimensions for CNC manufacturing
    - test print STL with bearing seats +0.2 mm and 2.7 mm M3 holes
    - parameter file with a source for every dimension (plate, manual,
    user, photo, design)
    - 4-page caliper measurement sheet with 30 numbered dimensions
    The bottom hole pattern comes from the chassis plate (H03 to H06,
    H28 to H31), the bearing sizes from the manual and the screw sizes
    from the owner. The other dimensions are estimates from photos and
    are replaced after the caliper measurem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
2026-11-12 feat: add the ring gear deepening to the lower bulkhead
    The stock gear box has a deepening in the bottom on the side of the
    42T ring gear. Model v1 had one cavity with a radius of 16 mm across
    the whole diff. The cavity now has two depths:
    - radius 12 mm around the diff axis for the diff case (floor 5.5 mm)
    - radius 16 mm from x = 4.5 to 11.0 mm on the ring gear side for the
    ring gear (floor 1.5 mm)
    The ring gear side (+x, left when seen from the pinion housing) is
    taken from the photos. The measurement sheet has 7 new dimensions for
    the deepening, the diff case and the ring gear position.
    Claude-Session: https://claude.ai/code/ses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
2026-11-12 feat: update the lower bulkhead to version 2 with caliper values
    Version 2 of the lower bulkhead uses 27 caliper values of the stock
    part and a second set of photos with rulers at the height of the part.
    Main changes compared to version 1:
    - bottom holes 28.0 x 20.0 mm (was 28.17 x 20.22 from the plate CAD)
    - parting face 17.2 mm, bosses 4.86 mm, 2.42 mm high, spacing
    18.7 mm (pinion side) and 21.6 mm (outer side)
    - diff seats with outer lip (12.28 mm), seat 15 x 4 mm and inner
    shoulder 1.89 mm, lips 30.7 mm apart
    - pinion seat 9.25 mm long with a rib between the two bearings
    - ring gear deepening with a radius of 16.4 mm (ring gear 31.93 mm),
    floor 0.8 mm, pinion pocket for the 14.1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
2026-11-12 fix: remove the inner shoulder of the diff bearing seats
    The diff bearing seats of the stock part are limited only by the outer
    lip. The half bore runs 4 mm inward from the lip and then opens into the
    gear cavity. Value 15 of the measurement sheet was the lip again.
    - remove the inner shoulder (1.89 mm) on both sides
    - lip thickness 1.89 mm with the inner faces 30.7 mm apart, width over
    the outer faces 34.48 mm (measured: 34.2 mm)
    - gear cavity and ring gear deepening extend to the inner end of the
    bearing seats (x = 11.35 mm)
    Claude-Session: https://claude.ai/code/session_012MJxxDDaacyAL3YFN2nfVb
2026-11-12 feat: add the upper bulkhead v1 and remove the pinion shoulder
    Lower bulkhead v2 (fix): the pinion seat has no shoulder at its inner
    end. The two 5x10x4 bearings are held only by the 1.25 mm rib between
    them. The pinion pocket now runs to the inner end of the seat.
    Upper bulkhead v1 (new design, prismatic):
    - footprint of the lower part, extruded to flat levels: flange for the
    outer screw heads, block over the diff and the ring gear, shock tower
    wall over the full width, flat top brace face on the pinion side
    - bearing seats, lips, rib and gear cavities from the parameter file of
    the lower part, recesses for the 4 bosses of the lower part
    - shock tower: 4 tapped M3 holes through the 8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
2026-11-12 feat: enter the caliper values of the stock upper bulkhead
    Caliper values of the stock upper part (measurement sheet U1 to U10):
    - shock tower holes 19.1 mm across, 6.1 mm up/down, lower holes 22.5 mm
    above the parting face (were 20.0 / 5.6 / 22.7 from photos)
    - top brace screws 25.6 mm across, top brace face 15.4 mm above the
    parting face (was 16.8 mm)
    - top of the shock tower wall 31.5 mm
    Design changes:
    - shock tower wall 6 mm thick (stock ears 5.8 mm, U4), 5 mm thread
    engagement for the M3x8 screws
    - gear block 17.8 mm high, equal to the zone kept free for the shock
    tower plate
    - mass 57 g in 7075 (was 62 g)
    Still open: position of the shock tower contact face (U5, U6) and of
    t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
2026-11-12 fix: enlarge the diff case cavity after the test print
    Test print of the lower bulkhead v2: the diff case touched the wall of
    the cavity on the outer side (opposite the pinion). The radius of the
    diff case cavity is increased from 12.5 mm to 13.5 mm. The upper
    bulkhead reads the same parameter, so both halves change.
    The ring gear deepening is not changed yet: the floor below it is
    0.8 mm thick, so 2 mm more depth toward the bottom face is not
    possible. The contact point is still to be located.
    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
2026-11-12 fix: open the floor below the ring gear of the lower bulkhead
    Test print of the lower bulkhead v2: the ring gear did not rotate
    freely. The stock part has an extra deepening of approx. 5 mm length
    with approx. 0.7 mm more space below the ring gear. The floor below the
    deepening is only 0.8 mm thick, so the extra deepening is made as a
    through opening of 6.85 x 5 mm, centred below the diff axis. The
    chassis plate closes the gear box from below. The lowest tooth of the
    ring gear is now 1.23 mm above the chassis plate (before: 0.43 mm
    above the floor).
    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
2026-11-12 fix: more space for the pinion in both bulkhead halves
    Test print of the lower bulkhead v2: the pinion of the centre shaft
    needs more space to rotate. The radius of the pinion pocket is
    increased from 7.75 mm to 8.25 mm (clearance to the 14.1 mm pinion
    1.2 mm). The upper part reads the same parameter.
    Below the wing of the lower part, a shell with a radius of 9.75 mm now
    surrounds the pocket. The wall below the pocket is at least 1.5 mm
    (before: 0.35 mm next to the pinion seat).
    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
2026-11-12 refactor: remove version suffixes from file names
    Versioning is done by git. File names, directories, headings and labels
    no longer carry version suffixes:
    - cad/chassis_v2 -> cad/chassis, *_v2 files of the chassis plate, the
    top brace and their test prints renamed
    - bulkhead files without _v1/_v2 (parameters, STEP, STL, test print STL,
    measurement sheets, assembly, preview images)
    - photos/cad_chassis_v2_* renamed
    - readme headings, table of contents, script defaults, plot labels and
    parameter notes without version numbers
    - geometry data: field "version" renamed to "basis" (regenerated with
    geometry_from_step.py and lengthen_motor_window.py, geometry unchanged)
    Regenerated: speed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
2026-11-12 feat: add a script for the chassis plate and top brace templates
    The drawing photos/cad_chassis_drawing.png and the 1:1 templates of the
    chassis plate (A3, 2 x A4) and the top brace (A4) had no generator in
    the repository and still showed version marks in their text. The new
    script generate_chassis_templates.py redraws all four files from the
    geometry data:
    - A3 and A4 templates with outline, cutouts, holes with centre cross,
    countersinks, hole labels and two 100 mm bars per page
    - 2 x A4 template with the 20 mm overlap zone (y = 150 to 170 mm)
    - drawing with hole labels and the main dimensions (99.98, 325.61,
    15.09, 243.30 mm, calculated from the geometry data)
    - option --print-scale f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
2026-11-12 feat: add 97 % print templates of the chassis plate and the top brace
    The PDF viewer of the owner prints at 97 %. The script
    generate_chassis_templates.py now also writes pre-scaled copies of the
    three templates (suffix _print97, content scaled to 103.09 %):
    - chassis_plate_T410R_1to1_A3_print97.pdf
    - chassis_plate_T410R_1to1_A4x2_print97.pdf
    - top_brace_T410R_1to1_A4_print97.pdf
    The pre-scaled templates state the print scale and that a print at
    100 % is 3.1 % too large. On the A3 page, the plate is placed 10 mm
    lower to keep the notes clear of the plate end.
    Check: hole distances in the PDFs are 1.0309 times the geometry data
    (100 % templates: 1.0).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
2026-11-12 feat: redesign the lower bulkhead to match the upper part
    Second test print of the lower bulkhead: functional, with two changes.
    Pinion seat (lower and upper part): the rib between the two bearings
    was too high and too thick. Rib height 0.75 mm -> 0.3 mm (opening
    8.5 mm -> 9.4 mm), rib width 1.25 mm -> 0.9 mm. The face toward the
    pinion is not moved.
    Shape of the lower part, in the style of the upper part:
    - footprint of the upper part (corner radius 6 mm, outer end at
    y = -25.5 mm), flush with the upper part
    - flat contact block on the chassis plate, one straight chamfer per
    side up to the ends (space for the pivot blocks of the wishbones)
    - stepped rectangular block below the pinion,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
2026-11-12 fix: close the opening below the pinion pocket of the lower bulkhead
    The wide block below the pinion pocket ended exactly at the end of the
    pocket (y = 18.65 mm). Behind it, the narrow block and the chamfer
    start 10.15 mm above the bottom face, while the pocket reaches down to
    8.95 mm. The end face of the pocket had a window of approx. 8.6 x 1.2 mm
    to the outside. In addition, the pocket cut ran 0.01 mm past the block.
    - the wide block now ends 1.5 mm behind the pocket, the pocket ends
    exactly at the pinion seat (no 0.01 mm overrun) in both parts
    - diff case cavity without the 0.01 mm overrun into the bearing walls
    - pinion end beyond the footprint as a rectangular block in both parts
    (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
2026-11-12 feat: add the speedrun top brace in the design of the bulkheads
    New design of the top brace in cad/chassis/top_brace_speedrun. The
    original top brace is kept unchanged.
    - holes B01 to B04 and B07 to B15 unchanged, B05 and B06 in the middle
    part closed, both slots in the middle part closed (solid bar 15.09 mm)
    - ends as wide as the bulkheads (34.48 mm), flat end edges instead of
    the notches for the rib of the stock upper bulkhead, corner radius
    4 mm, transitions at 30 degrees with 3 mm fillets
    - rectangular window instead of the hexagon (contains the hexagon),
    obround at the spur gear unchanged
    - STEP, STL, DXF, hole table, 1:1 templates (100 % and 97 %), test
    print halves with a d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
2026-11-12 docs: add the speedrun chassis design to both readmes
    New script generate_speedrun_assembly.py builds the complete speedrun
    chassis from the files of the parts: speedrun chassis plate with the
    longer motor window, lower and upper bulkhead at both ends (rotated by
    180 degrees at End A) and the speedrun top brace.
    - assembly file cad/assembly/speedrun_chassis_T410R.step (one solid per
    part, coordinate system of the chassis plate)
    - image photos/cad_speedrun_chassis_assembly.png with a 3D view, a side
    view and a top view (replaces cad_top_brace_speedrun_assembly.png)
    - volumes, masses (410 g with plate 6082, bulkheads 7075, top brace
    carbon) and an interference check of all pairs of part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
2026-11-12 docs: mark the chassis plate, the lower bulkhead and the top brace as verified
    The owner of the car verified three parts of the speedrun chassis:
    - speedrun chassis plate (wide) with the longer motor window
    - lower bulkhead
    - speedrun top brace
    Status lines, the parts tables in both readmes and the title of the
    lower bulkhead preview are updated. Open points that were part of the
    verification (fit of the motor, clearance to the wheels and the body,
    clearance to the pivot blocks, test print of the top brace with the
    new bulkheads) are closed. The upper bulkhead stays not verified.
    Claude-Session: https://claude.ai/code/session_012MJxxD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
2026-11-12 chore: remove the license, all rights reserved
    The designs of this repository are not licensed for use by others at
    the moment.
    - LICENSE (MIT) removed
    - root readme: section "Licensing" (MIT, CC BY 4.0) replaced by the
    section "Copyright" with an all-rights-reserved notice
    - CAD readme: references to the licenses of this repository removed;
    the licenses of the third-party files are unchanged
    - setup drawing: title block shows "Copyright: All rights reserved"
    instead of "License: CC BY 4.0" (script and both SVG files)
    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
2026-11-12 feat: close the window at End A of the speedrun top brace
    The window at the end with B01 to B04 is obsolete (owner of the car)
    and is closed. The outline keeps the 30 degree transitions (variant C
    of the end shapes).
    - generate_top_brace_speedrun.py: no cutout at the end with B01 to B04
    - regenerated: geometry data, STEP, STL, DXF, 1:1 templates (100 % and
    97 %), test print half A, drawing, assembly STEP and assembly image
    - holes, outline, hole table and test print half B unchanged; all
    checks unchanged (fit to both bulkheads, outline, no interference)
    - mass 14.3 g in carbon, 25.1 g in 7075 (was 13.8 g / 24.3 g),
    speedrun chassis 411 g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
2026-11-13 feat: add inside radii and bearing relief grooves to the bulkheads
    - Round the vertical inside corners of both bulkheads with 1.0 mm (end
    mill 2 mm). The script closes the horizontal section at each inside
    edge (offset +r and -r) and extends the added faces to the parting
    face. This also closes the 0.32 mm gap between the block under the
    pinion and the pinion bosses.
    - Add relief grooves (1.0 mm long, 0.5 mm deep) at the bearing stop
    faces: inner faces of the diff lips and both faces of the pinion rib.
    Stop faces, seat diameters and bearing positions are not changed.
    - Build the outer shape first, round the corners, then cut all
    functional voids, so the radii cannot change cavi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
2026-11-13 fix: remove the relief grooves, the inside of the bulkheads stays verified
    - Remove the relief grooves at the bearing stop faces and their
    parameters. The bearing seats, lips and the rib are again the
    geometry verified with the diff and the pinion.
    - The functional check compares each part with the model without
    radii (verified inside): no added or removed material may touch the
    cavities, bearing seats, holes, recesses or keep-out zones.
    - Direct comparison with the STEP files before the radii: 0 mm3
    removed, only the radii of the outer shape added.
    Claude-Session: https://claude.ai/code/session_012MJxxEEjoVgHx6jU6rcxWi
2026-11-13 feat: add radii and edge chamfers on the outer side of the bulkheads
    - Radius 1.0 mm on the vertical outside edges of both bulkheads.
    - Edge chamfer 0.5 mm on the other hard outside edges, cut with a tool
    along each edge. Edges where a chamfer is not possible (narrow faces,
    thin slivers) are left as they are; at tangent neighbours the chamfer
    stops before the ends. The generators list the edges left as they are.
    - Root radius 2.0 mm on both sides of the shock tower wall of the upper
    bulkhead, around the corners of the wall. The keep-out zone of the
    shock tower starts at 19.8 mm; a new shock tower is planned, the stock
    plate does not fit.
    - The inside of the parts and the parting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
2026-11-13 fix: run the edge chamfers of the bulkheads through tangent junctions
    - Edges that meet tangentially (straight edge and arc of a corner
    radius) are cut together as a chain, so the edge chamfer has no gap
    at the junction (deck, gear blocks and flange of the upper part).
    - At a free end of a chain, the edge chamfer stops 0.1 mm before the
    point where a face beside the edge becomes narrower than 1.0 mm
    (bisection along the edge) instead of excluding the edge.
    - Upper part: 27 full, 8 stopped, 2 short arcs left (was 23, 10, 4).
    Lower part: 18 full, 18 stopped, 12 short edges left (was 18, 8, 22).
    - The inside of the parts is unchanged (functional check passed).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
2026-11-13 feat: add the speedrun front shock tower for the speedrun upper bulkhead
    - New front shock tower: 3 mm carbon plate on the contact face of the
    shock tower wall, 4 mounting holes on the tapped holes of the upper
    bulkhead (screws M3x8).
    - Damper holes in the stock positions (measurements of the owner).
    - Camber link holes at the stock height, moved 3.19 mm outward so that
    the rod ends behind the tower are clear of the full-width wall.
    - Outline without sharp corners (round ends, R1 inside corners), edge
    chamfers 0.5 mm on both faces, 0.3 mm on the holes; relief on the
    back face along the bottom edge clears the root radius of the wall.
    - Checks: holes on the tapped holes, 0 mm3 interf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
2026-11-13 feat: add edge chamfers to the speedrun top brace
    - Edge chamfers 0.5 mm on both faces of the outline and the obround,
    chamfers 0.3 mm on both ends of the holes, as on the bulkheads and
    the front shock tower. Mass 14.0 g in carbon (was 14.3 g).
    - The chamfer tools (triangle swept along each line and arc of a
    contour) move to generate_solid.py and are shared by the top brace
    and the front shock tower (shock tower output unchanged).
    - The speedrun assembly uses the chamfered top brace. Checks: 0 mm3
    interference with both upper bulkheads, no thin slits or walls.
    - The DXF keeps the 2D outline; the chamfers are in the STEP file and
    in the readme.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
2026-11-13 feat: add the speedrun rear shock tower for the speedrun upper bulkhead
    - New rear shock tower: 3 mm carbon plate on the contact face of the
    bulkhead (screws M3x8), as the front tower.
    - Damper holes (x +-36.15, 26.6) and body post mounts (bore 5.2 at
    31.2, screw bore 3.2 at 37.85, x +-51.65) in the stock positions
    (measurements of the owner).
    - Camber link holes (wheel mounts) at the stock height, moved 3.19 mm
    outward as on the front tower (rod ends beside the full-width wall).
    - Outline: straight top edge over the width of the bulkhead, rising
    edges to round ends around the body post mounts, lobes around the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
2026-11-13 fix: show the speedrun shock towers in the upper bulkhead preview and mark the front shock tower as verified
    - The preview of the upper bulkhead uses the speedrun front and rear shock
    towers and the end of the speedrun top brace instead of simplified bodies:
    assemblies at End A (front tower) and End B (rear tower).
    - The front shock tower is verified by the owner: status in the drawing
    title and in both readmes. The open points apply to the rear tower.
    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
2026-11-13 fix: move the damper holes of the rear shock tower to 2 mm above the upper mounting hole
    - Correction by the owner: the centre of the damper hole lies 25 mm outward
    from the outer end of the upper mounting hole and 2 mm up (before: 2 mm
    down). New position x = +-36.15 mm, 30.6 mm above the parting face, edge
    distance 5.3 mm. The outline and the fit to the bulkheads do not change.
    - Rear tower files, speedrun assembly and upper bulkhead preview regenerated.
    - Drawings of the towers: height labels at least 1.8 mm apart, hole labels
    of the body post mounts readable on the plate.
    Claude-Session: https://claude.ai/code/session_012MJ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
2026-11-13 fix: show the speedrun front shock tower in the setup drawing
    - The side view and view A (front axle) of the setup drawing use the outline,
    the holes and the height of the speedrun front shock tower from
    cad/shock_tower/shock_tower_front_geometry.json instead of the schematic
    stock tower. The dampers are mounted on D1/D2, the camber links on C1/C2.
    - View B (rear axle) keeps the schematic tower.
    - The workflows of the setup drawing also run when the geometry of the front
    shock tower or the parameters of the lower bulkhead change.
    - Light and dark variants regenerated.
    Claude-Session: https://claude.ai/code/session_012MJxxEEjoVg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
2026-11-13 docs: mark the speedrun rear shock tower as verified
    - The rear shock tower is verified by the owner: status in the drawing title
    and in both readmes. All parts of the speedrun chassis are verified.
    - Open points of the shock towers: the test print and the check of the body
    post mounts are done. The remaining points (rod end size, camber geometry,
    hole size of the stock towers) are not required for manufacturing.
    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
2026-11-13 fix: move the camber link holes of the shock towers to the stock position and narrow the shock tower wall
    - Shock towers (front and rear): camber link holes C1/C2 at the stock
    position x = +-18.05 mm, 19.1 mm (owner: they were about 3 mm too far
    outward). The outline and the back relief follow the narrowed wall.
    - Upper bulkhead (outer shape only): shock tower wall and gear block
    narrowed to 28.0 mm (wall_half_width 14.0 = 18.05 - rod end radius 4.0
    - 0.05), with side steps 15.0 mm above the parting face from the front
    of the gear block to y = 5.0 mm. Space for the rod ends (radius 4.0,
    9 mm long) and the camber link lobes of the towers. Root radius over
    the narrowed width, kee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
2026-11-13 feat: show the speedrun rear shock tower in view B of the setup drawing
    - View B (rear axle) and the rear tower in the side view use the outline,
    the holes and the height of the speedrun rear shock tower from
    cad/shock_tower/shock_tower_rear_geometry.json: dampers on D1/D2, camber
    links on C1/C2, body post bores B1/B2 and S1/S2. In the side view the
    rear damper sits on the outer face of the tower.
    - The workflows of the setup drawing also run when the geometry of the
    rear shock tower changes.
    - Light and dark variants regenerated, readme sentence updated.
    Claude-Session: https://claude.ai/code/session_012MJxxEEjoVgHx6jU6rcxWi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
2026-11-13 revert: restore the setup drawing to its state before the shock tower changes
    The setup drawing is not to be changed (owner). The script
    generate_setup_drawing.py, both SVG files, the workflow triggers and the
    readme sentence are restored to their state before the speedrun shock
    towers were drawn in it. The views A and B show the schematic towers again.
    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
2026-11-13 feat: add close-ups of both ends to the assembly picture of the speedrun chassis
    - The assembly picture gets a second row with close-ups of End A (front
    shock tower) and End B (rear shock tower), seen from the outer end: the
    narrowed shock tower wall with the side steps of the upper bulkhead and
    the camber link lobes of the towers are visible at this scale.
    - The overview, the side view and the top view are unchanged.
    - CAD readme: description of the picture.
    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
2026-11-13 docs: add the motivation for the speedrun parts to the root readme
    - Motivation above the assembly picture: CNC machining from aluminium for
    the stability of the car; chassis plate matching the ZooRacing Hellcat
    body with space for 4S or 6S, a dual motor setup and the telemetry
    system; the other parts are stock parts of the manufacturer.
    - Intro sentence: the shock towers are no longer listed as unchanged
    stock parts.
    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
2026-11-13 docs: add the shock towers and the simplified design to the motivation of the speedrun parts
    - Shock towers: flat 3 mm plates, laser cut from aluminium or another
    material of choice; outline and holes from the DXF files, the relief on
    the back face as a second machining step.
    - Simplified design of the bulkheads, the shock towers and the top brace.
    - CNC machining bullet limited to the chassis plate, the bulkheads and the
    top brace.
    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
2026-11-13 docs: separate CNC machining and laser cutting in the motivation of the speedrun parts
    - CNC machining: chassis plate (precision of the countersunk holes) and
    bulkheads (three-dimensional parts, cannot be laser cut).
    - Laser cutting: top brace and shock towers (flat plates with plain holes)
    from aluminium or another material of choice; chamfers and the relief of
    the shock towers as a second machining step.
    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
2026-11-13 docs: list the CAD designs in the artefacts of the root readme
    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
2026-11-13 docs: remove the Carten instruction manual and link its sources instead
    - The PDF of the T410R instruction manual (copyright of the manufacturer) is
    removed from the repository.
    - Links to the manufacturer and to the download page of a distributor in the
    chassis spec (instruction_manual, merged into full_spec.yaml) and in the
    sources section of the CAD readme.
    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
2026-11-13 feat: add the stock pivot blocks of the wishbones as reference parts
    - Parameter file with the measurements of the owner: long block (1 piece,
    End B outer, 53.4 mm, hinge pins 44.6 mm) and short block (3 pieces,
    hinge pins 41.4 mm), width 5.94 mm, heights 9.0 / 6.4 / 3.8 mm. Distances
    of the mounting holes from the speedrun chassis plate: 31.82 mm (H01/H02)
    and 29.12 mm (H07/H08, H26/H27, H32/H33).
    - generate_pivot_blocks.py: STEP and STL files, drawing, checks of the
    mounting holes (largest offset 0.03 mm) and of the clearance to the
    bulkheads.
    - Assembly of the speedrun chassis: the 4 blocks as reference parts (not in
    the mass total). Finding: the long block at End B overlaps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
2026-11-13 refactor: move the pivot blocks to cad/stock_parts and mark them as not part of the speedrun design
    - The files of the pivot blocks move from cad/pivot_block to
    cad/stock_parts/pivot_block. A readme in cad/stock_parts states that the
    models are stock parts, not part of the speedrun design, modelled for the
    completeness of the build.
    - Parameter file, generator script, drawing title and legend of the
    assembly picture carry the same note.
    - Readmes: new directory, section heading and wording.
    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
2026-11-13 fix: model the hinge pin bores of the pivot blocks as blind holes 4.7 mm deep
    - Measurement of the owner: the 6.0 mm bores of the hinge pin seats are
    4.7 mm deep and do not go through the block (wall 1.24 mm). In block
    coordinates they open at y = +width/2; the side on the car is an open
    point.
    - Pivot block files, drawing (top view with the bore depth, footnote on two
    lines) and assembly regenerated. The outer shape and the clearance checks
    are unchanged.
    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
2026-11-13 fix: turn the pivot blocks so that the hinge pin bores open toward the bulkhead
    - Information of the owner: the blind bores open toward the bulkhead. The
    blocks at End B, inner and End A, outer are turned by 180 degrees; the
    other two keep their orientation. Point test: all bores are open on the
    side of the bulkhead and closed on the far side.
    - Parameter note, drawing labels and CAD readme updated; the open point on
    the side of the opening is removed. Assembly regenerated, checks
    unchanged.
    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
2026-11-13 feat: add the stock centre driveshaft (NHA413) with the cup joints as STL and STEP
    - generate_driveshaft.py: shaft with ball ends and cross pins, cups with
    bore and slots (NBA255) on the pinion axis between the two bulkheads
    (x = 0, 19.2 mm above the chassis plate, pinion housings 210.03 mm apart),
    axial play 1.0 mm (0.5 mm at each end). STEP and STL files of the shaft and
    the cup, drawing, checks: no overlap with the cups, the bulkheads and the
    chassis plate.
    - Manual: part numbers, cross pins 2.0 x 7.6 mm, O-ring 5.8 x 9.6 x 1.9 mm in
    the cup. The length of NHA413 is not published; at End B the spur gear and
    a third bearing sit between the pinion housing and the cup (manual s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
2026-11-13 feat: cross holes for metal pins in the centre driveshaft, cup joints and diff outdrives in the assembly picture
    - Centre driveshaft (STEP/STL): cross holes 2.0 mm at the centres of the
    ball ends for the metal pins NBA255 2.0 x 7.6 mm, which fix the shaft in
    the slots of the cups in the direction of rotation.
    - The cups on the pinions are no longer exported as CAD files (owner: too
    trivial to model). Metal pins, cups on the pinions and cups of the diff
    outdrives (both sides of each bulkhead) are simple bodies in the assembly
    picture only and are not in the assembly STEP file.
    - Checks: pins in the cross holes and in the slots, no overlap of the shaft,
    pins, cups and outdrives wit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
2026-11-13 fix: model the metal pins as fixed on the centre driveshaft
    - Owner: the pins are fixed on the driveshaft. The shaft model (STEP/STL)
    contains the metal pins NBA255 2.0 x 7.6 mm at the centres of the ball
    ends again, as one solid; no cross holes and no separate pin bodies.
    - Assembly picture: the pins are part of the shaft; cups on the pinions and
    diff outdrives stay picture-only bodies.
    - Parameter file (pin_hole_d removed), drawing, readmes updated. Checks:
    0 mm3 overlap of the shaft with the cups, the bulkheads and the plate.
    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
2026-11-13 docs: list the stock parts as not verified
    - Root readme and CAD readme: table of the stock parts below the parts
    table of the speedrun chassis (pivot blocks, centre driveshaft), status
    "Not verified", not in the mass total. "All parts are verified" now refers
    to the parts of the speedrun design.
    - Status lines of the stock part sections, cad/stock_parts/readme.md and
    the titles of the pivot block and driveshaft drawings: not verified.
    - CAD readme: the assembly file contains 8 parts of the speedrun chassis
    and 5 stock parts.
    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
2026-11-14 feat: rear drive line with spur gear and motor mount, measured cup joints, length of the centre driveshaft
    - Cup joints NBA255 from the measurements of the owner: 9.7 / 6.33 mm,
    18.3 mm long, slots 7.7 mm for the metal pins of the shaft.
    - End B (manual steps 5, 10, 12): rear pinion shaft NBA205 from the
    bulkhead with flange and spur gear 68T 48DP (in the slot of the chassis
    plate, y = 51.63 to 55.63 mm), bearing NBA298 in the motor mount NBA201
    (holes H09/H10, y = 62.48 mm), cup joint beyond the motor mount.
    - Centre driveshaft: pins in the slots with 0.5 mm to the closed slot ends
    (1.0 mm axial play), length 174.28 mm (before: 202.03 mm, provisional).
    - Diff outdrives: bore 9.6 m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
2026-11-14 feat: motor mount NBA201 for 540 motors with long holes, 72T spur gear, motor mount 6.2 mm
    - Motor mount (owner: 6.2 mm thick, 540 motors; shape from manual step 10):
    low part with a U-shaped notch for the bearing NBA298 at the pinion axis,
    tall part beside the end of the top brace with three long holes along x:
    motor shaft (13 mm wide) at the height of the pinion axis and the motor
    screws M3 12.5 mm above and below. Motor axis x = 25 to 33 mm (centre
    distance 27.0 to 31.0 mm for 72T 48DP and pinions of 30 to 45 teeth).
    - Spur gear: standard 72T 48DP (39.16 mm) in the slot of the chassis plate.
    - Centre driveshaft: 173.68 mm (cup joint at End B 0.6 mm further out).
    - Drawing: third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
2026-11-14 feat: add the cap of the motor mount between the motor mount and the top brace
    - Second part of NBA201 (manual step 25 and parts list): block on the low
    part of the motor mount, from 24.6 mm up to the top brace (34.6 mm), above
    the bearing NBA298, with a semicircular notch in its top face and 2 through
    holes below the holes B10/B11 of the top brace (x = +-7.02 mm). 2 screws
    M3x18 from the top brace through the cap into the motor mount fix the
    motor mount to the top brace.
    - Height 10 mm derived from the screws M3x18; the low part of the motor
    mount now ends at 24.6 mm and reaches to x = -11 mm.
    - Picture only, no CAD file. Checks: no overlap; the cap touches the top
    brace. Draw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
2026-11-14 docs: mark the new drive line parts as stock parts, not verified
    - Stock parts tables in the root readme and the CAD readme: cup joints
    (NBA255), rear pinion shaft with spur gear 72T and bearing (NBA205,
    NBA252, NBA298), motor mount with cap (NBA201) and diff outdrives, each
    "Not verified", assembly picture only (no CAD file).
    - Driveshaft section, cad/stock_parts/readme.md and the parameter file:
    these parts are stock parts, not part of the speedrun design, not
    verified.
    - Assembly picture: legend entries of all stock parts start with "Stock";
    note below the legend: not part of the speedrun design, not verified, not
    in the mass total.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
2026-11-14 docs: mark all unverified parts as work in progress
    - Stock parts tables (root readme, CAD readme): "Not verified, work in
    progress" for the pivot blocks, the centre driveshaft, the cup joints,
    the rear pinion shaft with spur gear and bearing, the motor mount with cap
    and the diff outdrives.
    - Status lines of the stock part sections, cad/stock_parts/readme.md, the
    parameter files of the pivot blocks and the driveshaft, the titles of the
    pivot block and driveshaft drawings and the note below the legend of the
    assembly picture: not verified, work in progress.
    Claude-Session: https://claude.ai/code/session_012MJxxEEjoVgHx6jU6r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
2026-11-14 feat: CAD files of the stock drive line parts, motor mount and diff outdrives
    - generate_driveshaft.py writes STEP and STL files (part coordinates) of
    all stock parts of the drive line: cup joint NBA255 (driveshaft/), rear
    pinion shaft NBA205 with flange (now from the inner end of the pinion
    seat through the bearings of the bulkhead), spur gear 72T 48DP with
    simplified teeth, centre bore and 4 screw holes, bearing 5x10x4
    (rear_drive/), motor mount NBA201 and its cap (motor_mount/), diff outdrive
    (diff_outdrive/). All solids valid.
    - The assembly STEP contains these parts (24 solids); they are no longer
    picture-only. Legend without "picture only".
    - Parameter file, drawing footn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
2026-11-14 Show the stock drive line in the assembly picture
    * Add a third close-up: stock drive line at End B (spur gear, motor mount
    with cap, cup joint), seen from the middle of the car, without the top
    brace and the shock towers, which hide the spur gear.
    * Darker colour of the motor mount, so that it is visible on the light
    background (picture and STEP colour).
    * Describe the close-ups in the root readme and the CAD readme.
    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
2026-11-14 Add the stock front and rear wishbones with hinge pins
    * New generator scripts/cad/generate_wishbones.py with the parameter file
    cad/stock_parts/wishbone/wishbone_parameters.json: front arm and rear
    arm NHA402 (manual step 7 and parts list) and the inner hinge pin
    NHA423 3x42, STEP and STL files.
    * Arms placed on the pivot blocks: front hinge pins parallel to the car
    axis, rear hinge pins turned by 2.33 degrees (long pivot block, toe-in).
    * Checks: 0.46 mm between the inner lugs and the lower bulkhead at End A,
    0.07 to 0.14 mm to the pivot blocks, 0.34 / 0.45 mm end play of the
    hinge pins in the bores; assembly of 32 parts without new overlaps.
    * Drawing photos/cad_wishbones_draw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
2026-11-14 Rebuild the stock wishbones from the photos of the owner
    * Front and rear arm as a frame without a floor: long inner lugs with an
    open notch, shoulders, parallel side rails, open window with X-shaped
    ribs, outer cross bar, outer lugs; front arm with the open loop and the
    thin closed loop beyond the outer lugs, rear arm with the U.
    * Octagonal plate for the shock ball stud above and below rail A (front
    2 holes, rear 3 holes); sway bar holes in rail B (front 3, rear 1).
    * Dimensions estimated from the photos, scaled with the length along the
    hinge pin (33.0 mm): rear arm 55 mm, front arm 49 mm pin to pin.
    * Drawing and readme list the caliper measurements A to T.
    * Checks: no overlap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
2026-11-14 Consolidate the headings of the CAD readme, mark verified parts
    * CAD readme: 36 instead of 66 headings. Subsections of each part are
    merged (the former headings are bold labels), the stock parts are
    grouped in one section, the 3D printed parts are one table, and
    repeated sentences about the stock parts are removed. Table of
    contents regenerated, all links to the CAD readme updated.
    * Verified parts get a green check mark (LaTeX math, no emoji character)
    in the CAD readme and the root readme.
    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
2026-11-14 Add a measurement sheet for the stock wishbones and the motor mount
    * New script scripts/cad/generate_measurement_sheets.py writes
    cad/stock_parts/stock_parts_measurement_sheet.pdf (A4, 4 pages): front
    and rear wishbone with a dimension line and a letter for each caliper
    measurement (A to T), a table with the model values and empty fields,
    and the bearing seat of the motor mount (MM1 to MM8).
    * Readmes list the sheet and the script.
    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
2026-11-14 Enter the caliper measurements of the wishbones, motor mount and driveshaft
    * Wishbones: measured values A to Q and T of the measurement sheet
    (front and rear), droop boss position per arm. The measured inner lugs
    (7.2 mm) reach 0.14 mm into the side faces of the lower bulkhead at
    End A (2.16 mm3 per front arm): open point.
    * Driveshaft: rod 6.0 mm, ball ends 5.0 mm, length 173.0 mm (ruler);
    the axial play (1.78 mm) follows from the measured length.
    * Cup joints: back bore for the pinion shaft, groove for the O-ring and
    cross hole for the retaining pin NBA255 2.0x7.6; the rear pinion shaft
    reaches into the cup joint and carries the retaining pin.
    * Motor mount: 6.0 mm thick, U no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
2026-11-14 Mark the status of the stock parts in yellow and red
    * Yellow (measures qualified, no 3D print verification): centre
    driveshaft, motor mount with cap, front and rear wishbones.
    * Red (completely unqualified): pivot blocks, cup joints, rear pinion
    shaft with spur gear and bearing, diff outdrives, inner hinge pins.
    * Status legend in the root readme, the CAD readme and the stock parts
    readme (LaTeX symbols, no emoji characters).
    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
2026-11-14 Add M3 threads to the motor mount and the flange, list all threads
    * Motor mount: M3 threads (tap drill 2.5 mm, 7.0 mm deep) for the screws
    from below through H09 and H10 and for the 2 screws M3x18 of the cap.
    * Flange of the rear pinion shaft: 4 M3 threads for the screws of the
    spur gear.
    * CAD readme: table of all M3 threads of the bulkheads for the CNC order
    (drill and thread depths), list of the clearance holes and of the
    threads of the stock parts. The verified parts already had all M3
    threads (tap drill holes); no change to them.
    * Assembly regenerated: no new overlaps.
    Claude-Session: https://claude.ai/code/session_012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
2026-11-14 Model the rear pinion shaft, the pinion and the spur gear in detail
    * Rear pinion shaft NBA205 in sections: press fit shape with two flats
    for the pinion and an axial M3 thread for the pinion screw M3x6,
    bearing section, flange 21.7 x 2.5 mm with 4 M3 threads, spigot 9.3 mm
    through the spur gear, shoulder 6.7 mm that holds the bearing in the
    motor mount, press fit shape for the cup joint with the retaining pin.
    * Pinion NBA207: 17 teeth (owner), 14.1 mm, simplified straight bevel
    gear with the press fit bore and the countersink of the screw.
    * 2 bearings NBA298 in the pinion seat of the bulkhead.
    * Spur gear: bore 9.4 mm, screw circle and lightening holes from photos.
    * Cup joint: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
2026-11-14 Model the pinion teeth as a straight bevel gear
    * Pinion NBA207: the tooth profile is lofted from the back end to a
    profile scaled toward the apex of the pitch cone (pitch cone angle
    22 degrees, apex 15.6 mm in front of the back face), so the teeth
    converge as on the real part; length 4.5 mm from the side photo.
    * Rear pinion shaft starts 0.5 mm earlier (below the pinion screw head).
    * Assembly regenerated (35 parts): no new overlaps.
    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
2026-11-14 Cross hole for the retaining pin of the cup joint in the rear pinion shaft
    * The retaining pin NBA255 2.0 x 7.6 mm is a separate part now
    (rear_drive/retaining_pin_2x7.6_NBA255); the press fit section of the
    rear pinion shaft has a cross hole of 2.0 mm for it, in line with the
    cross hole of the cup joint.
    * Assembly regenerated (36 parts): no new overlaps.
    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
2026-11-14 Mark the rear drive line yellow (measures qualified)
    * Rear pinion shaft with pinion, spur gear, bearings and retaining pin:
    measures qualified, no 3D print verification (owner: no further
    measurements required). Root readme, CAD readme, stock parts readme.
    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
2026-11-14 Model the front pinion shaft (End A)
    * Front pinion shaft NBA205 with the same sections as the rear one
    (press fit shapes with flats, axial M3 thread for the pinion screw,
    section for the 2 bearings of the bulkhead, cross hole for the
    retaining pin of the cup joint), without flange, spur gear and motor
    mount: 19.55 mm long. Pinion, bearings and retaining pin at End A,
    turned by 180 degrees with the front bulkhead.
    * File cad/stock_parts/front_drive/front_pinion_shaft_T410R (STEP, STL).
    * Status yellow (measures qualified, no 3D print verification).
    * Assembly regenerated (41 parts): no new overlaps.
    Claude-Session: https://cl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
2026-11-14 Model the differentials with ring gear 42T and bearings NBA299
    * Diff case (26.0 mm over 10.5 mm from the teeth, owner; taper and hubs
    from photos), ring gear 42T 31.8 mm (owner) with the teeth toward the
    case and the pinion, 2 bearings NBA299 10x15x4 at x = +-11 to +-15 mm
    (30.0 mm over both, bulkhead measurement no. 28).
    * Fits the verified bulkhead: bearing seats and lips, case cavity
    (0.5 mm), ring gear recess; 1.05 mm below the pinion. Ring gear teeth
    phased to the pinion 17T: no overlap, smallest clearance 0.02 mm.
    * Pinion length 4.1 mm (side photo, large end at the bearing).
    * Diff outdrives with a shank 10 mm through the bearing.
    * Files in cad/stock_parts/diff, status yel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
2026-11-14 Model the inner parts of the differential, add the diff drawing
    * Inner parts (owner: photos and description): 2 side gears 14T on the
    hexagon press fit with 3 shims each, 2 spider gears 9T on the cross
    pin with 1 shim each; module 1.0, pitch cone angles 57.3 / 32.7
    degrees; teeth turned into the tooth gaps.
    * Ring gear: central opening for the side gear, hexagon bore through
    the hub for the shaft of the outdrive, journal 10 mm for the bearing,
    4 clearance holes M2 for the screws into the case (tap holes M2 in
    the case). Case hollowed with flat walls for the spider shims, bores
    and slots for the cross pin, hexagon bore and journal in its hub.
    * Outdrives: hexagon shaft from the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
2026-11-14 Ring gear 3.8 mm thick, spool at End A, differential inset in the assembly
    * Ring gear 42T: 3.8 mm from the back face (plate side) to the tips of
    the teeth (owner): back face at x = 8.7 mm, tips unchanged (mesh with
    the pinion).
    * Spool at End A (owner: front spool): solid body with flange (4 tap
    holes M2), spigot in the ring gear opening, journals and hexagon
    bores for both outdrives; same ring gear, bearings and outdrives.
    File cad/stock_parts/diff/spool_T410R, status yellow.
    * Assembly picture: inset with the differential at End B in section;
    legend note moved below the legend. Differential drawing with the
    spool. Assembly (58 parts): no new overlaps.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
